kaszmirek/Inzynierka/thesis/my_thesis/sources/09_dodatek_datasheety.tex

\chapter{Schematy i noty katalogowe}
\markboth{Schematy i noty katalogowe}{Schematy i noty katalogowe}

\begin{figure}
    \centering
    
\end{figure}

\begin{figure}
    
\end{figure}

\begin{figure}
    
\end{figure}

\begin{figure}
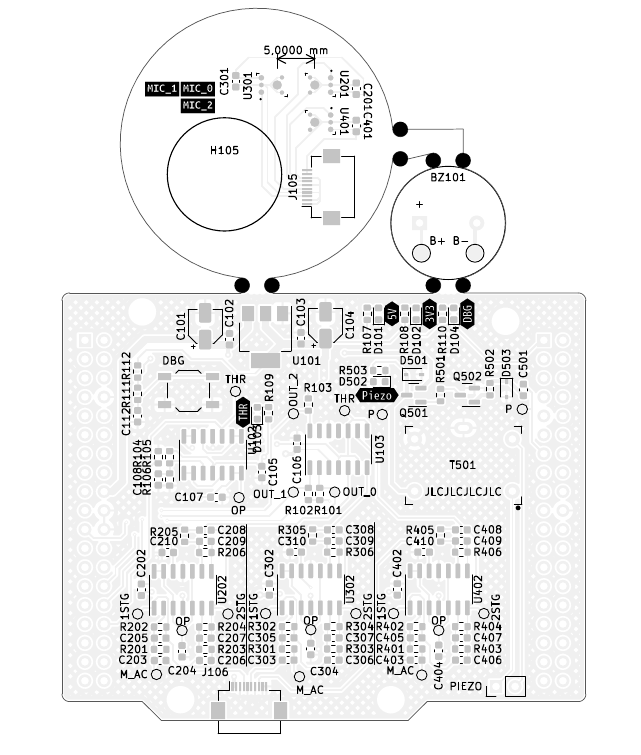
[picture p11: thesis/my_thesis/figures/chapter_09/board_render.png]
    
\end{figure}
