kaszmirek/Inzynierka/thesis/praca_dyplomowa_wzor/sources/07_dodatek_bakiem_malowane.tex

\chapter{Bąkiem malowane}
\markboth{Bąkiem malowane}{Bąkiem malowane}

Ponieważ niektóre otrzymywane ślady ruchu bąków bywały niezwykle artystyczne i wprawiały nas w zdumienie zdecydowaliśmy się pokazać co ciekawsze ku uciesze czytelnika. Zestaw śladów, który najbardziej przypadł nam do gustu przedstawiono na rysunku \ref{fig:top_life} \cite{Joniak}.
\begin{figure}[tp]
  \centering
  
  \caption{Atom}
\end{figure}
%
\begin{figure}[tp]
  \centering
  
  \caption{Słonecznik}
\end{figure}
%
\begin{figure}[tp]
  \centering
  
  \caption{Kwiat}
\end{figure}
%
\begin{figure}[tp]
  \centering
  
  \caption{Gwiazda}
\end{figure}
%
\begin{figure}[tp]
  \centering
  
  \caption{Paszcza}
\end{figure}
%
\begin{figure}[tp]
  \centering
  \subfloat{}
  \subfloat{}\\
  \subfloat{}
  \subfloat{}\\
  \subfloat{}
  \subfloat{}
  \caption{Życie bąka}
  \label{fig:top_life}
\end{figure}

{\red
  Czasami pojawia się potrzeba umieszczenia w~pracy dodatków. Wówczas
  wystarczy poprzedzić je poleceniem \texttt{\textbackslash appendix}
  i~voilà, mamy co potrzebowaliśmy. Tu można umieszczać rzeczy
  poboczne, kod programu, dowód jakiegoś twierdzenia, w~większej
  liczbie symulacje, wyniki, czy też może jakąś galerię \smiley}
