kaszmirek/Inzynierka/thesis/praca_dyplomowa_wzor/main.tex

%\documentclass[printmode,oneside,pl]{mgr}  % do publikacji elektronicznej
\documentclass[printmode,pl]{mgr}  % do wydruku dwustronnego
%\documentclass[printmode,pl,draft]{mgr}  % do wydruku dwustronnego w~wersji roboczej
%\documentclass[printmode,en]{mgr}  % do wydruku dwustronnego ze stroną tytułową w~wersji angielskiej

%----------------------| Wybór strony kodowej |------------------------

\usepackage[utf8]{inputenc}

%-------------------------| Wybór kroju pisma |------------------------

%% Najpierw (chyba) należy wybrać czcionkę tekstu, potem matematyki
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
%\usepackage{fancyhdr}
%\usepackage{fancyvrb}
%\usepackage{lipsum}  
%\usepackage{listings}  %% alternatywa do używanego tutaj pakietu minted 

%-----------------------| End of pakietologia |----------------------

%---------------------------| Tytularia |---------------------------

% Zmień dane stosownie do tytułu i autora pracy tutaj
% ALE TEŻ I W POLECENIU \pdftitle NIECO PONIŻEJ! (Hyper data general configuration)
\author{Roberto Orozco\\{\color{red}Robert Muszyński\\\footnotesize (kompilacja \today)}}
\title{Bąk jaki jest każdy widzi. Studium zachowań\\{\em\color{red} Przykład
    i~wytyczne formatowania\\ pracy dyplomowej}}
\engtitle{Top is a top. Case study}
\supervisor{Dr inż. Robert Muszyński,\\ Katedra Cybernetyki i~Robotyki}
\field{Automatyka i~Robotyka (AIR)}
\specialisation{Robotyka (ARR)}
\date{2022}

%-------------------------| Hyper data general configuration |------------------------

\hypersetup{unicode,
                          % DANE DOKUMENTACJI
   pdfauthor={Roberto Orozco, Robert Muszyński},
   pdftitle={Bąk jaki jest każdy widzi. Studium zachowań - Przykład
    i~wytyczne formatowania pracy dyplomowej},
   pdfsubject={Praca dyplomowa inżynierska - przykład i~wytyczne},
   pdfkeywords={bąk, Lagrange top, Euler top, praca dyplomowa, formatowanie, wytyczne},
                          % USTAWIENIA DOKUMENTU
   pdfpagemode=UseOutlines,   % otwiera dokument w trybie jednej strony
   pdfpagelayout=SinglePage,  %
   pdfstartview={Fit},        %
   pdfstartpage=1,            % na podanej stronie
   bookmarksopen=true,        % rozwinięcie zakładek
   bookmarksopenlevel=1,      % do jakiego poziomu
   colorlinks=true,       % kolorowanie odnośników zamiast ramki wokół nich
   breaklinks,            %
   citecolor=cyan,        % kolor odnośników do bibliografii, domyślnie zielony
   filecolor=red,         % kolor odnośników do lokalnych plików, domyśnie magenta
   linkcolor=blue,        % kolor odnośników wewnętrznych, domyślnie czerwony
   menucolor=green,       % kolor pozycji menu Acrobata, domyślnie czerwony
   urlcolor=blue          % kolor odnośników do adresów internetowych, domyślnie cyan
}

%-------------------------| Geometria strony |-----------------------------

\geometry{
    top = 25mm,
    headheight = 15mm,
    headsep = 3mm,
    textheight = 24cm,
    textwidth = 16cm,
    marginparwidth = 25mm
}

%---------------------| Często używane polecenia |-------------------

\newcommand{\red}{\color{red}}
\def\BibTeX{{\rm B\kern-.05em{\sc i\kern-.025em b}\kern-.08em
    T\kern-.1667em\lower.7ex\hbox{E}\kern-.125emX}}

\newtheorem{uwaga}{Uwaga}
\newtheorem{twr}{Twierdzenie}
%------------------------------------| END |-------------------------------------

%----------------------------| Definicje symboli matematycznych |-------------------------

\newcommand{\angmom}{\boldsymbol{m}}
\newcommand{\bdvelo}{\boldsymbol{\omega}_B}
\newcommand{\grav}{\boldsymbol{g}}
\newcommand{\lagran}{L(\boldsymbol{q},\boldsymbol{\dot{q}})}
\newcommand{\COMvec}{\boldsymbol{r}_B}
\newcommand{\ee}{\boldsymbol{e}}
\newcommand{\FF}{\boldsymbol{F}}
\newcommand{\xx}{\boldsymbol{x}}
\newcommand{\qq}{\boldsymbol{q}}
\newcommand{\RR}{\boldsymbol{R}}
\newcommand{\TT}{\boldsymbol{T}}
\newcommand{\pp}{\boldsymbol{p}}
\newcommand{\iner}{\boldsymbol{I}_B}
\newcommand{\vv}{\boldsymbol{v}}
\newcommand{\bbs}{\boldsymbol}
\DeclareMathOperator{\const}{const}
\DeclareMathOperator*{\rank}{rank}  %star changes sub- and superscripts placement
%------------------------------------| END |-------------------------------------

%--------------------------| Ścieżki do rysunków |-------------------------------

\graphicspath{{./figures/chapter_01/}{./figures/chapter_02/}{./figures/chapter_03/}{./figures/chapter_04/}}

%--------| kontrola dołączanych plików - wygodne przy pracy nad tekstem |--------

%\includeonly{sources/Od_Autora,sources/02_czym_jest_bak}

%-------------------------| The document starts here |-------------------------------
\begin{document}

\pdfbookmark{Strona tytułowa}{tytul}
\maketitle
%% informacja o sposobie udostępniania tego dokumentu
\input{sources/copyleft.tex}

%% dedykacja
%%\dedication{6cm}{To jest przykładowa treść opcjonalnej dedykacji,
%%  należy ją zmienić lub usunąć w całości polecenie
%%  \texttt{\textbackslash dedication}}

\cleardoublepage
\pdfbookmark{\contentsname}{Contents}
\tableofcontents            %spis treści
\markboth{\contentsname}{\contentsname}
\input{sources/notka}       %notka o systemie składu i czcionkach
%\input{sources/font-note}   %przykładowa wersja angielska notki - używa pakietu biblatex

%---------------------------| Część właściwa dokumentu |---------------------------

\include{sources/Od_Autora}
\include{sources/00_Wstep}
\include{sources/01_wprowadzenie_matematyczne}
\include{sources/02_czym_jest_bak}
\include{sources/05_zakonczenie}

\cleardoublepage
\phantomsection
\addcontentsline{toc}{chapter}{\bibname}
\bibliographystyle{alphapl}
\bibliography{sources/bibliografia}
\markboth{\bibname}{\bibname}   % to niestety nie działa by usunąć MakeUppercase z~nagłówków w~literaturze

%%spis tabel
%\cleardoublepage
%\phantomsection
%\listoftables
%\addcontentsline{toc}{chapter}{\listtablename}
%\markboth{\listtablename}{\listtablename}

%%spis rysunków
\cleardoublepage
\phantomsection
\addcontentsline{toc}{chapter}{\listfigurename}
\listoffigures
\markboth{\listfigurename}{\listfigurename}

\appendix
\include{sources/07_dodatek_bakiem_malowane}

%% lista rzeczy do zrobienia
\listoftodos

\end{document}
