kaszmirek/Inzynierka/thesis/praca_dyplomowa_wzor/svg-inkscape/e1_plot_1_svg-tex.pdf

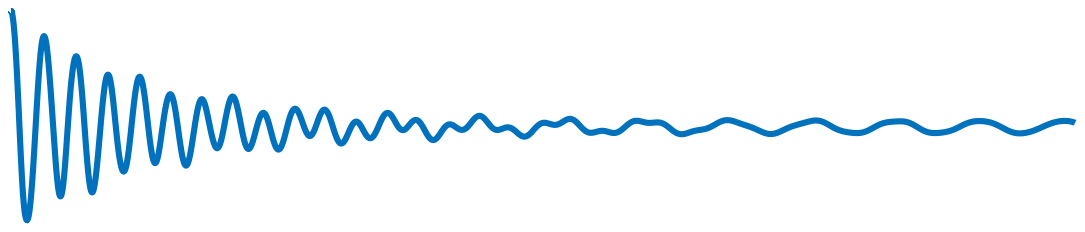
[picture p29: page 3]
