kaszmirek/Inzynierka/thesis/praca_dyplomowa_wzor/figures/chapter_02/dynamic-lin.pdf

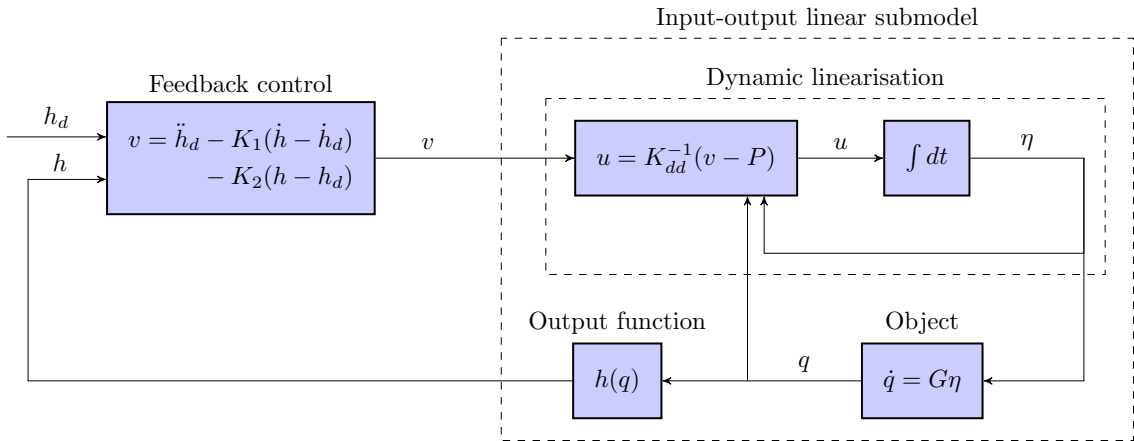
[picture p30: figure]
Feedback control; Object; Output function; Input-output linear submodel; Dynamic linearisation
