kaszmirek/Inzynierka/thesis/praca_dyplomowa_wzor/figures/chapter_02/dynamic-lin_ink.pdf

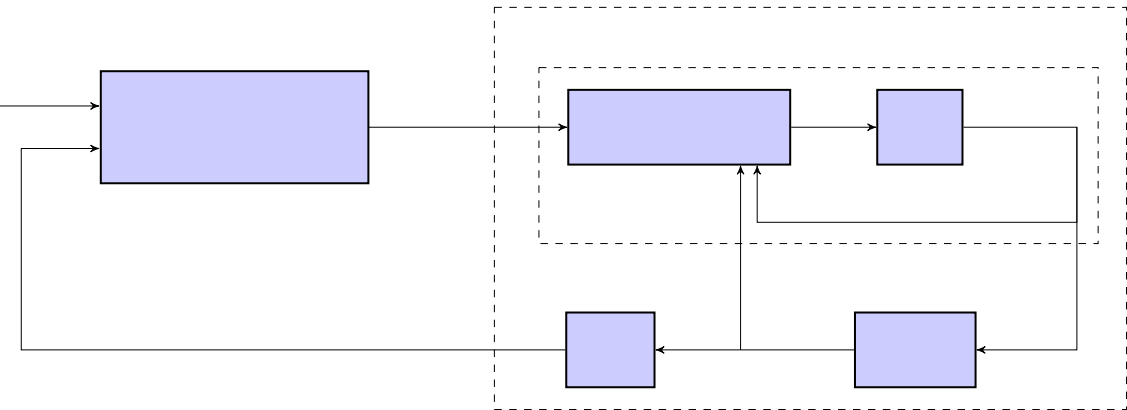
[picture p31: figure]
