kaszmirek/Inzynierka/thesis/praca_dyplomowa_wzor/figures/chapter_02/legendre_fv_interp.pdf

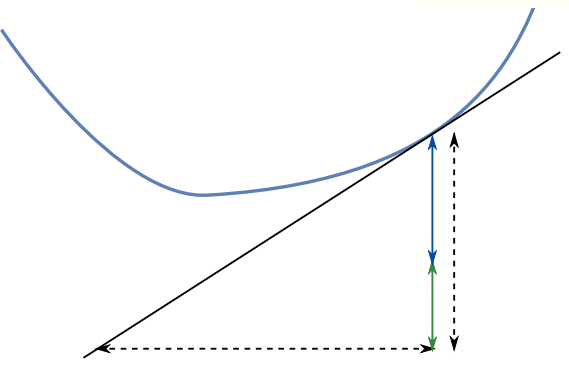
[picture p32: figure]
