kaszmirek/Inzynierka/thesis/praca_dyplomowa_wzor/figures/chapter_02/przemieszczenie.pdf

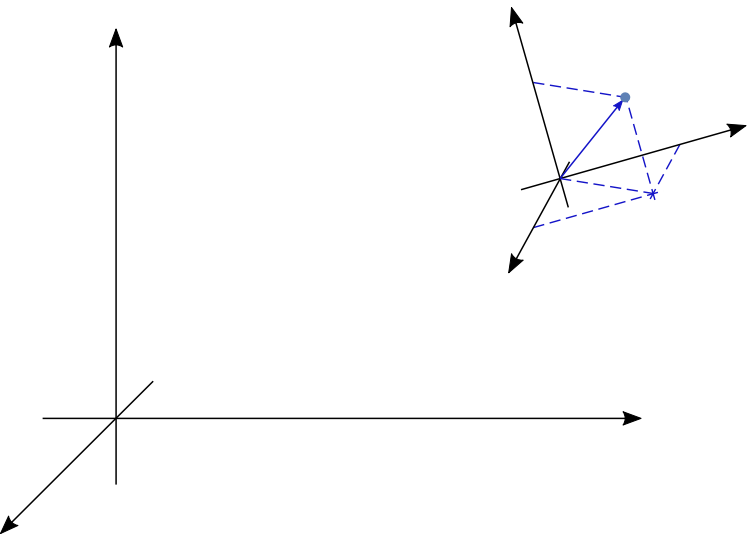
[picture p33: figure]

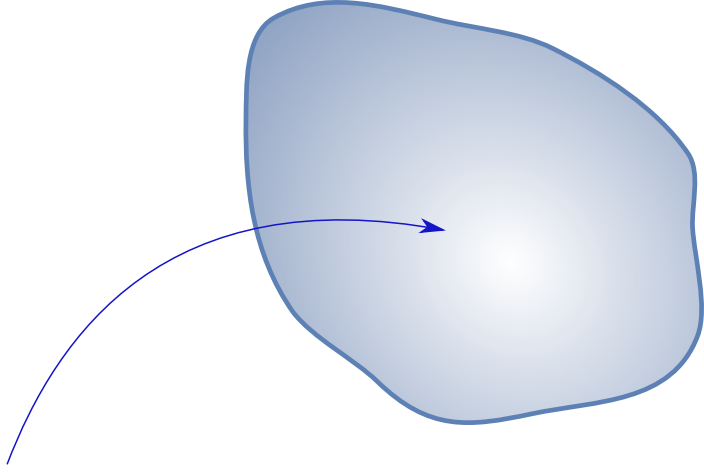
[picture p34: figure]
