kaszmirek/Inzynierka/thesis/praca_dyplomowa_wzor/figures/chapter_03/bak_eulera.pdf

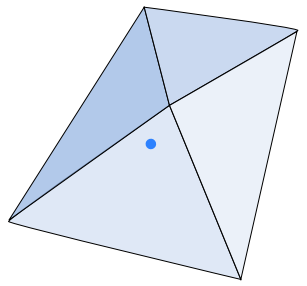
[picture p35: figure]
