kaszmirek/Inzynierka/thesis/praca_dyplomowa_wzor/figures/chapter_03/bak_lagrangea1.pdf

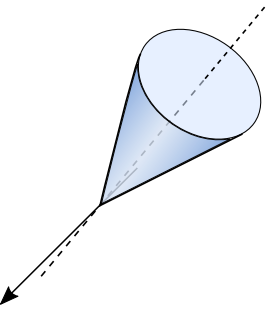
[picture p36: figure]
