kaszmirek/Inzynierka/thesis/praca_dyplomowa_wzor/figures/chapter_03/bak_ogolnie.pdf

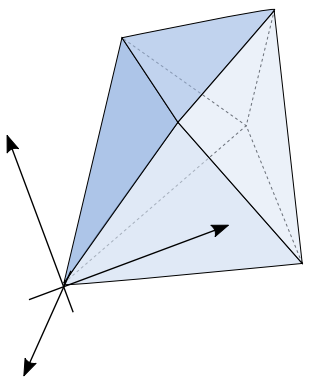
[picture p37: figure]
