kaszmirek/Inzynierka/thesis/praca_dyplomowa_wzor/figures/chapter_04/elipsoida1a.pdf

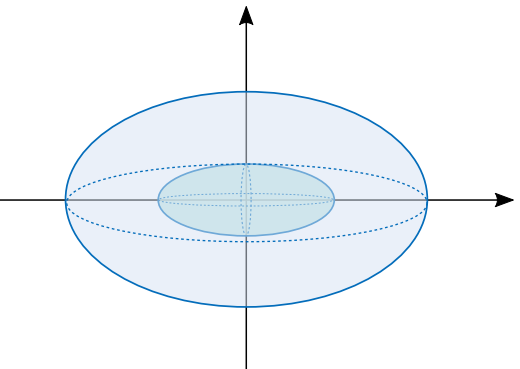
[picture p38: figure]
