kaszmirek/Inzynierka/thesis/praca_dyplomowa_wzor/figures/chapter_04/elipsoida1b.pdf

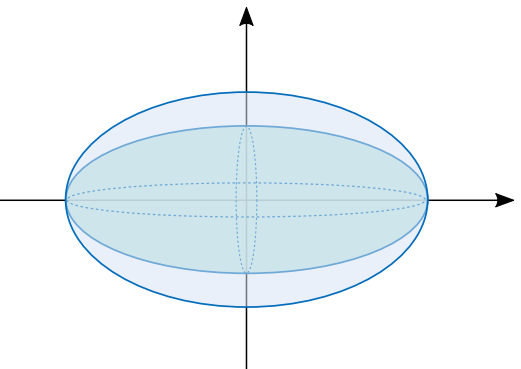
[picture p39: figure]
