kaszmirek/Inzynierka/thesis/praca_dyplomowa_wzor/figures/chapter_04/elipsoida1c.pdf

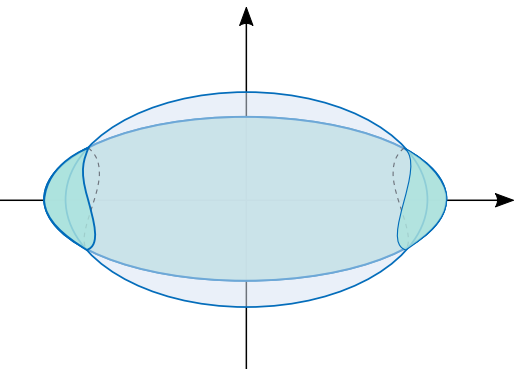
[picture p40: figure]
