kaszmirek/Inzynierka/thesis/praca_dyplomowa_wzor/figures/chapter_04/elipsoida1d.pdf

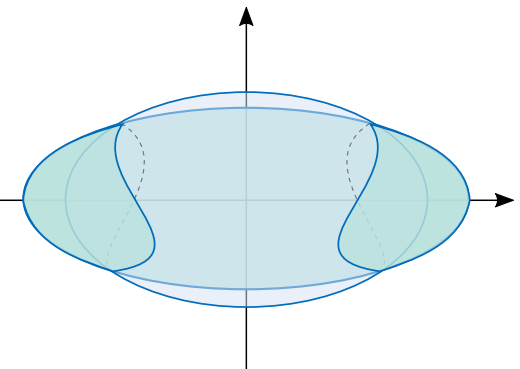
[picture p41: figure]
