kaszmirek/Inzynierka/thesis/praca_dyplomowa_wzor/figures/chapter_04/elipsoida1e.pdf

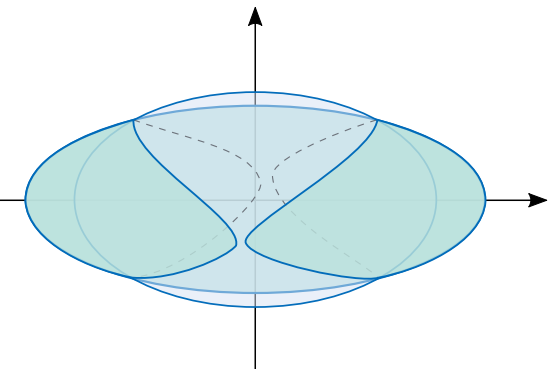
[picture p42: figure]
