kaszmirek/Inzynierka/thesis/praca_dyplomowa_wzor/figures/chapter_04/elipsoida_obrotowa.pdf

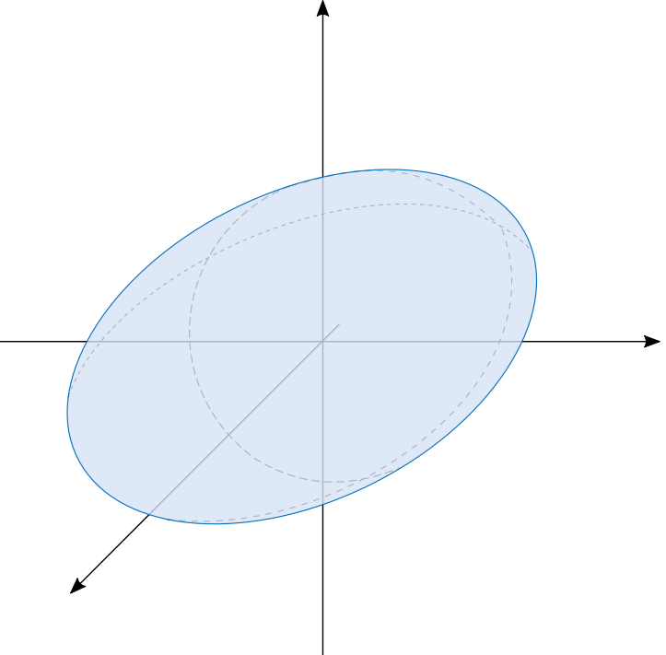
[picture p47: figure]
