kaszmirek/Inzynierka/thesis/praca_dyplomowa_wzor/figures/chapter_04/euler_sym_portret.pdf

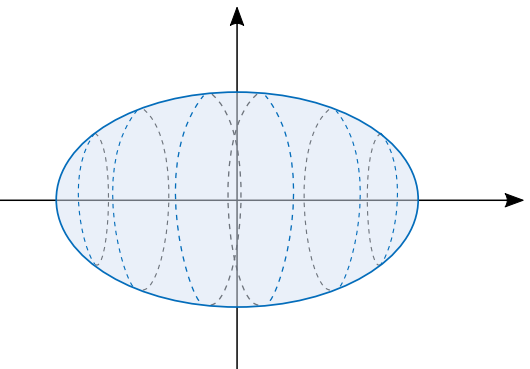
[picture p48: figure]
