kaszmirek/Inzynierka/thesis/praca_dyplomowa_wzor/figures/chapter_04/herpolhodia.pdf

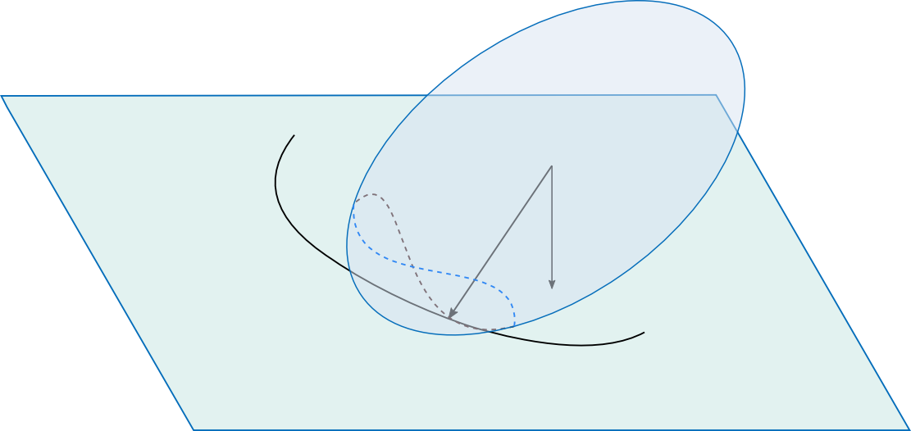
[picture p49: figure]
