kaszmirek/Inzynierka/thesis/praca_dyplomowa_wzor/figures/chapter_04/lu_mniejsze.pdf

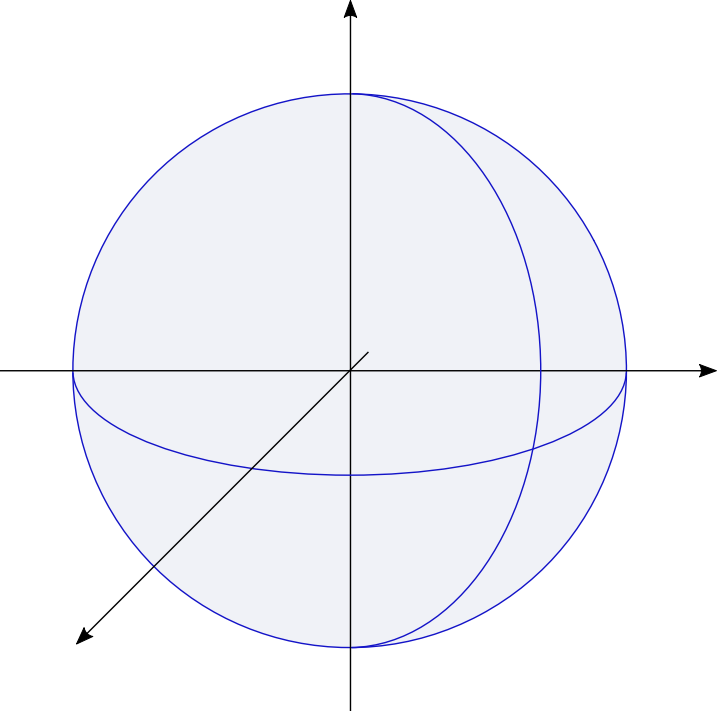
[picture p50: figure]

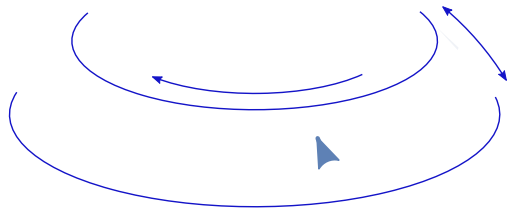
[picture p51: figure]

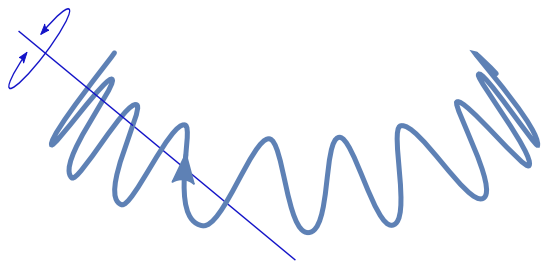
[picture p52: figure]
