kaszmirek/Inzynierka/thesis/praca_dyplomowa_wzor/figures/chapter_04/lu_w_punkt.pdf

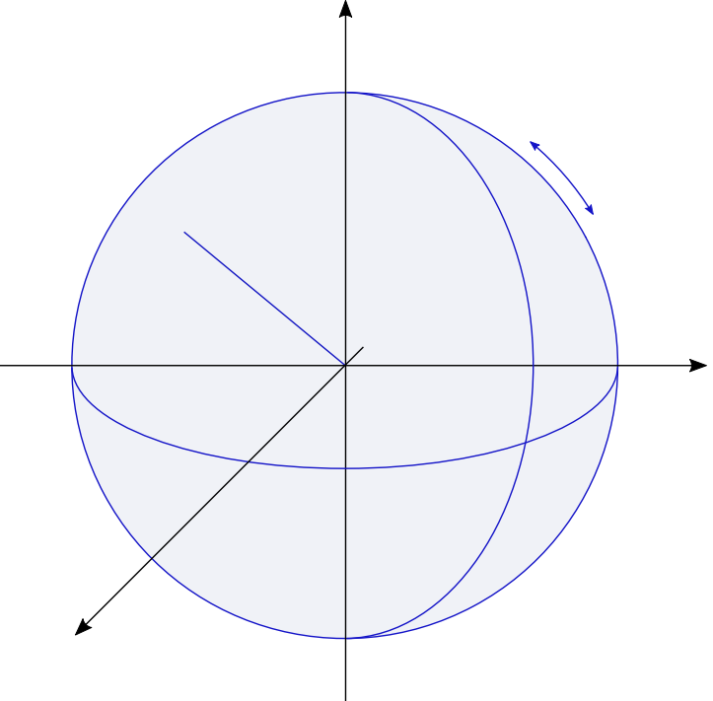
[picture p53: figure]

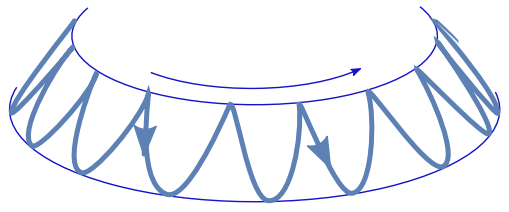
[picture p54: figure]
