kaszmirek/Inzynierka/thesis/praca_dyplomowa_wzor/figures/chapter_04/lu_zmienne.pdf

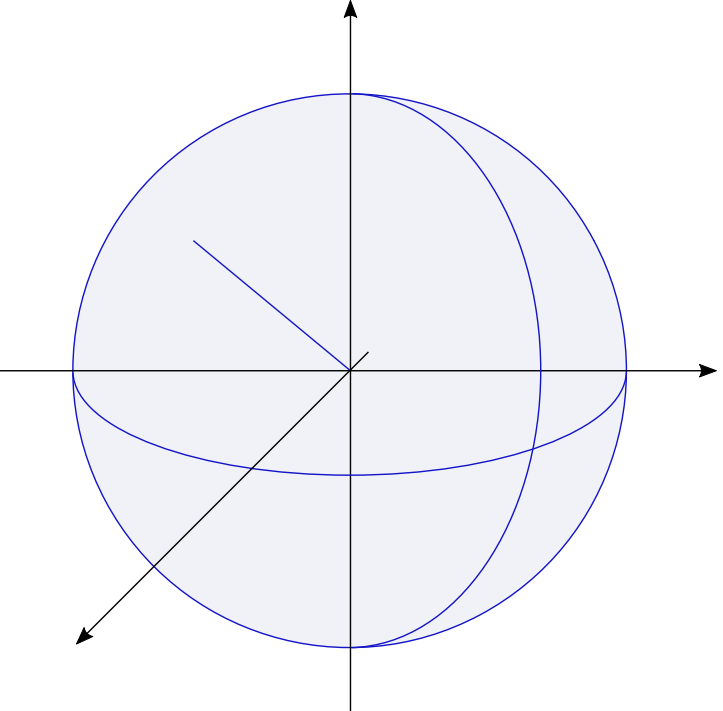
[picture p55: figure]

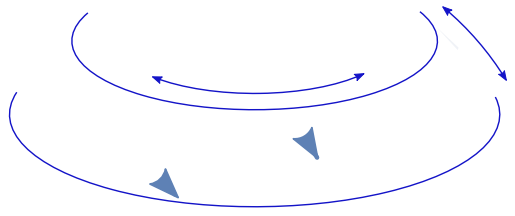
[picture p56: figure]

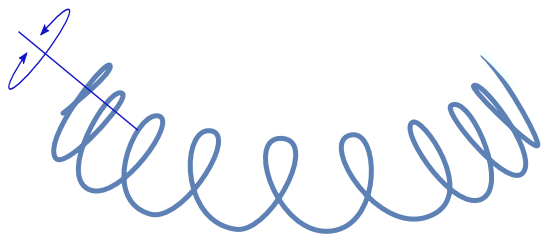
[picture p57: figure]
