kaszmirek/Inzynierka/thesis/praca_dyplomowa_wzor/figures/chapter_04/portret_fazowy.pdf

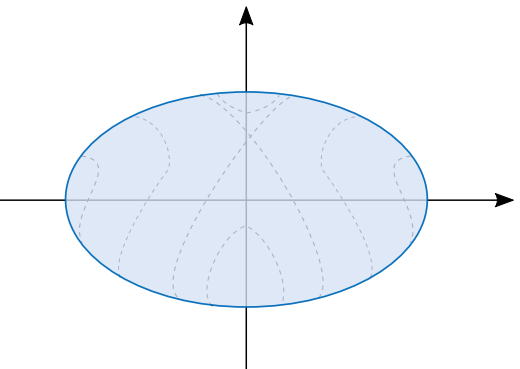
[picture p58: figure]

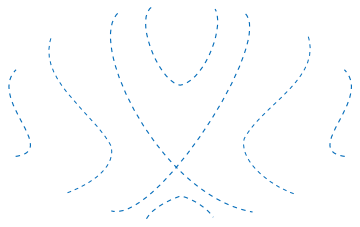
[picture p59: figure]
