kaszmirek/Inzynierka/thesis/praca_dyplomowa_wzor/figures/chapter_05/euler_niesym_elips.pdf

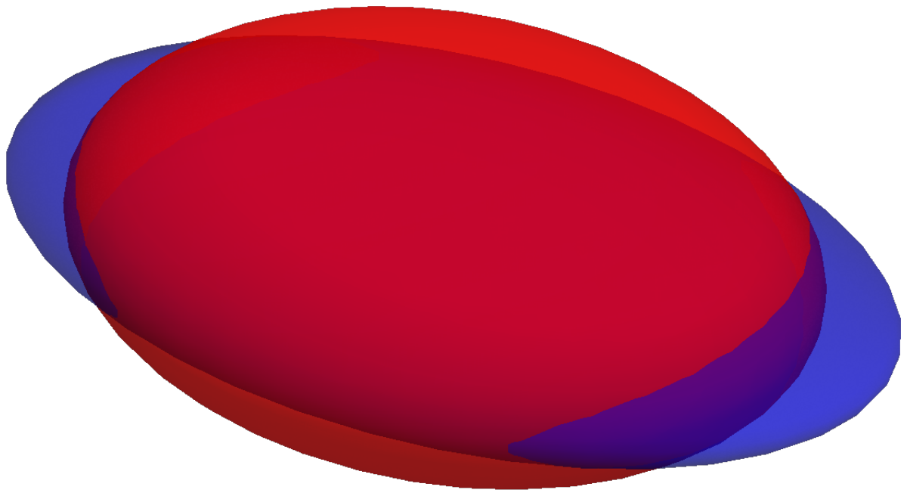
[picture p60: page 1]
