kaszmirek/Inzynierka/thesis/praca_dyplomowa_wzor/figures/chapter_05/euler_niesym_pol.pdf

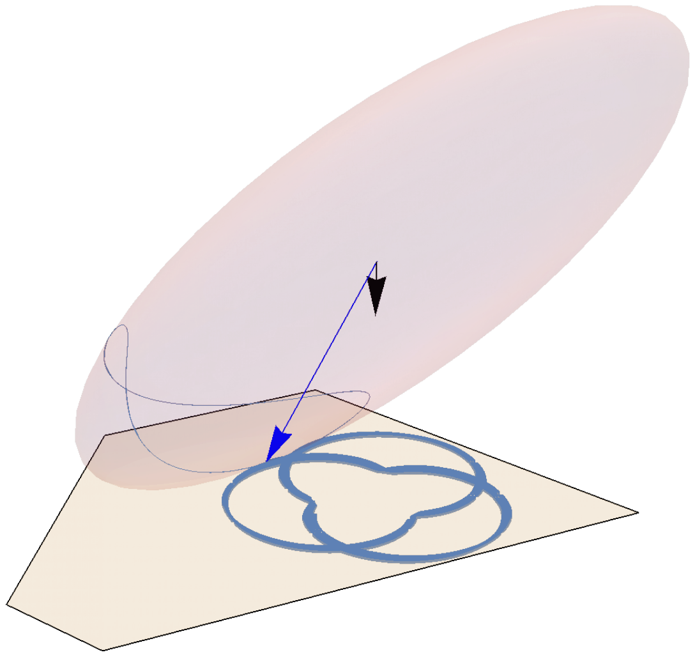
[picture p61: page 1]
