kaszmirek/Inzynierka/thesis/praca_dyplomowa_wzor/figures/chapter_05/euler_sym_elips.pdf

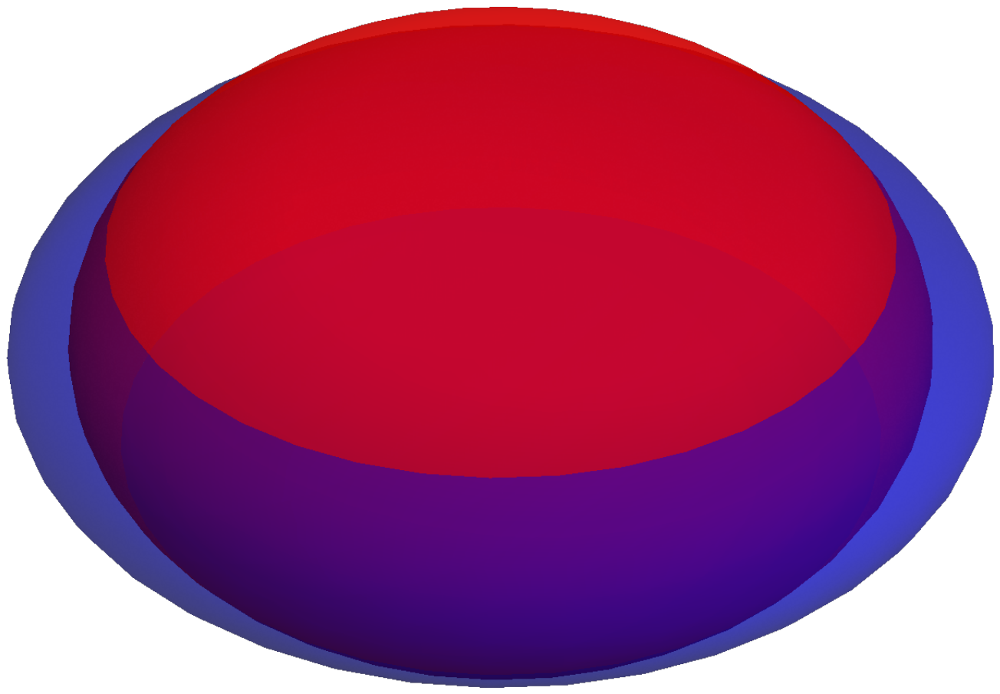
[picture p62: page 1]
