kaszmirek/Inzynierka/thesis/praca_dyplomowa_wzor/figures/chapter_05/euler_sym_pol.pdf

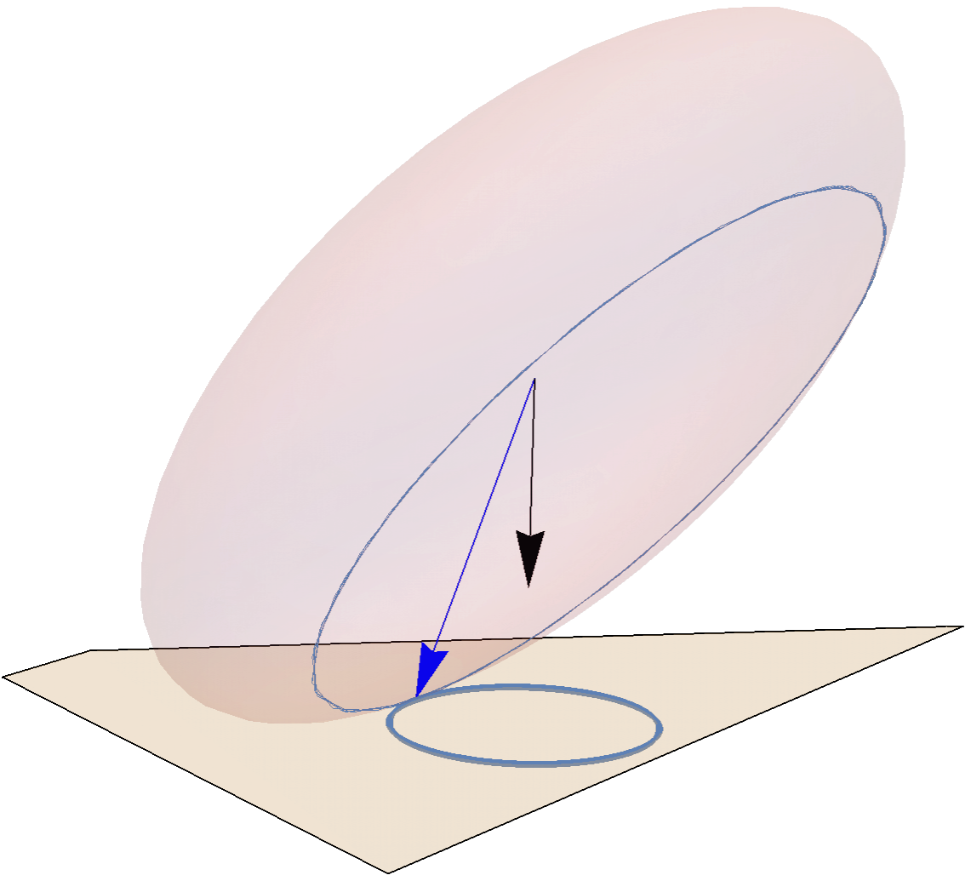
[picture p63: page 1]
