kaszmirek/Inzynierka/thesis/praca_dyplomowa_wzor/figures/chapter_05/sim1_traj.pdf

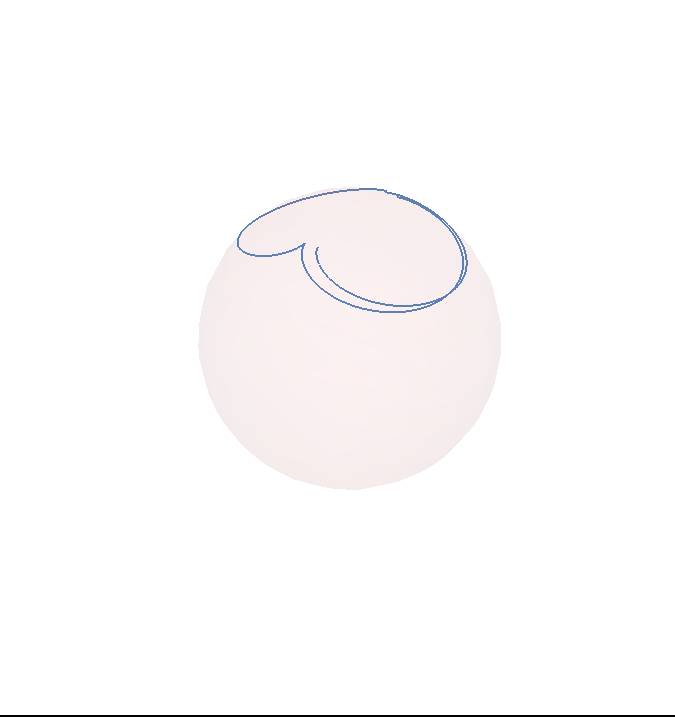
[picture p64: page 1]
