kaszmirek/Inzynierka/thesis/praca_dyplomowa_wzor/figures/chapter_05/sim2_traj.pdf

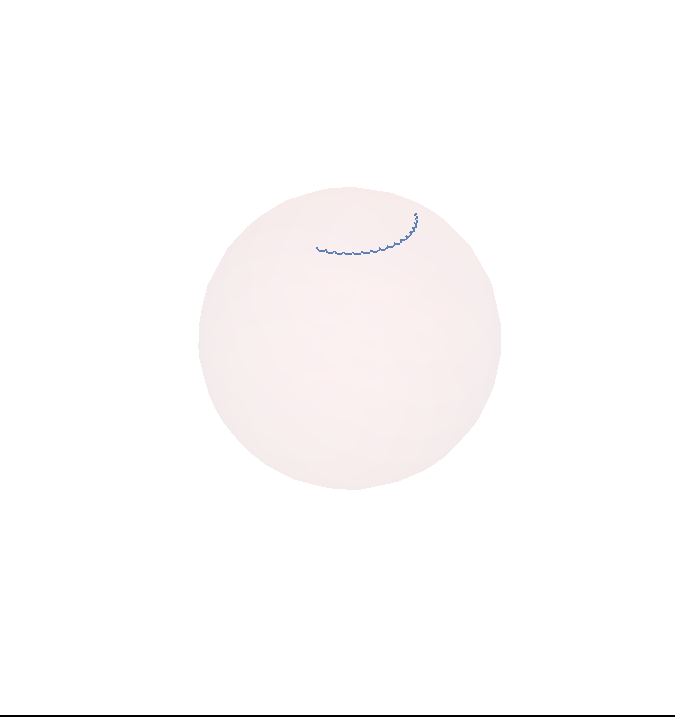
[picture p65: page 1]
