kaszmirek/Inzynierka/thesis/praca_dyplomowa_wzor/figures/chapter_05/sim3_a.pdf

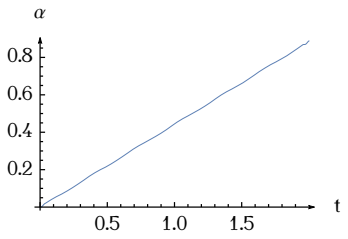
[picture p66: figure]
