kaszmirek/Inzynierka/thesis/praca_dyplomowa_wzor/figures/chapter_05/sim3_traj.pdf

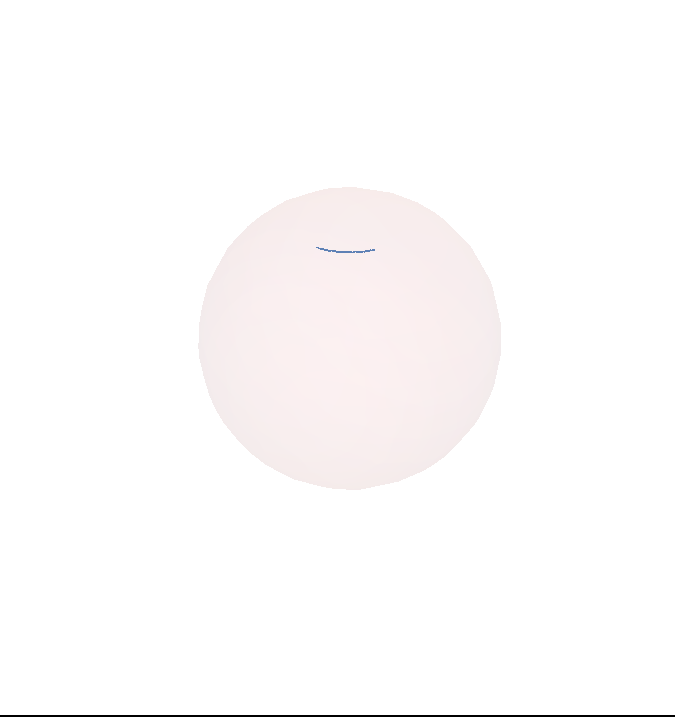
[picture p67: page 1]
