kaszmirek/Inzynierka/thesis/praca_dyplomowa_wzor/figures/chapter_05/ul1_fu.pdf

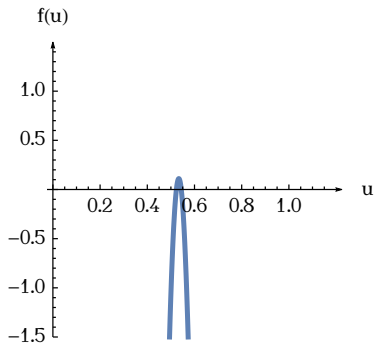
[picture p68: figure]
