kaszmirek/Inzynierka/thesis/praca_dyplomowa_wzor/figures/chapter_05/ul1_trace.pdf

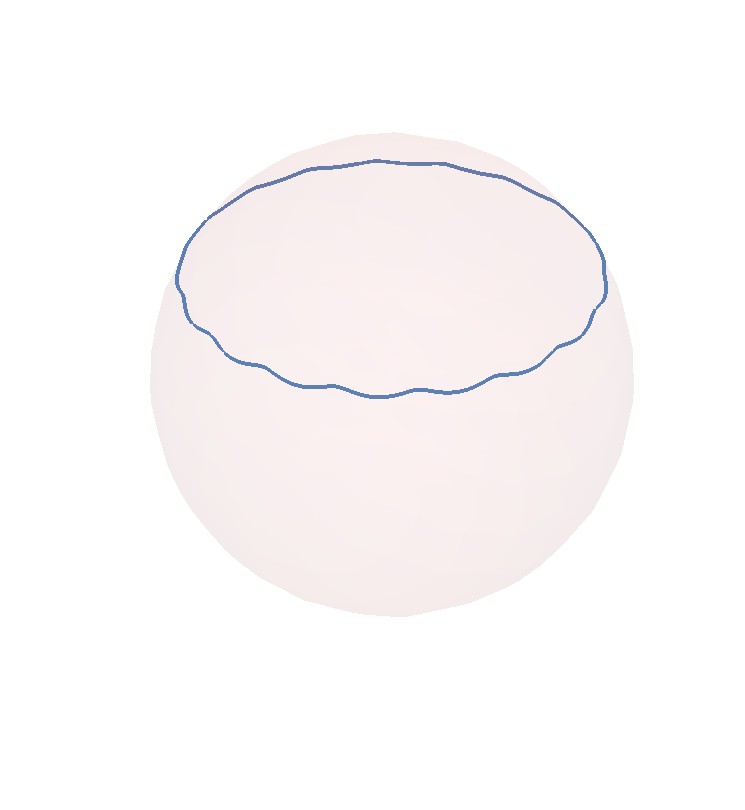
[picture p69: page 1]
