kaszmirek/Inzynierka/thesis/praca_dyplomowa_wzor/figures/chapter_05/ul2_fu.pdf

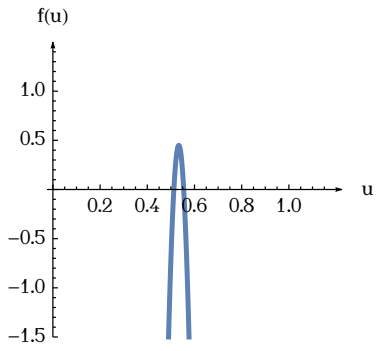
[picture p70: figure]
