kaszmirek/Inzynierka/thesis/praca_dyplomowa_wzor/figures/chapter_05/ul2_trace.pdf

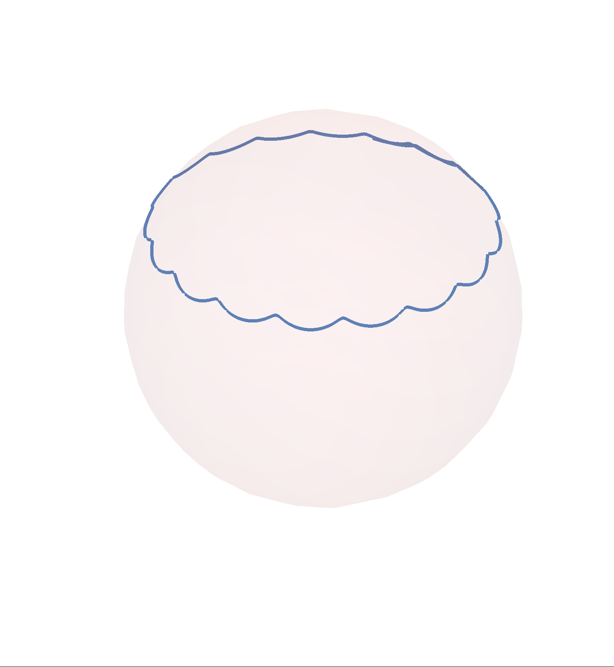
[picture p71: page 1]
