kaszmirek/Inzynierka/thesis/praca_dyplomowa_wzor/figures/chapter_05/ul3_fu.pdf

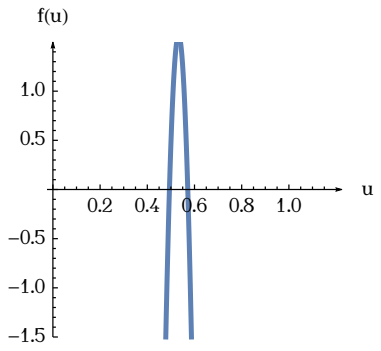
[picture p72: figure]
