kaszmirek/Inzynierka/thesis/praca_dyplomowa_wzor/figures/chapter_05/ul3_trace.pdf

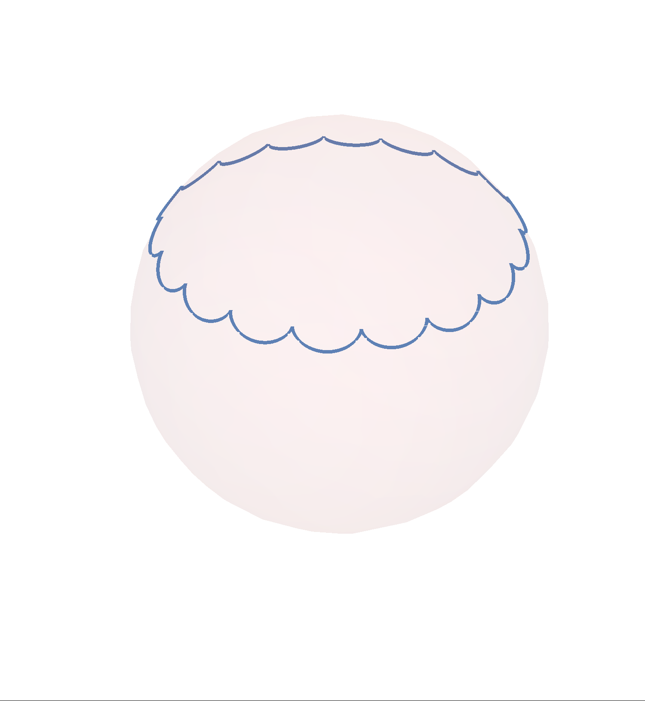
[picture p73: page 1]
