kaszmirek/Inzynierka/thesis/praca_dyplomowa_wzor/figures/chapter_05/ul4_fu.pdf

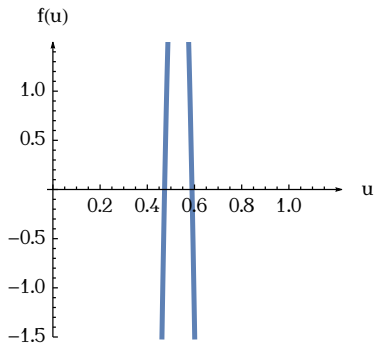
[picture p74: figure]
