kaszmirek/Inzynierka/thesis/praca_dyplomowa_wzor/figures/chapter_05/ul4_trace.pdf

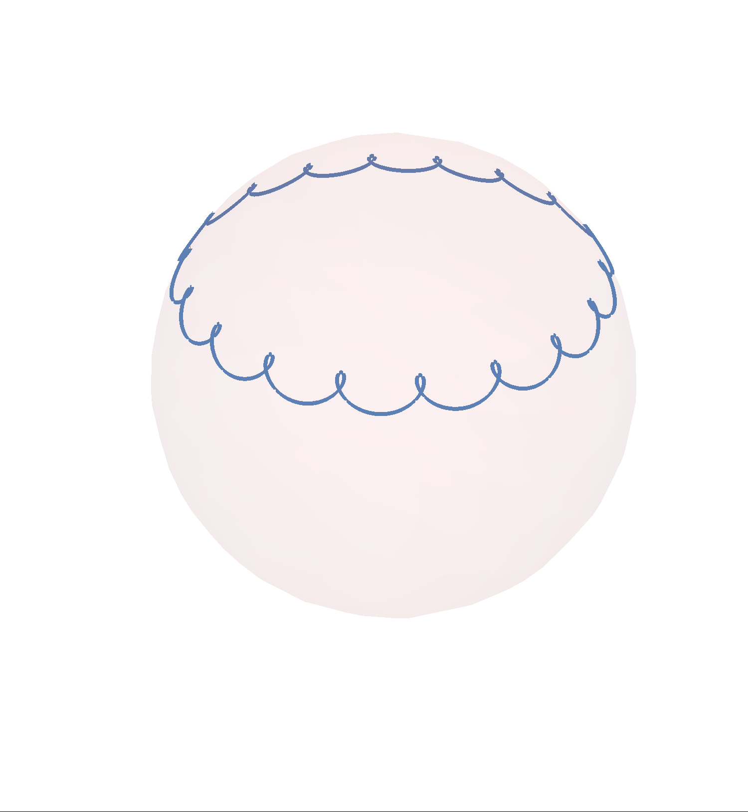
[picture p75: page 1]
