kaszmirek/Inzynierka/thesis/praca_dyplomowa_wzor/figures/chapter_05/ul5_trace.pdf

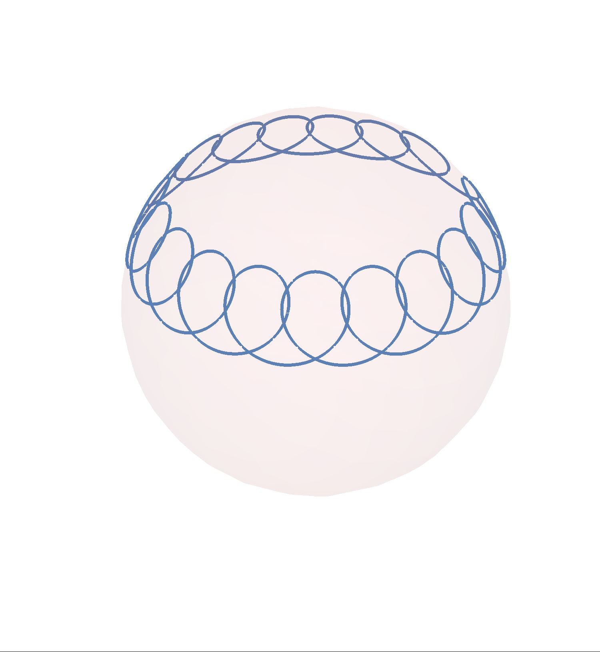
[picture p76: page 1]
