kaszmirek/Inzynierka/thesis/praca_dyplomowa_wzor/figures/chapter_06/mal2.pdf

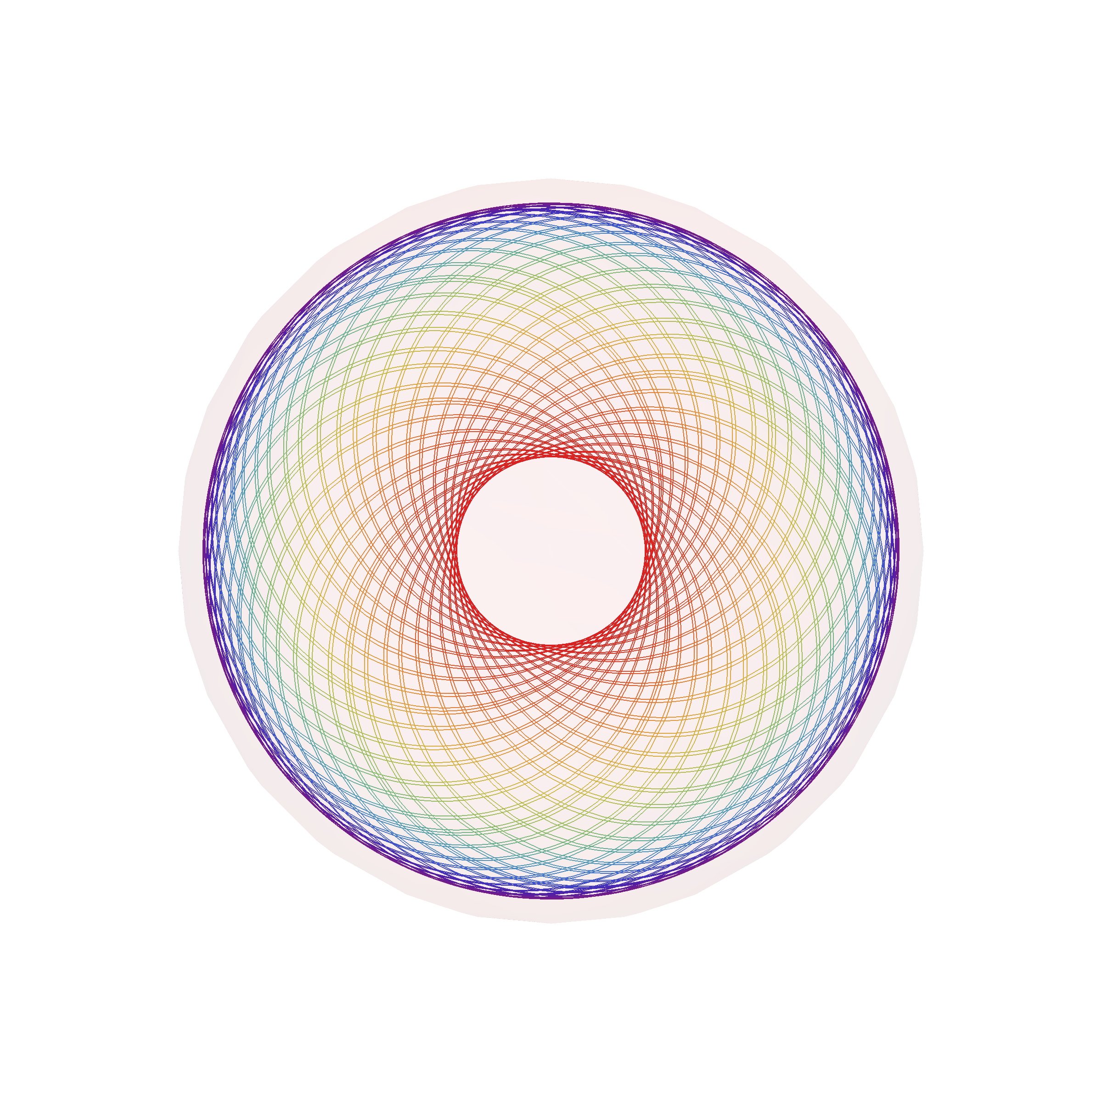
[picture p77: page 1]
