kaszmirek/Inzynierka/thesis/praca_dyplomowa_wzor/figures/chapter_06/mal3.pdf

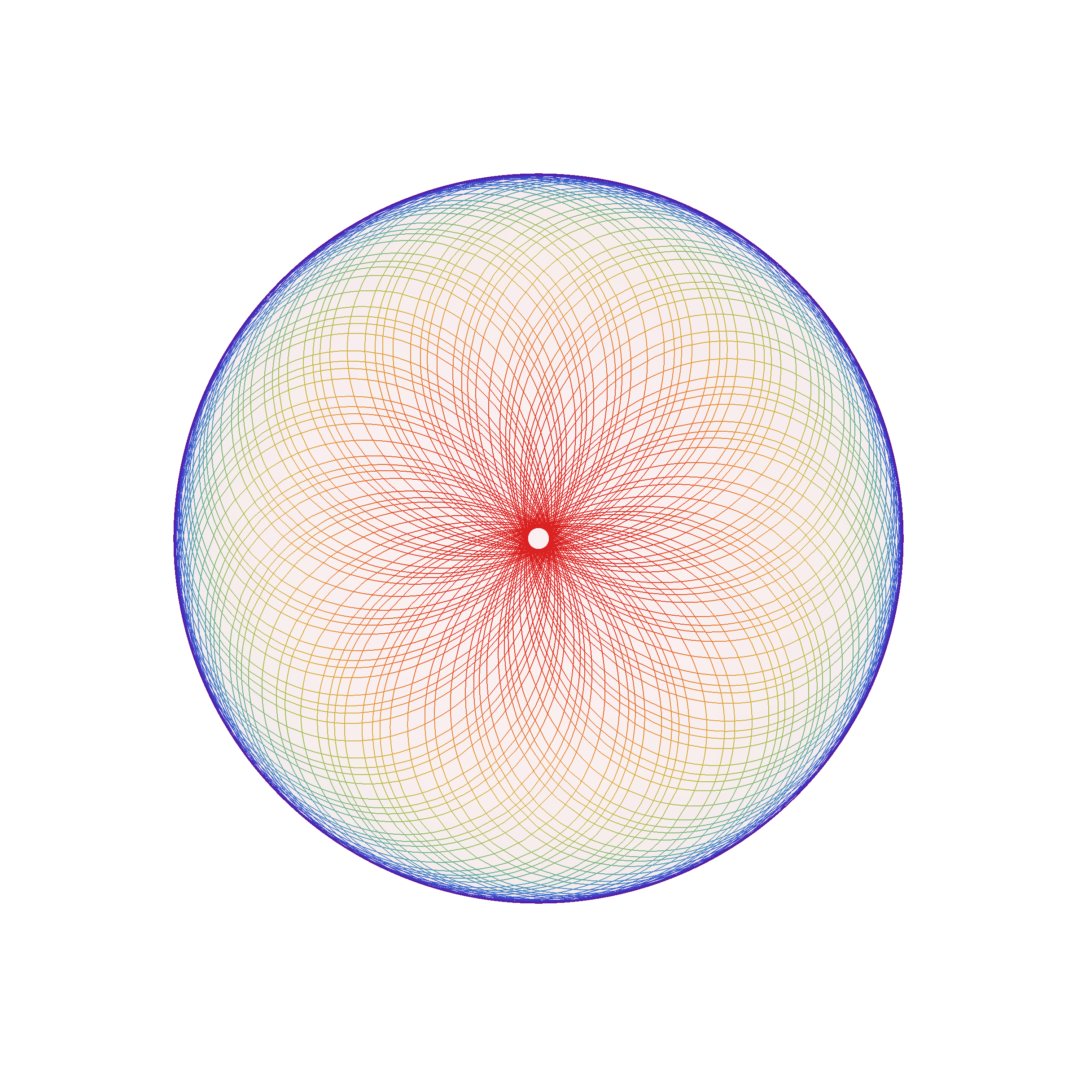
[picture p78: page 1]
