kaszmirek/Inzynierka/thesis/praca_dyplomowa_wzor/figures/chapter_06/mal4.pdf

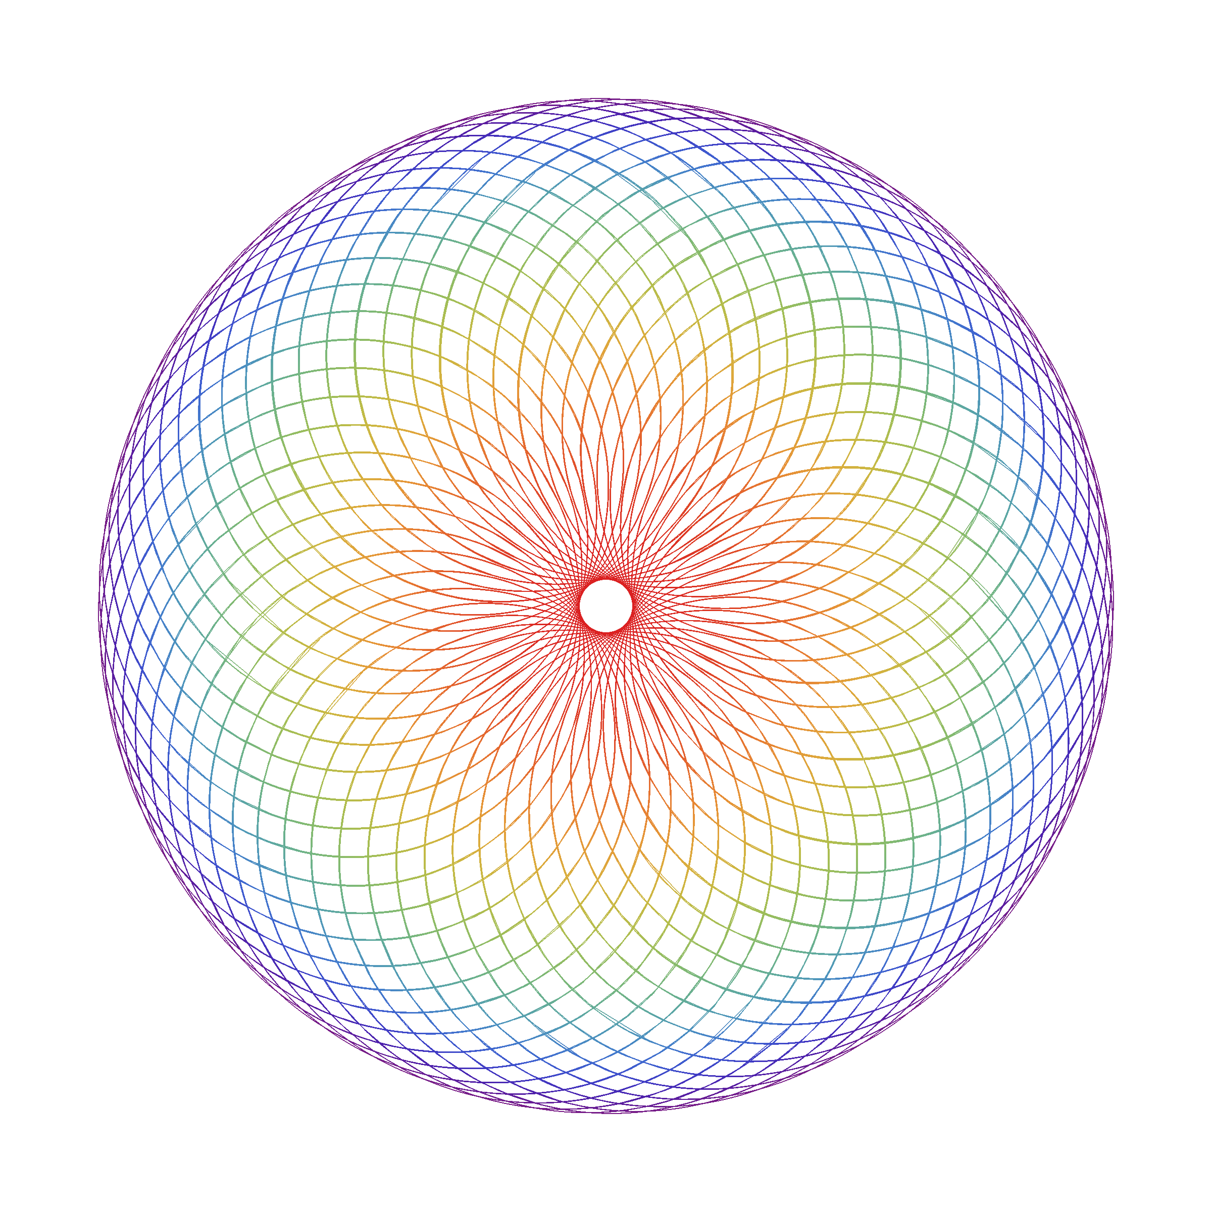
[picture p79: page 1]
