kaszmirek/Inzynierka/thesis/praca_dyplomowa_wzor/figures/chapter_06/mal5.pdf

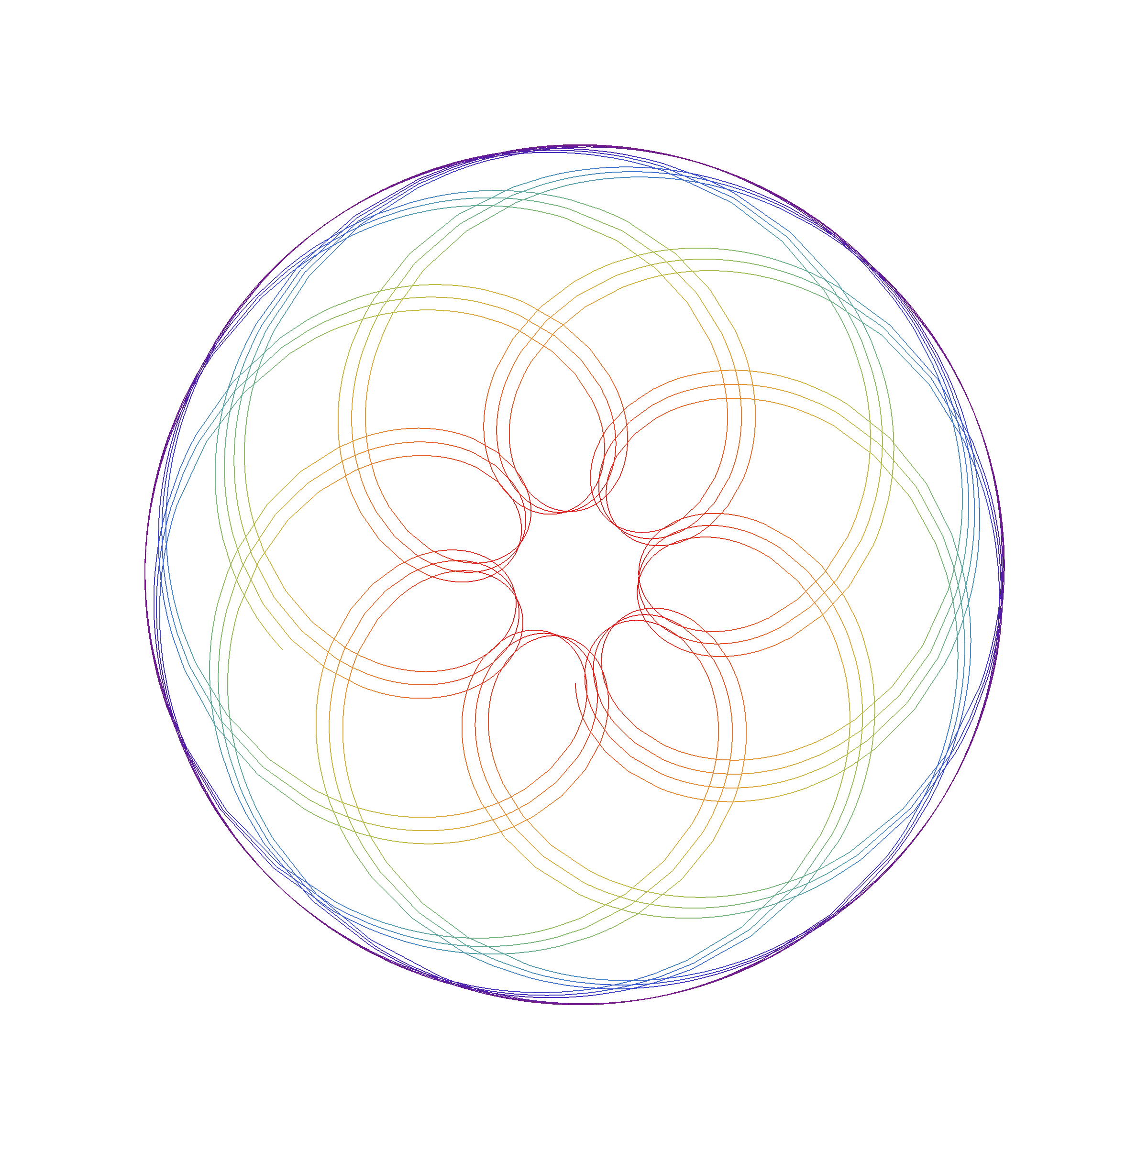
[picture p80: page 1]
