kaszmirek/Inzynierka/thesis/praca_dyplomowa_wzor/figures/chapter_06/mal6.pdf

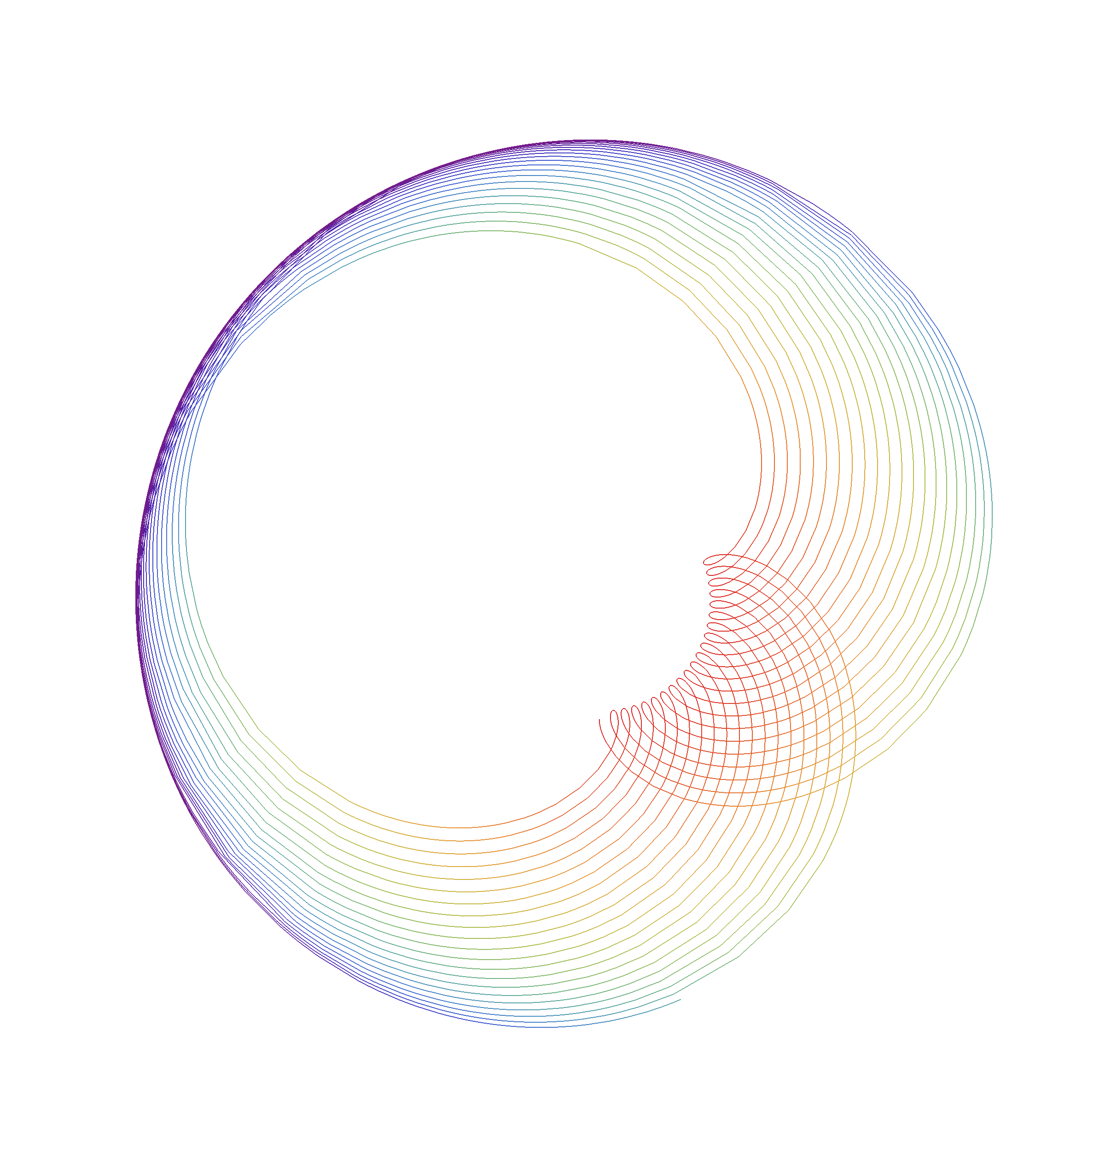
[picture p81: page 1]
