kaszmirek/Inzynierka/thesis/praca_dyplomowa_wzor/figures/chapter_06/mal7a.pdf

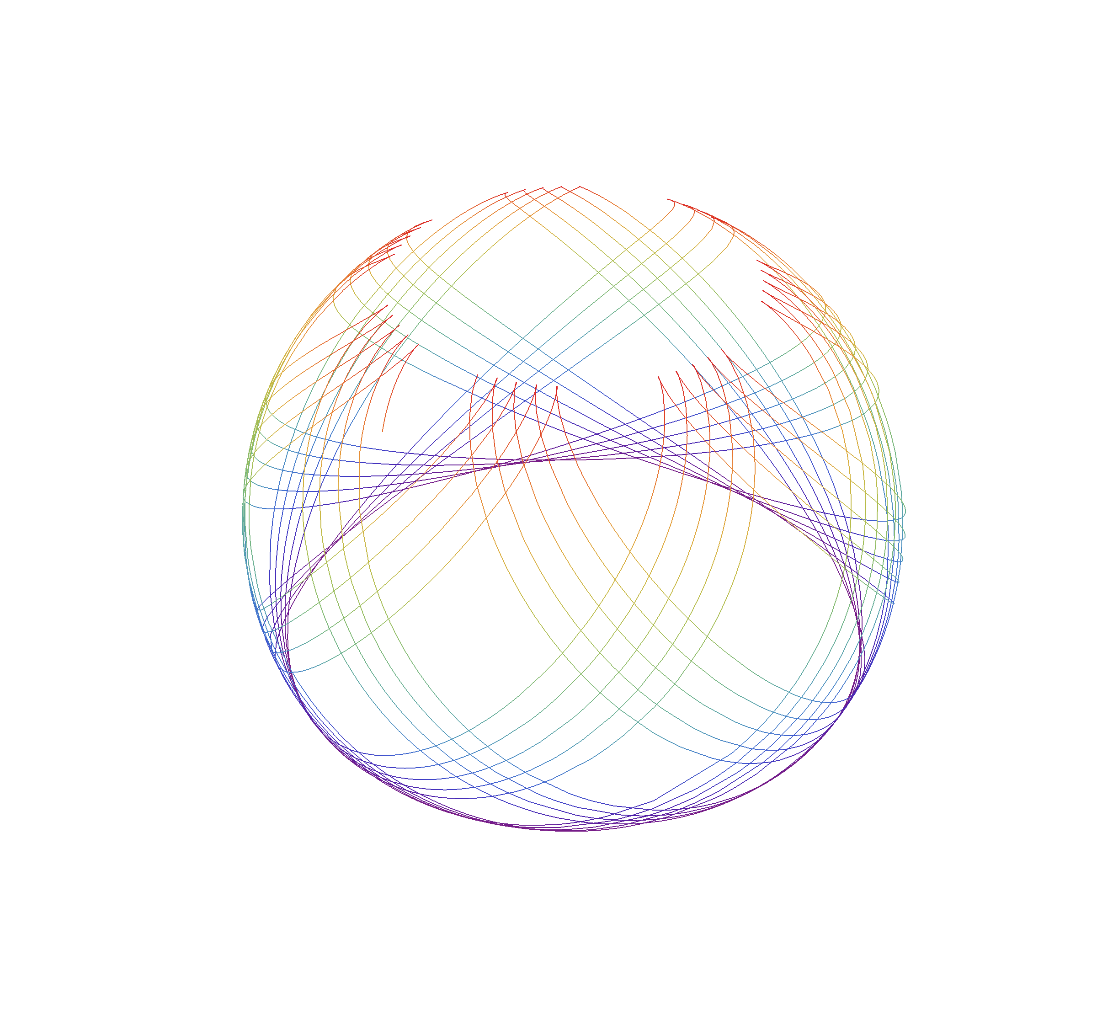
[picture p82: page 1]
