kaszmirek/Inzynierka/thesis/praca_dyplomowa_wzor/figures/chapter_06/mal7b.pdf

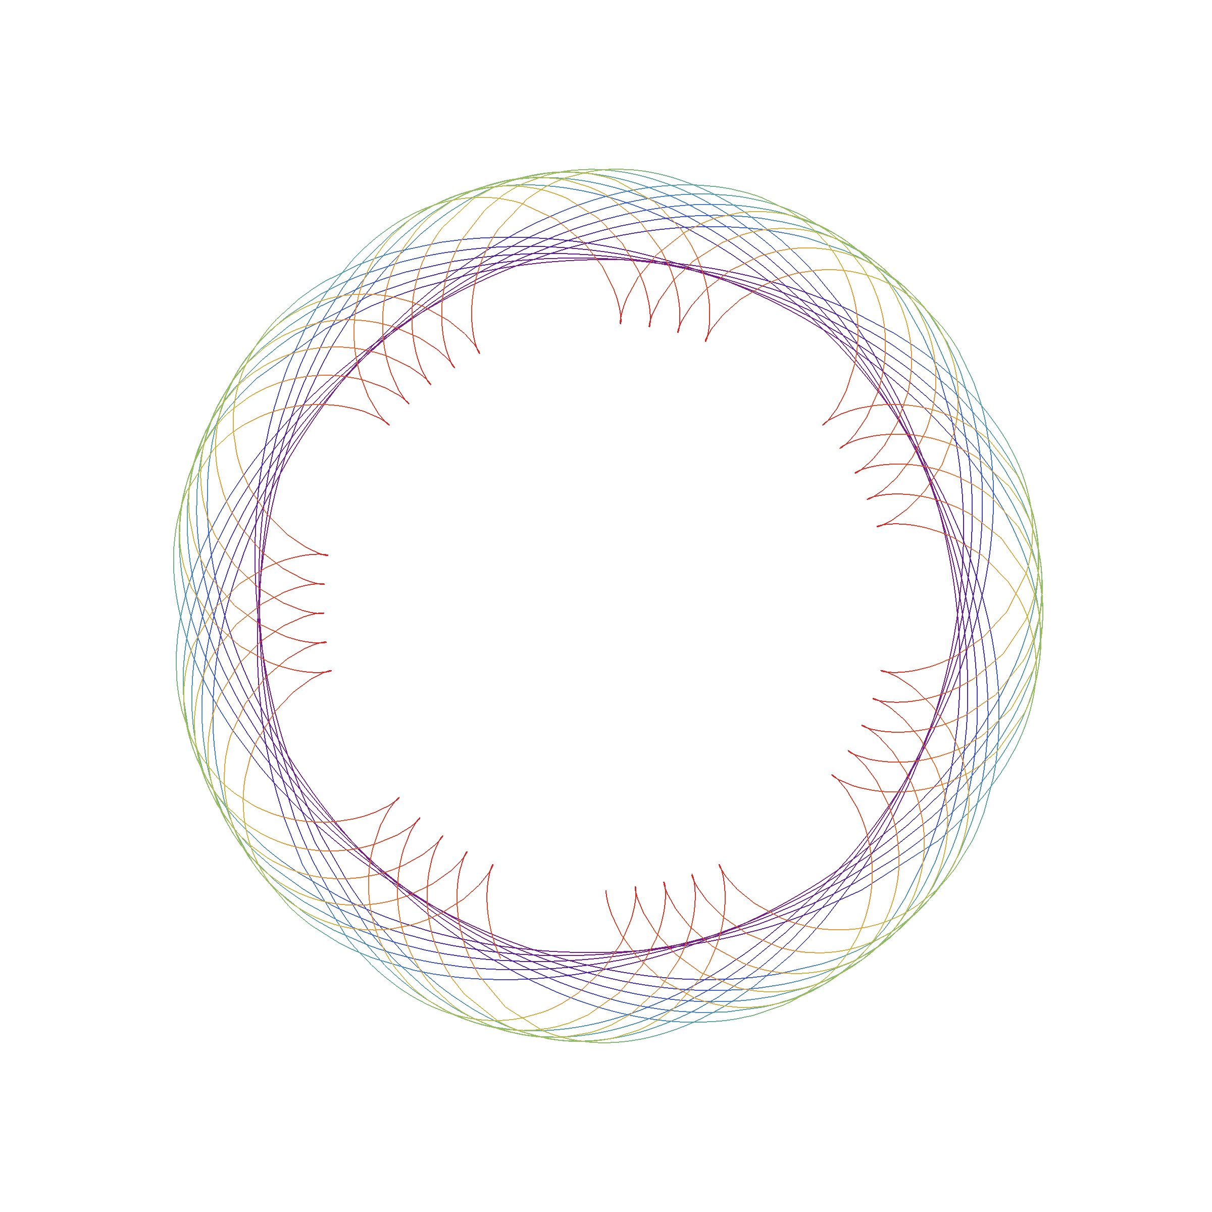
[picture p83: page 1]
