kaszmirek/Inzynierka/thesis/praca_dyplomowa_wzor/figures/chapter_06/mal8.pdf

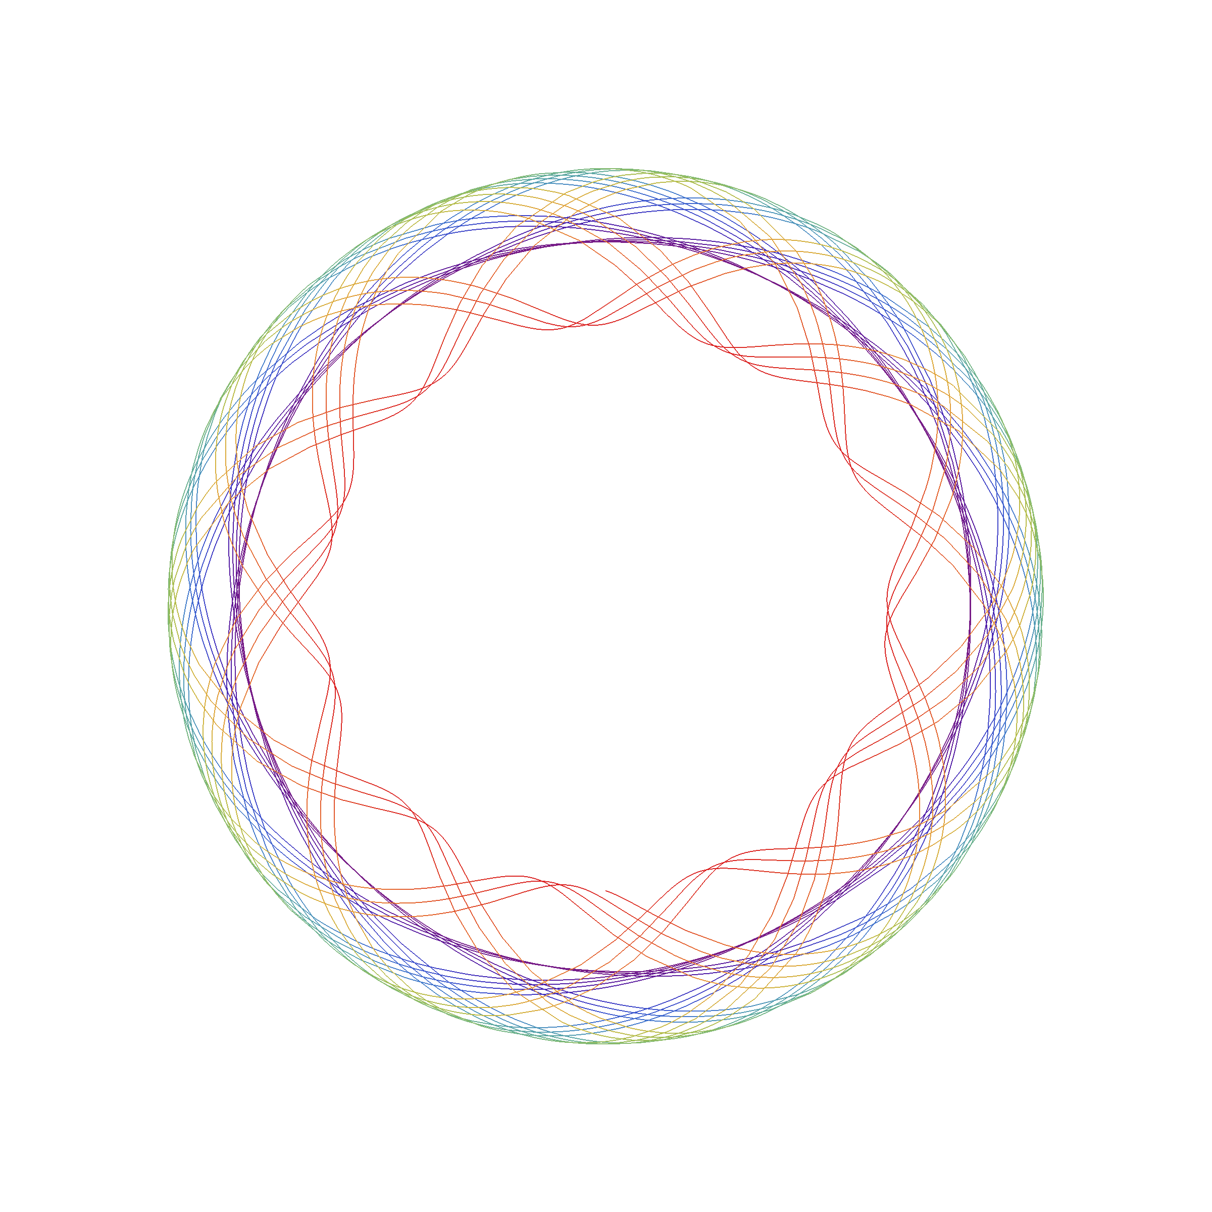
[picture p84: page 1]
