kaszmirek/Inzynierka/thesis/praca_dyplomowa_wzor/figures/chapter_06/malowane_-1.pdf

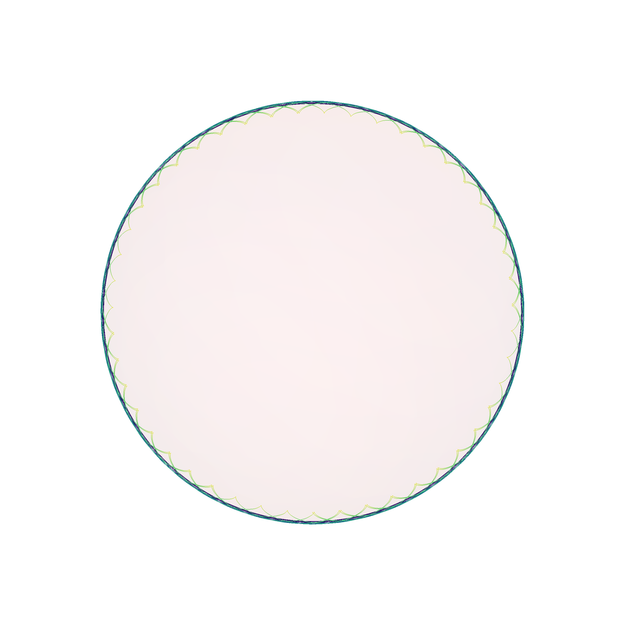
[picture p85: page 1]
