kaszmirek/Inzynierka/thesis/praca_dyplomowa_wzor/figures/chapter_06/malowane_0.pdf

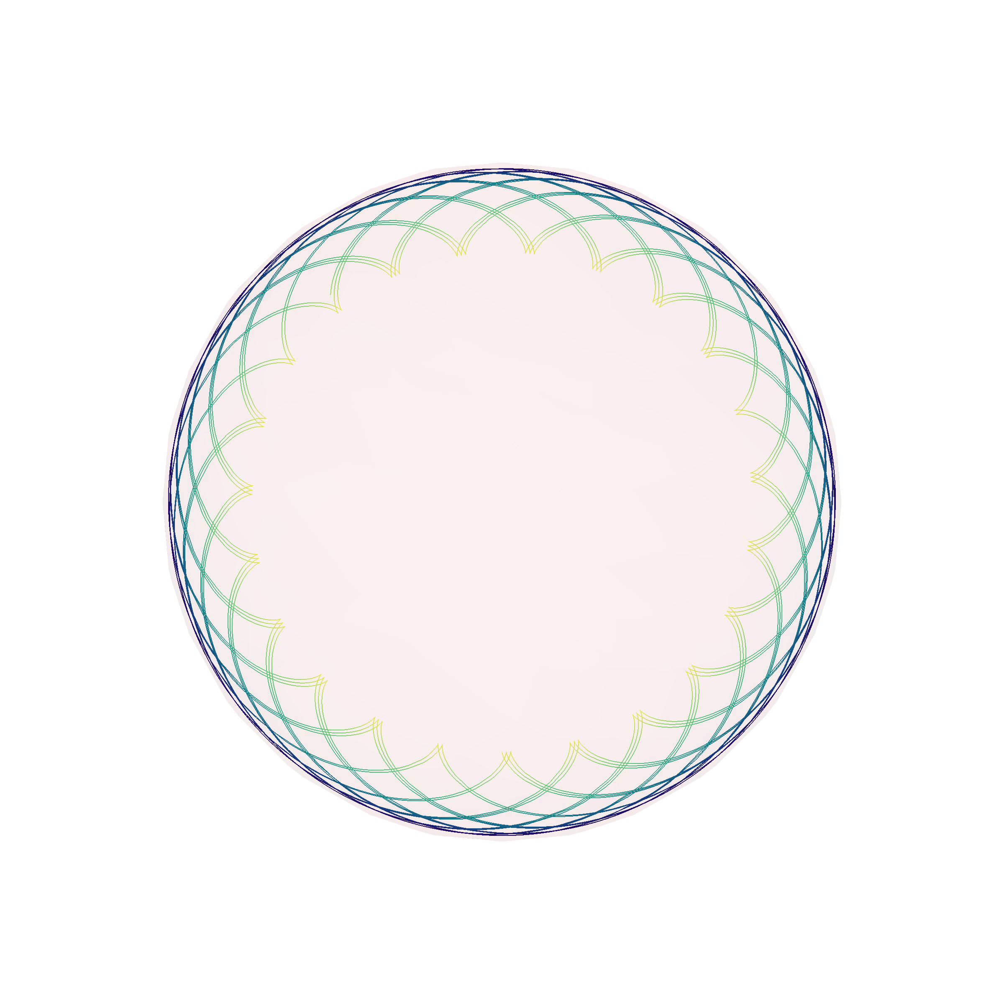
[picture p86: page 1]
