kaszmirek/Inzynierka/docs/schemat_toru_sygnalowego.jpg

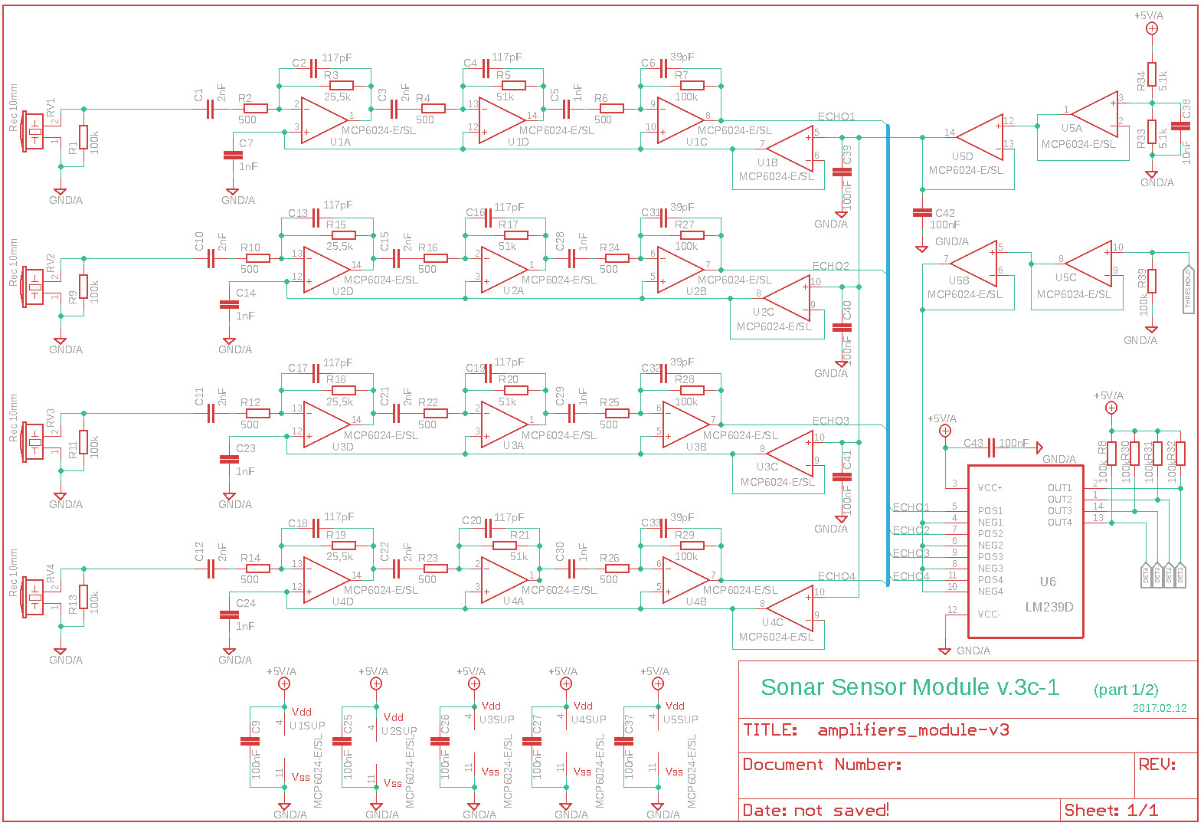
docs/schemat_toru_sygnalowego.jpg
