kaszmirek/Inzynierka/presentation/figure/balbina.jpg

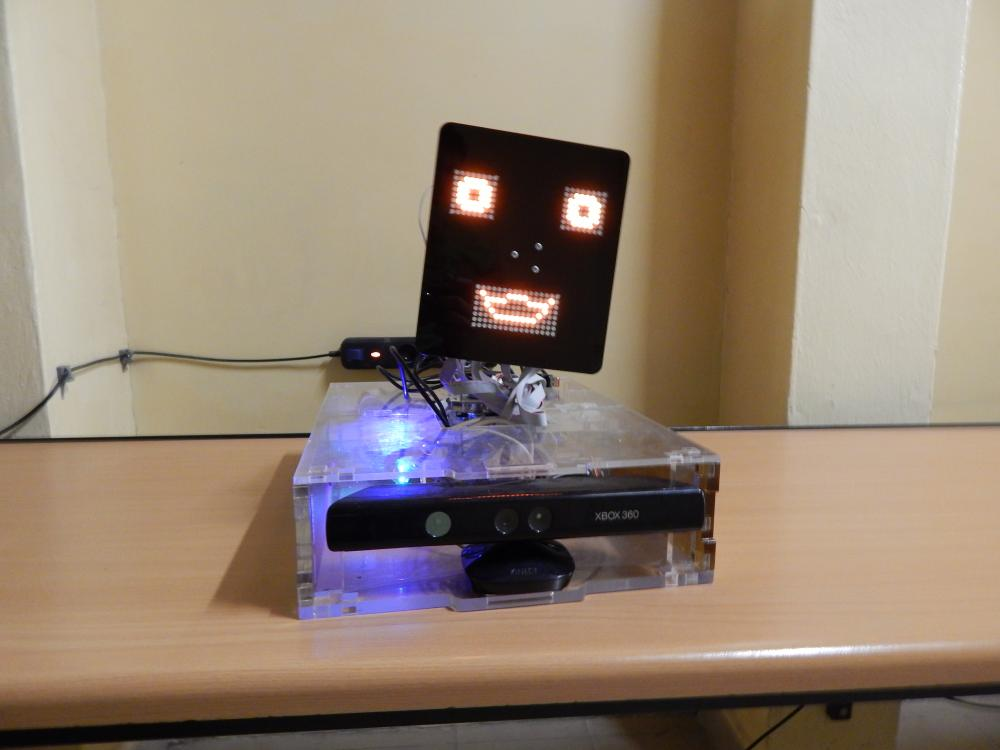
presentation/figure/balbina.jpg
