kaszmirek/Inzynierka/presentation/figure/dso_01_25_07_00_00.bmp

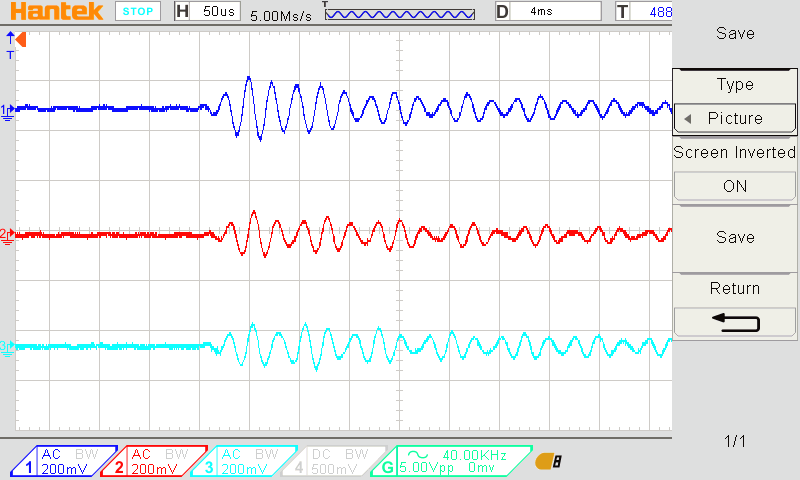
presentation/figure/dso_01_25_07_00_00.bmp
