kaszmirek/Inzynierka/thesis/my_thesis/drawio/microphonearray.png

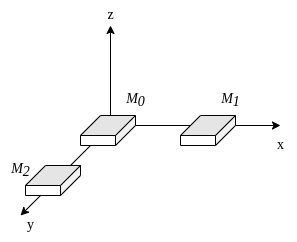
thesis/my_thesis/drawio/microphonearray.png
