kaszmirek/Inzynierka/thesis/my_thesis/figures/chapter_03/rozmieszczenie_mic.drawio.png

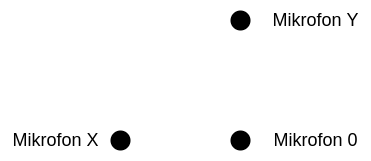
thesis/my_thesis/figures/chapter_03/rozmieszczenie_mic.drawio.png
