kaszmirek/Inzynierka/thesis/my_thesis/figures/chapter_05/comp.png

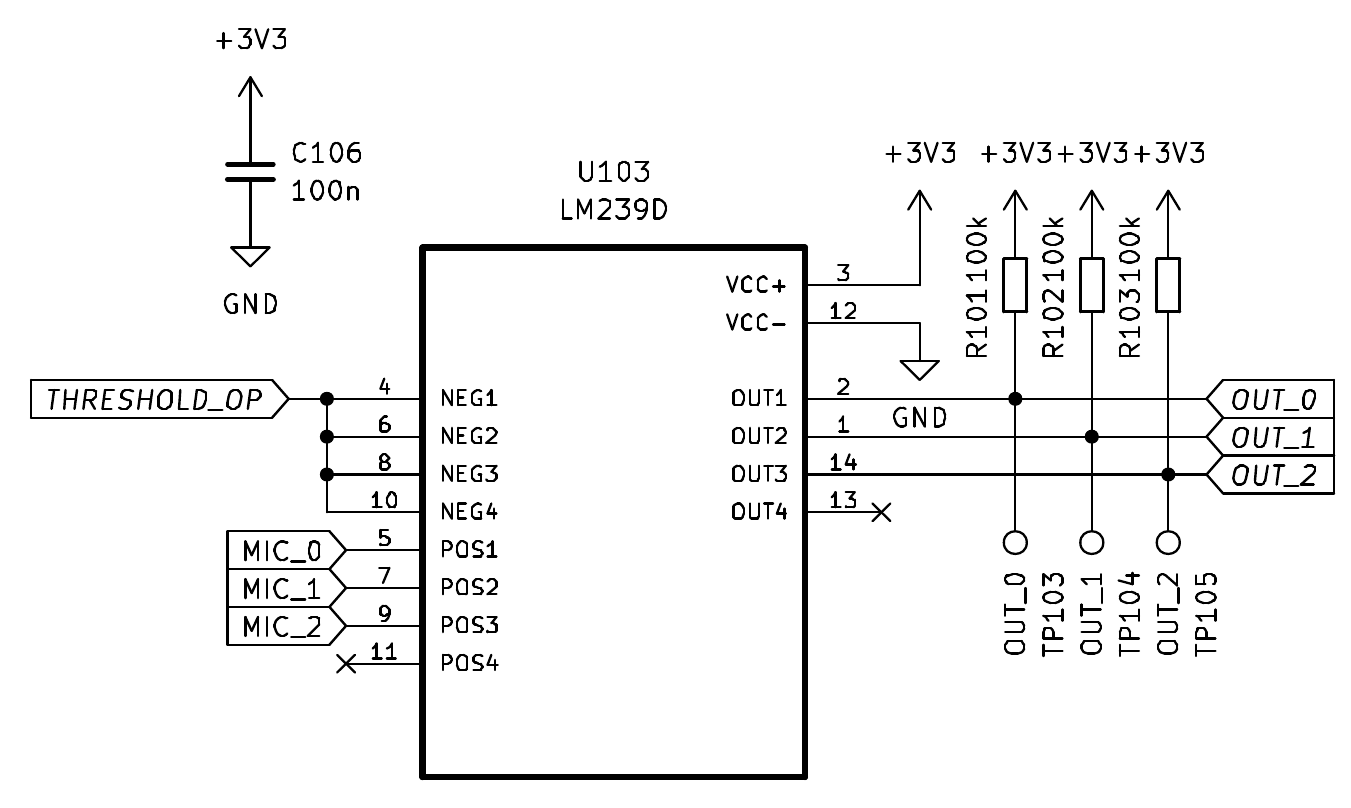
thesis/my_thesis/figures/chapter_05/comp.png
