kaszmirek/Inzynierka/thesis/my_thesis/figures/chapter_05/shield.png

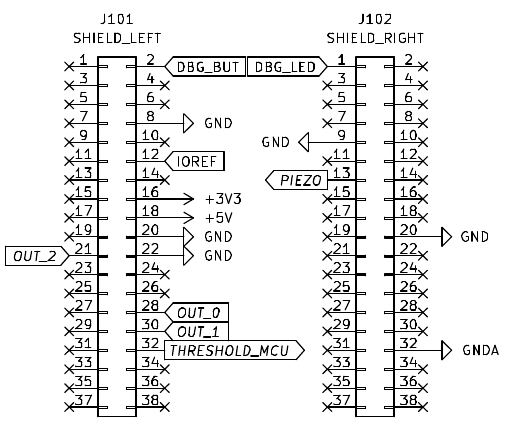
thesis/my_thesis/figures/chapter_05/shield.png
