kaszmirek/Inzynierka/thesis/my_thesis/figures/chapter_06/20221201_171840.jpg

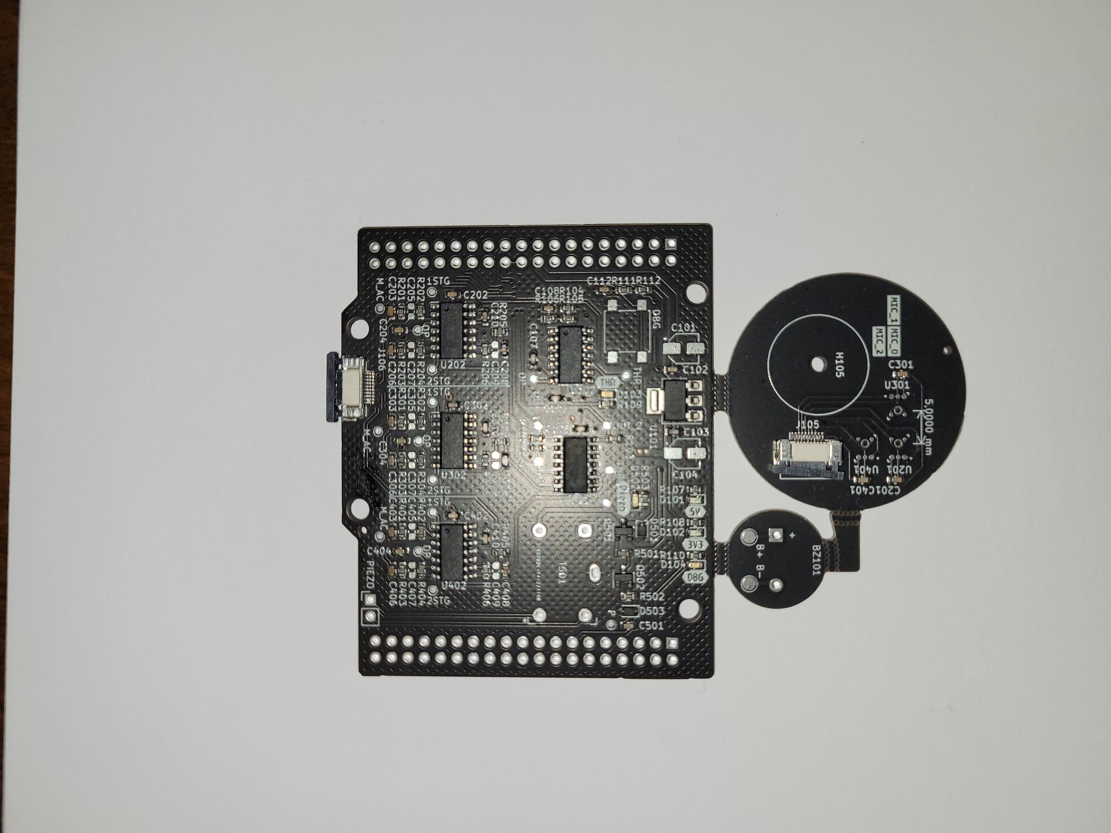
thesis/my_thesis/figures/chapter_06/20221201_171840.jpg
