kaszmirek/Inzynierka/thesis/my_thesis/figures/chapter_06/nadajnik-odbiornik.jpg

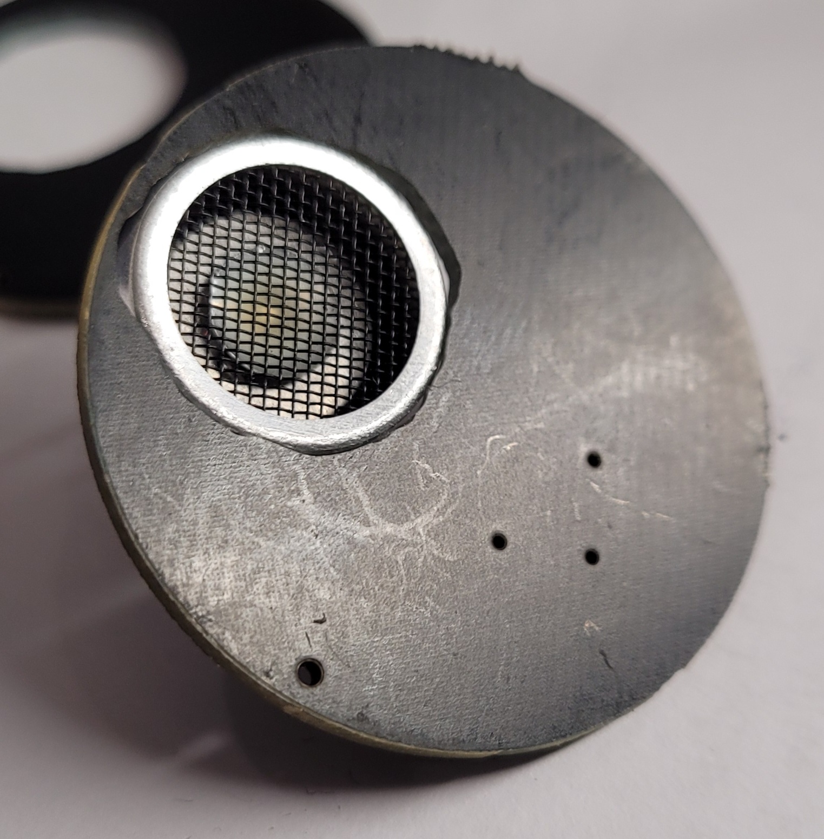
thesis/my_thesis/figures/chapter_06/nadajnik-odbiornik.jpg
