kaszmirek/Inzynierka/thesis/my_thesis/figures/chapter_07/20221214_121931.jpg

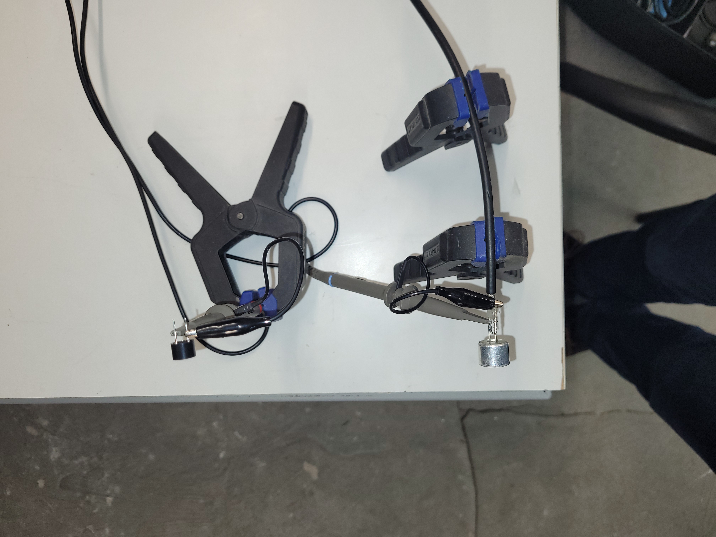
thesis/my_thesis/figures/chapter_07/20221214_121931.jpg
