kaszmirek/Inzynierka/thesis/my_thesis/figures/chapter_07/20221214_121935.jpg

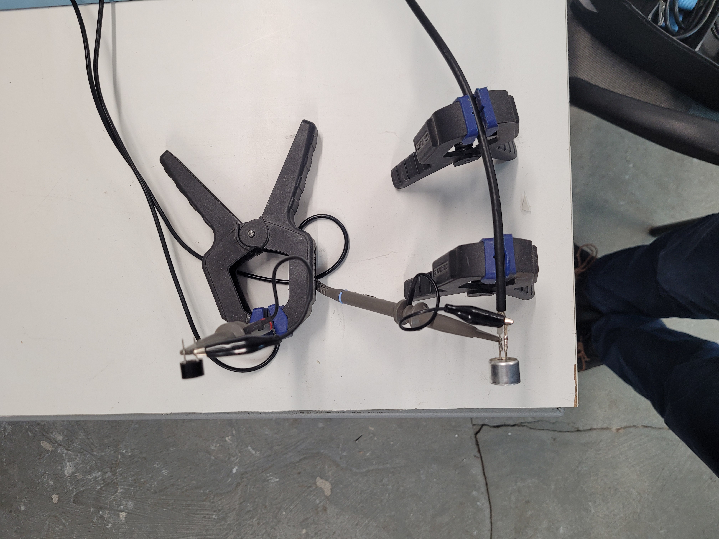
thesis/my_thesis/figures/chapter_07/20221214_121935.jpg
