kaszmirek/Inzynierka/thesis/my_thesis/figures/chapter_07/20221214_122021.jpg

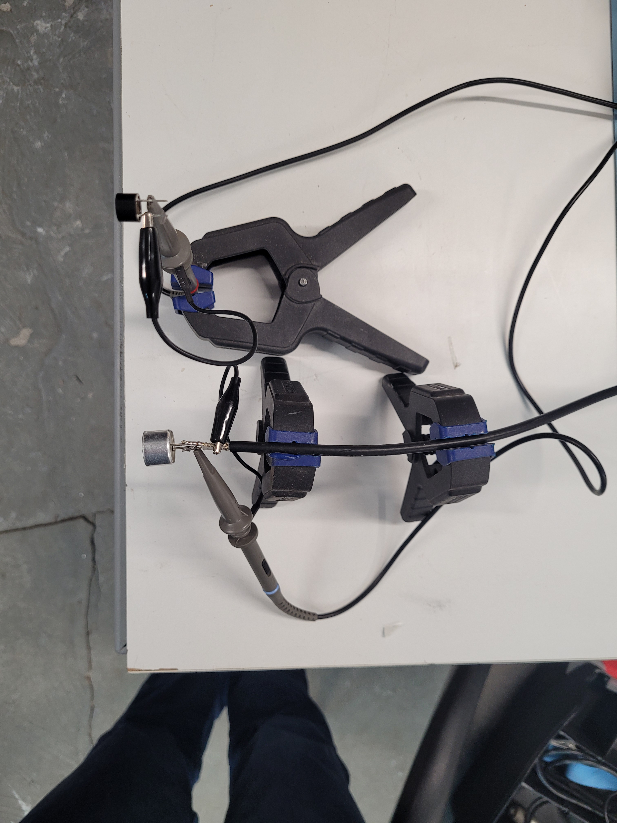
thesis/my_thesis/figures/chapter_07/20221214_122021.jpg
