kaszmirek/Inzynierka/thesis/my_thesis/figures/chapter_07/20221214_215440.jpg

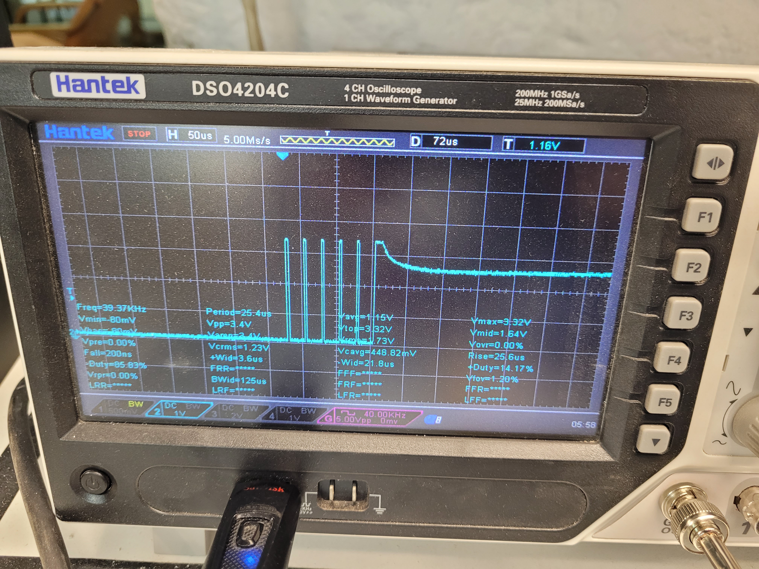
thesis/my_thesis/figures/chapter_07/20221214_215440.jpg
