kaszmirek/Inzynierka/thesis/my_thesis/figures/chapter_07/20221219_163441.jpg

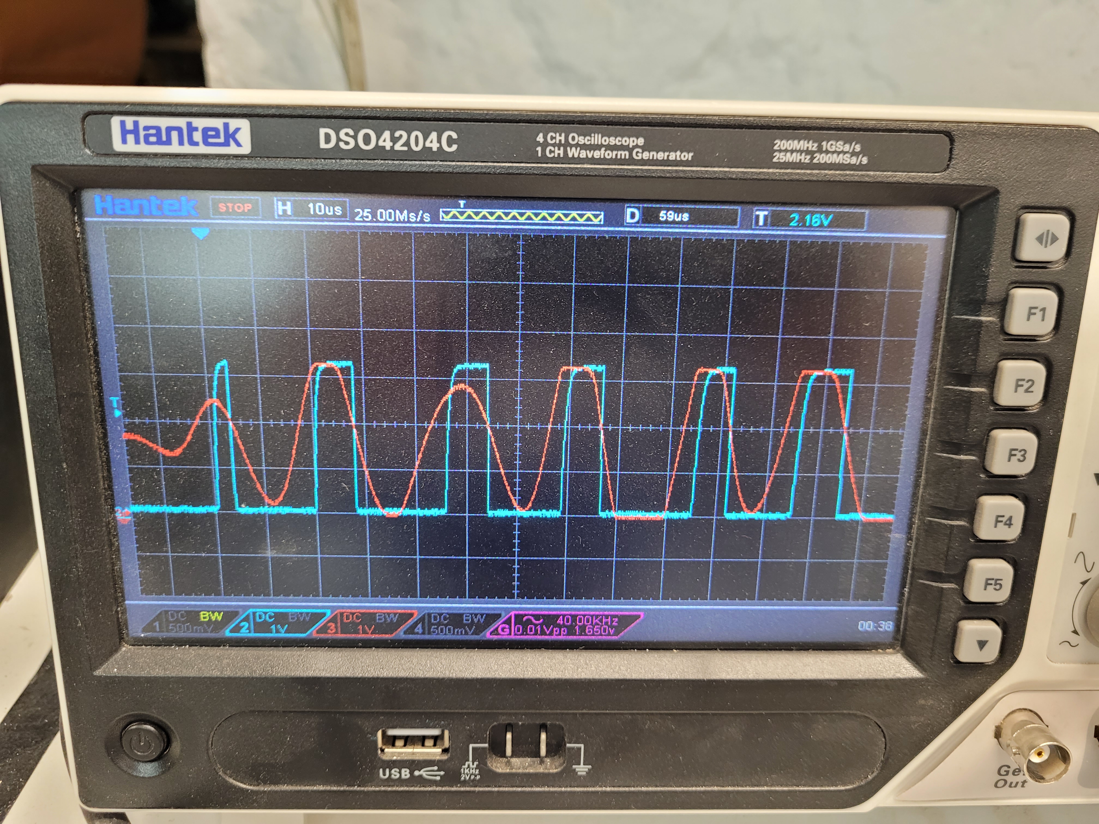
thesis/my_thesis/figures/chapter_07/20221219_163441.jpg
