kaszmirek/Inzynierka/thesis/my_thesis/figures/chapter_07/20221219_163955.jpg

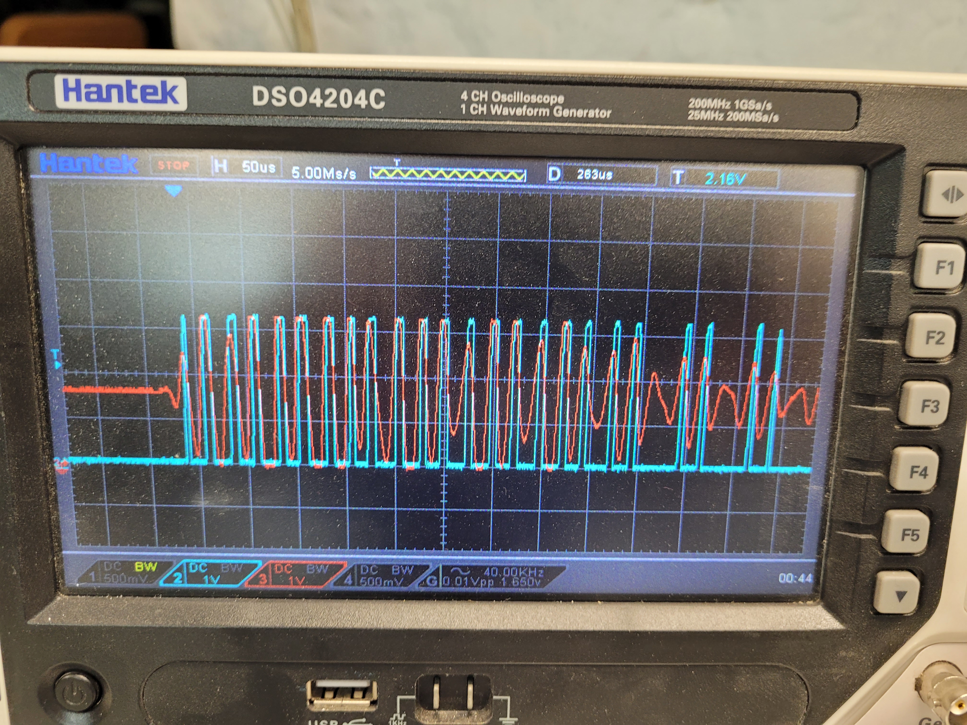
thesis/my_thesis/figures/chapter_07/20221219_163955.jpg
