kaszmirek/Inzynierka/thesis/my_thesis/figures/chapter_08/dso_12_22_01_01_07.jpg

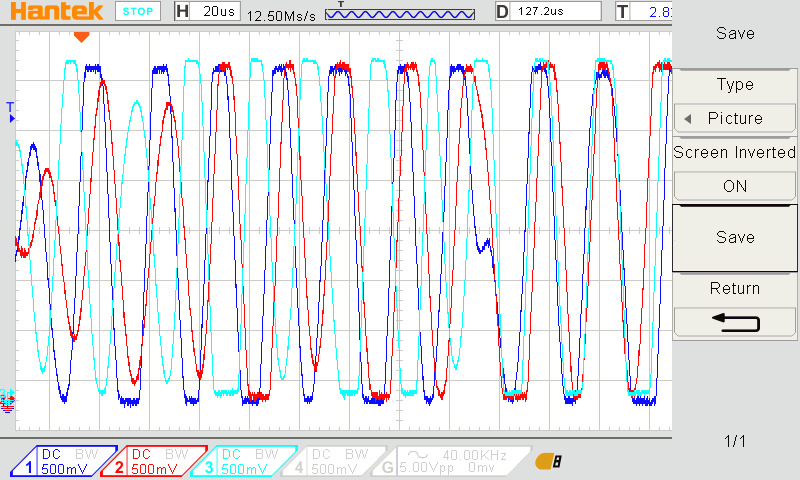
thesis/my_thesis/figures/chapter_08/dso_12_22_01_01_07.jpg
