kaszmirek/Inzynierka/thesis/my_thesis/figures/chapter_08/filter.bmp

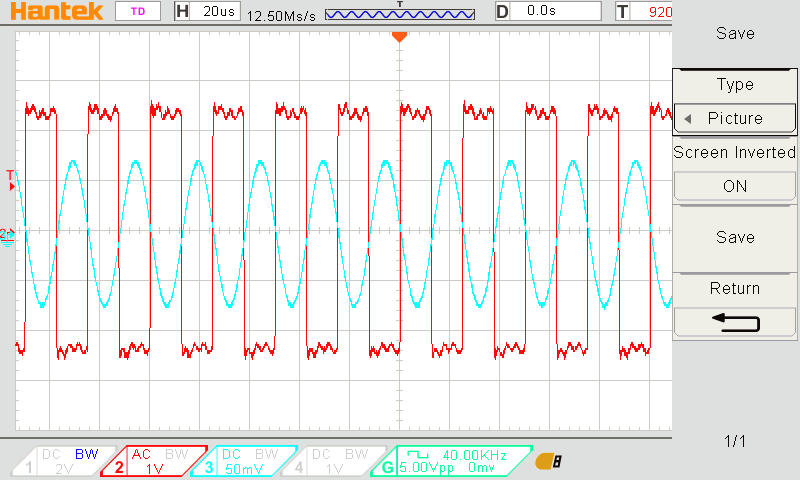
thesis/my_thesis/figures/chapter_08/filter.bmp
