kaszmirek/Inzynierka/thesis/my_thesis/figures/chapter_08/microphone.bmp

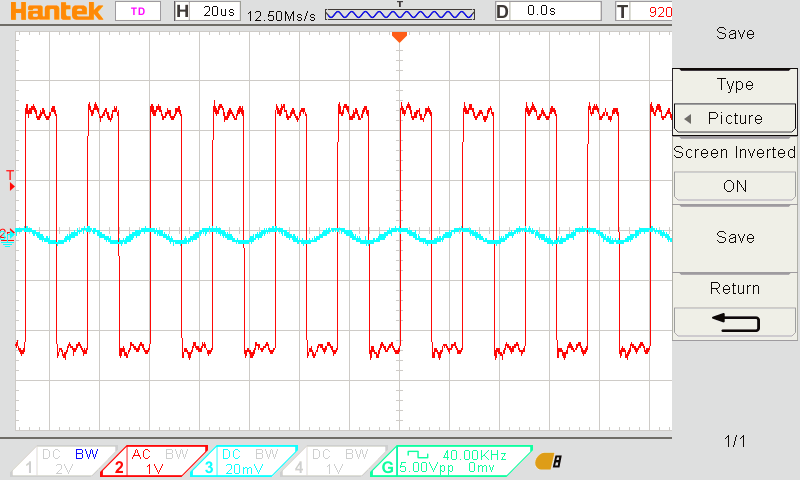
thesis/my_thesis/figures/chapter_08/microphone.bmp
