kaszmirek/Inzynierka/thesis/my_thesis/figures/chapter_08/nopiezo.bmp

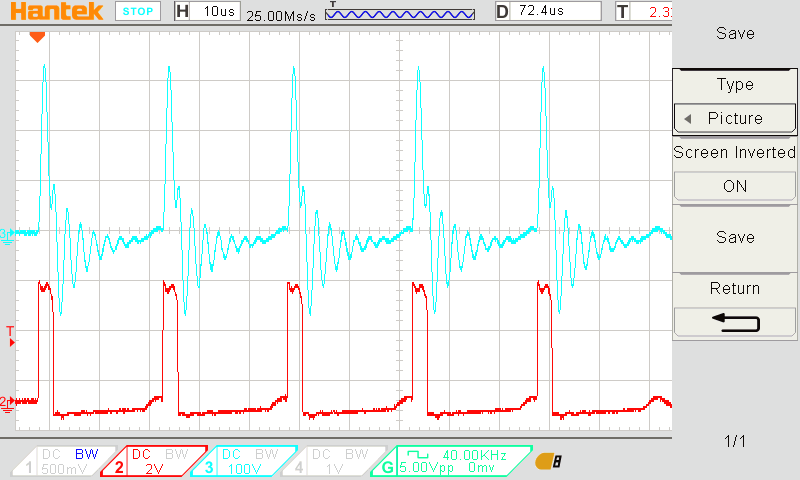
thesis/my_thesis/figures/chapter_08/nopiezo.bmp
