kaszmirek/Inzynierka/thesis/my_thesis/figures/chapter_08/nopiezo.jpg

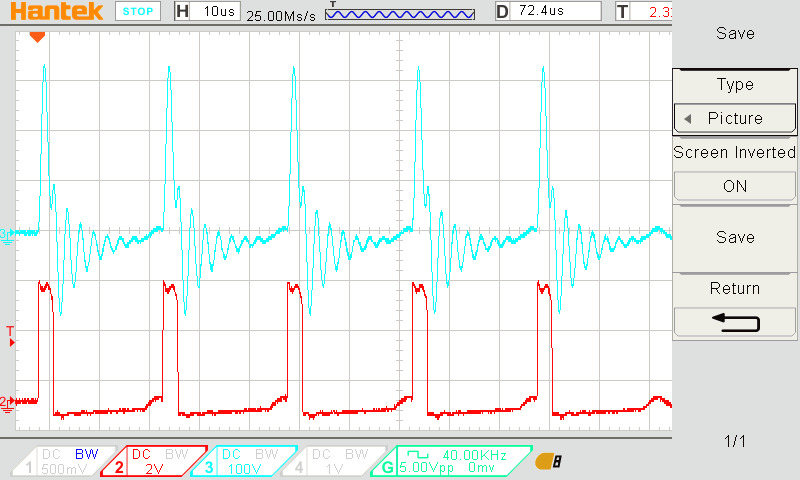
thesis/my_thesis/figures/chapter_08/nopiezo.jpg
