kaszmirek/Inzynierka/thesis/my_thesis/figures/chapter_08/piezooscylo.bmp

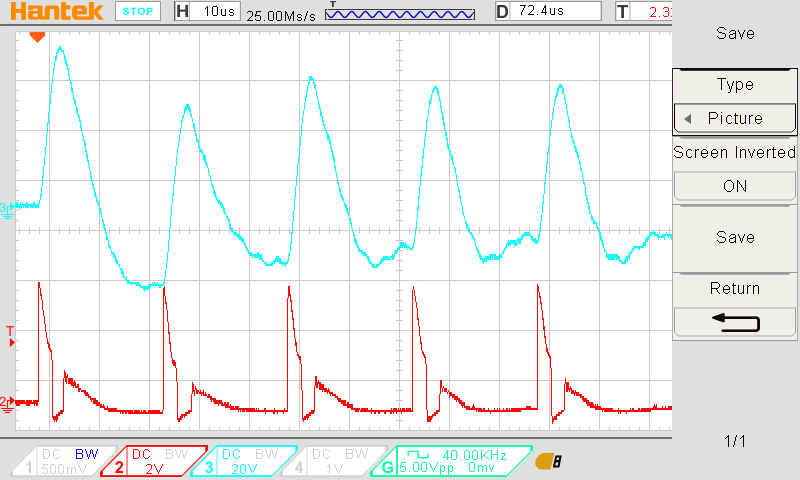
thesis/my_thesis/figures/chapter_08/piezooscylo.bmp
