kaszmirek/Inzynierka/thesis/praca_dyplomowa_wzor/figures/chapter_03/bak_lag_model.jpg

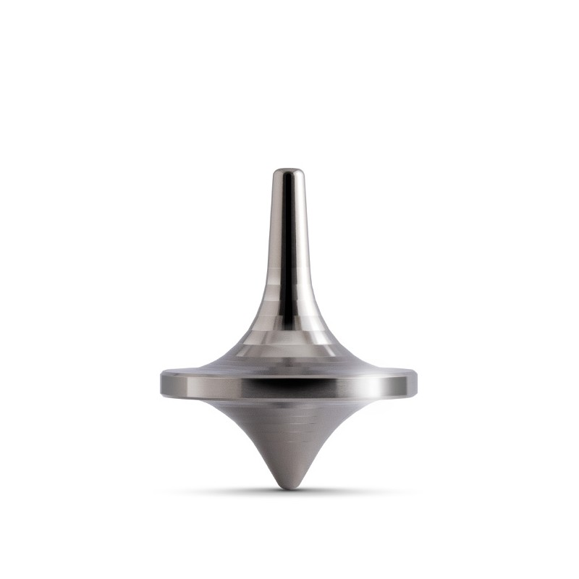
thesis/praca_dyplomowa_wzor/figures/chapter_03/bak_lag_model.jpg
