kaszmirek/Inzynierka/pcb/inzynierka/Board2Pdf/inzynierka-Assembly.pdf

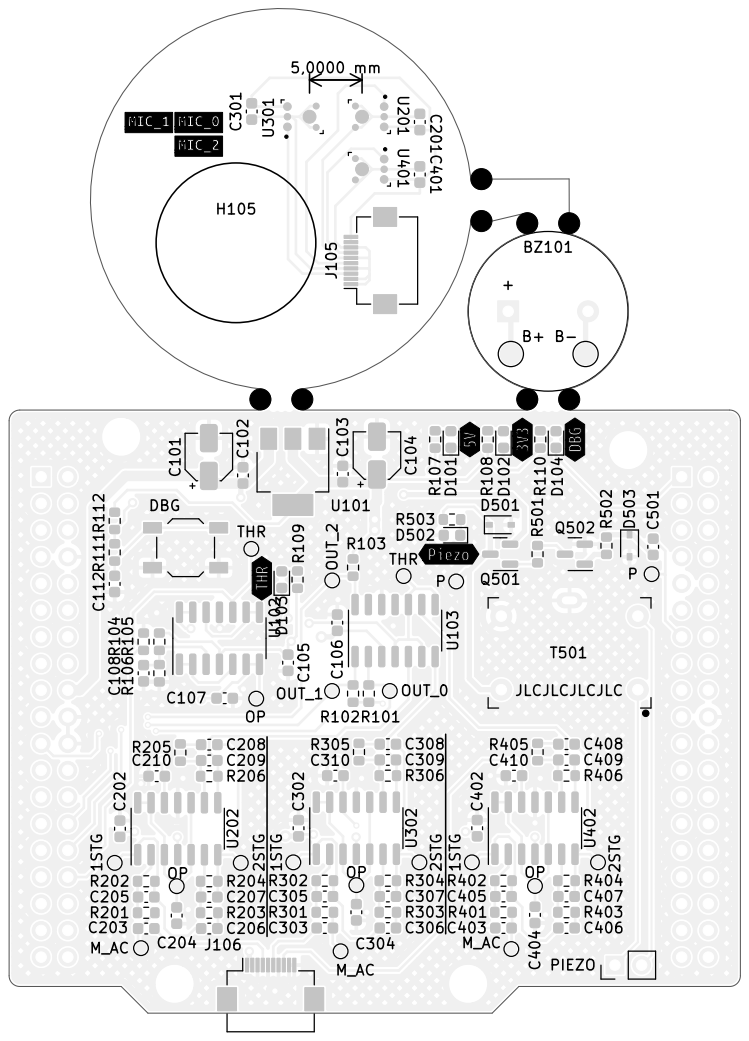
[picture p121: page 1]

1 | 2 | 3 | 4 | 5 | 6

A

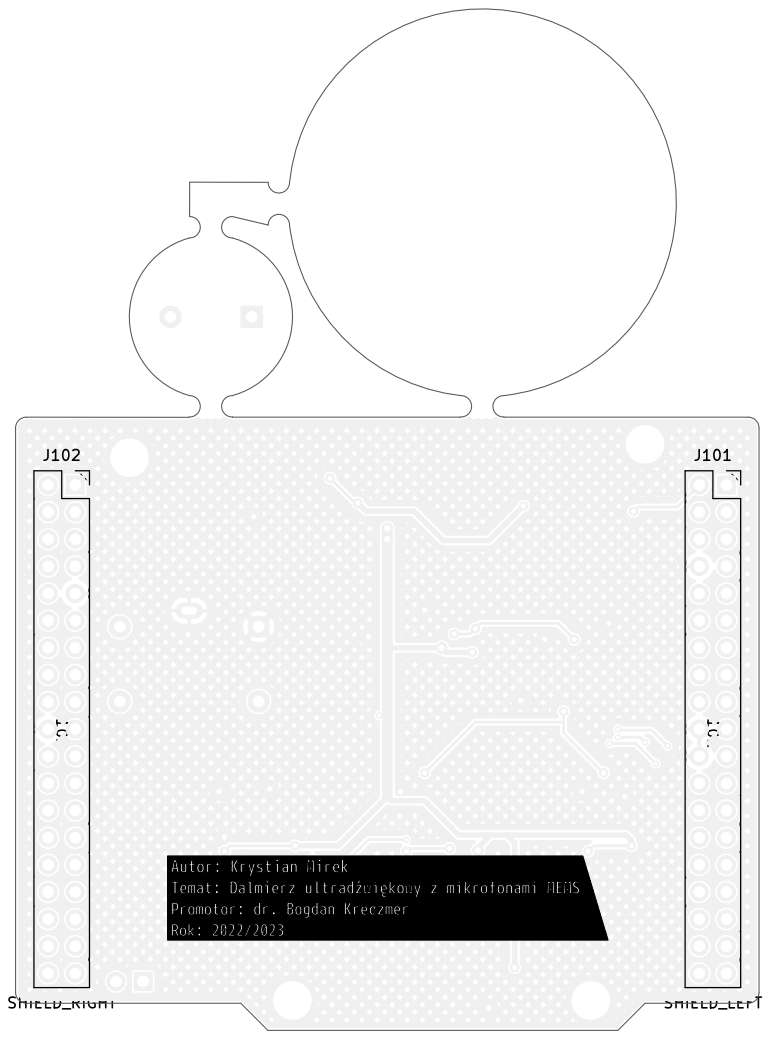
[picture p122: page 2]
D Date: KiCad E.D.A. kicad (6.0.9) Size: A4; Rev:; SHIELD_RIGHT J102; SHIELD_LEFT J101

File: inzynierka.kicad_pcb Sheet: BlackAndWhiteBottom
Id: 1/1 Title:
