kaszmirek/Inzynierka/thesis/my_thesis/figures/chapter_09/schemat_plytki.pdf

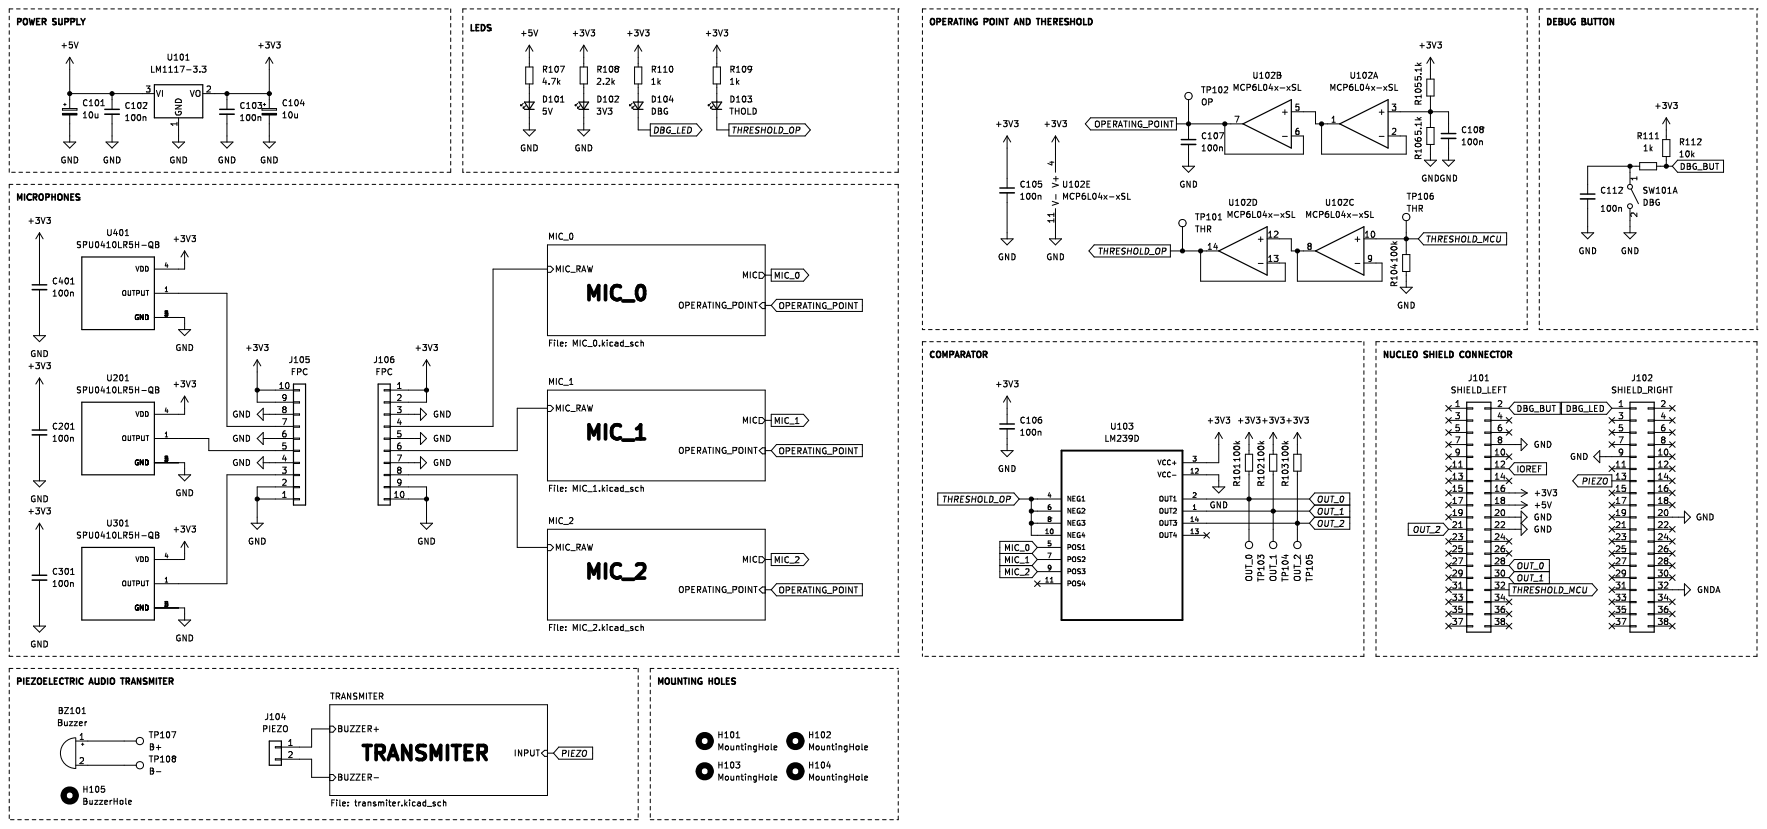
[picture p123: page 1]

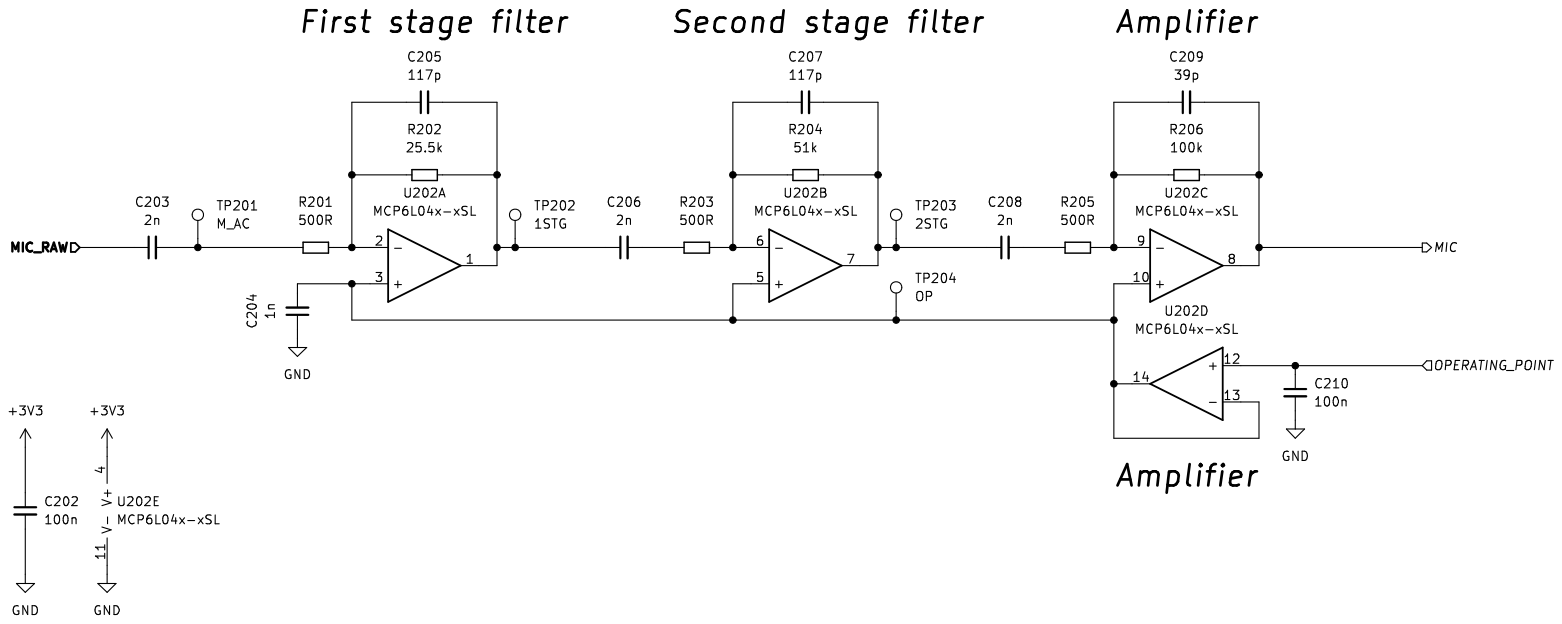
[picture p124: page 2]

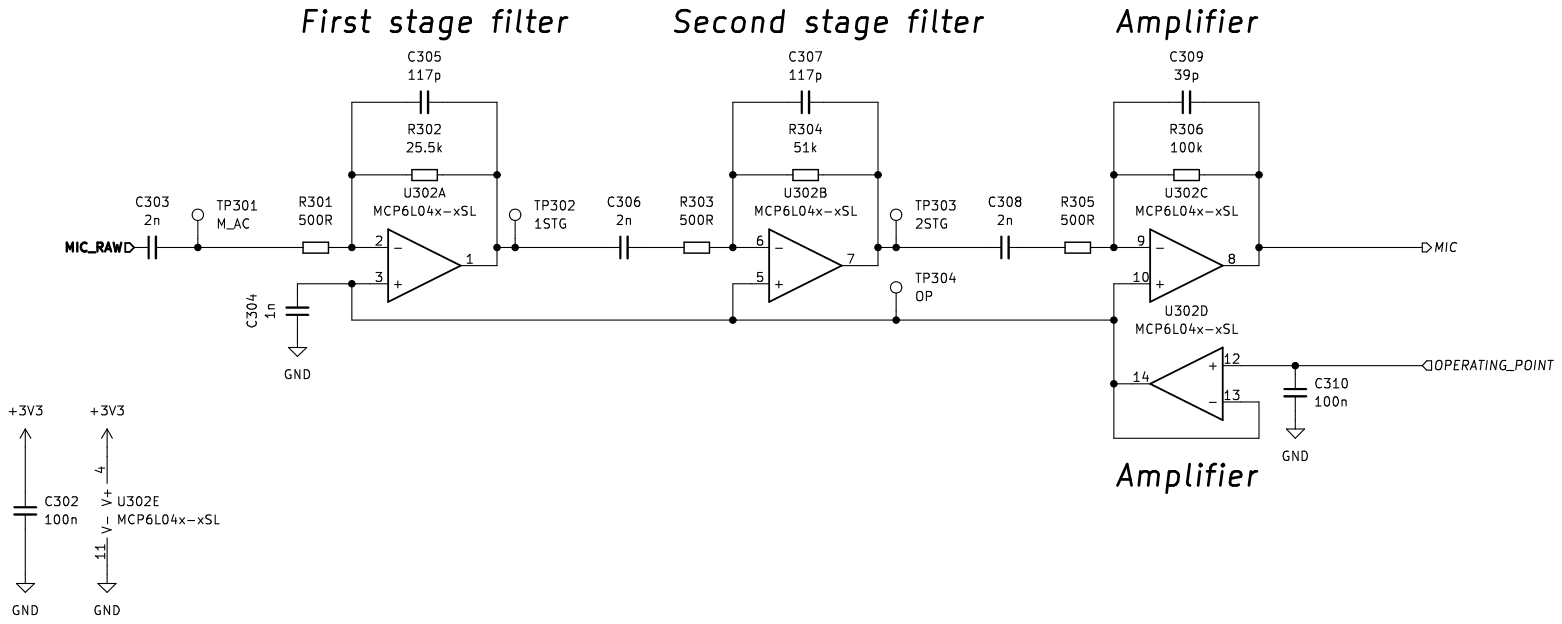
[picture p125: page 3]

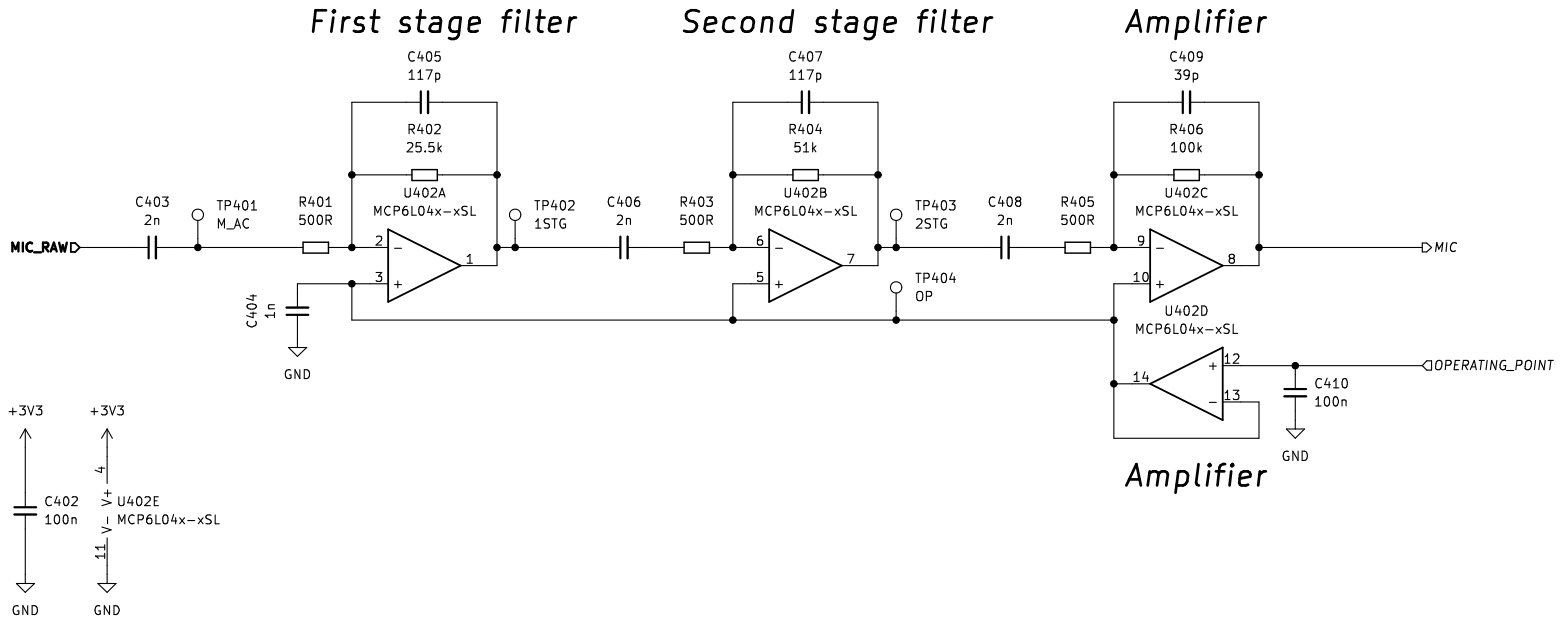
[picture p126: page 4]

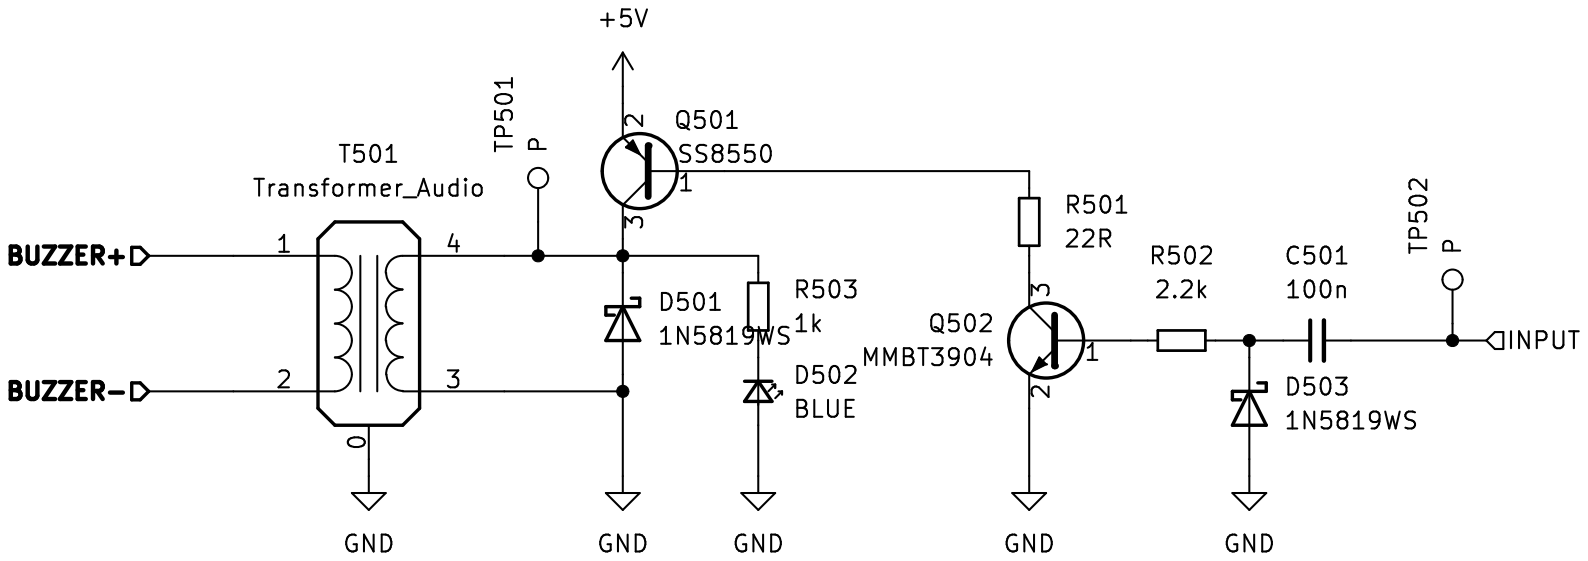
[picture p127: page 5]
