kaszmirek/Inzynierka/thesis/praca_dyplomowa_wzor/figures/chapter_03/kowal.pdf

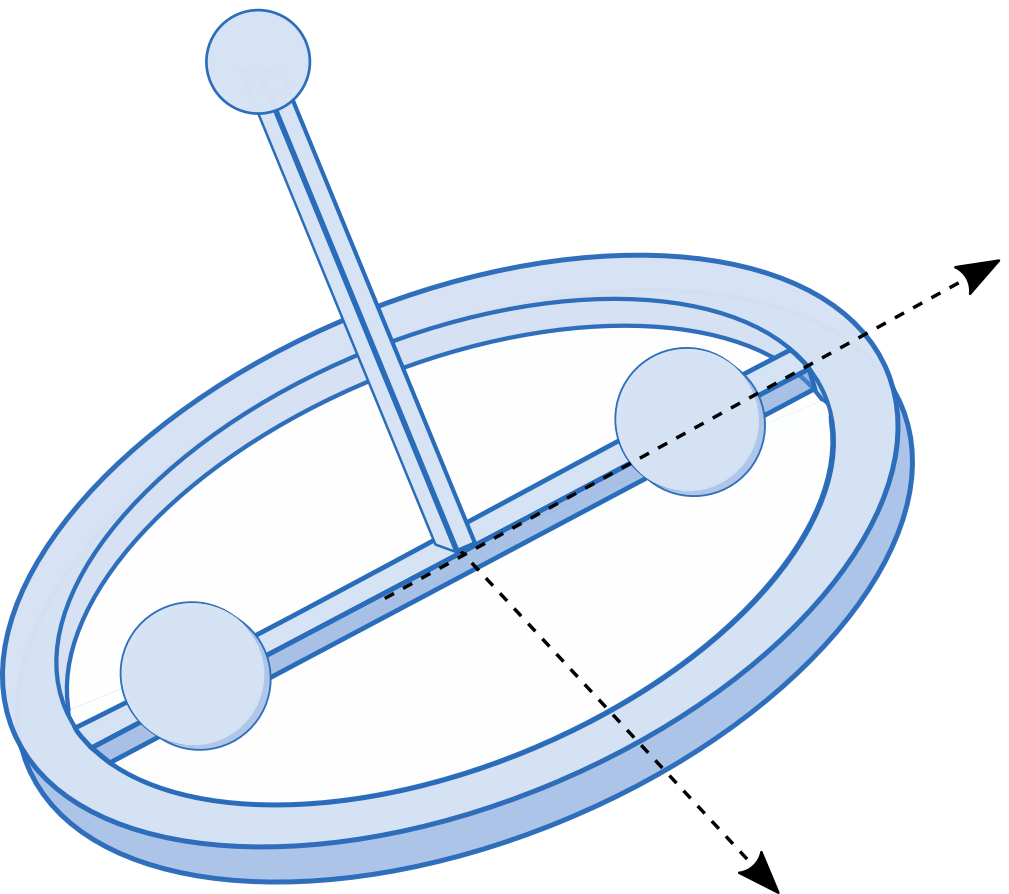
[picture p128: page 1]
