kaszmirek/Inzynierka/thesis/praca_dyplomowa_wzor/figures/chapter_05/interfejs2.pdf

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

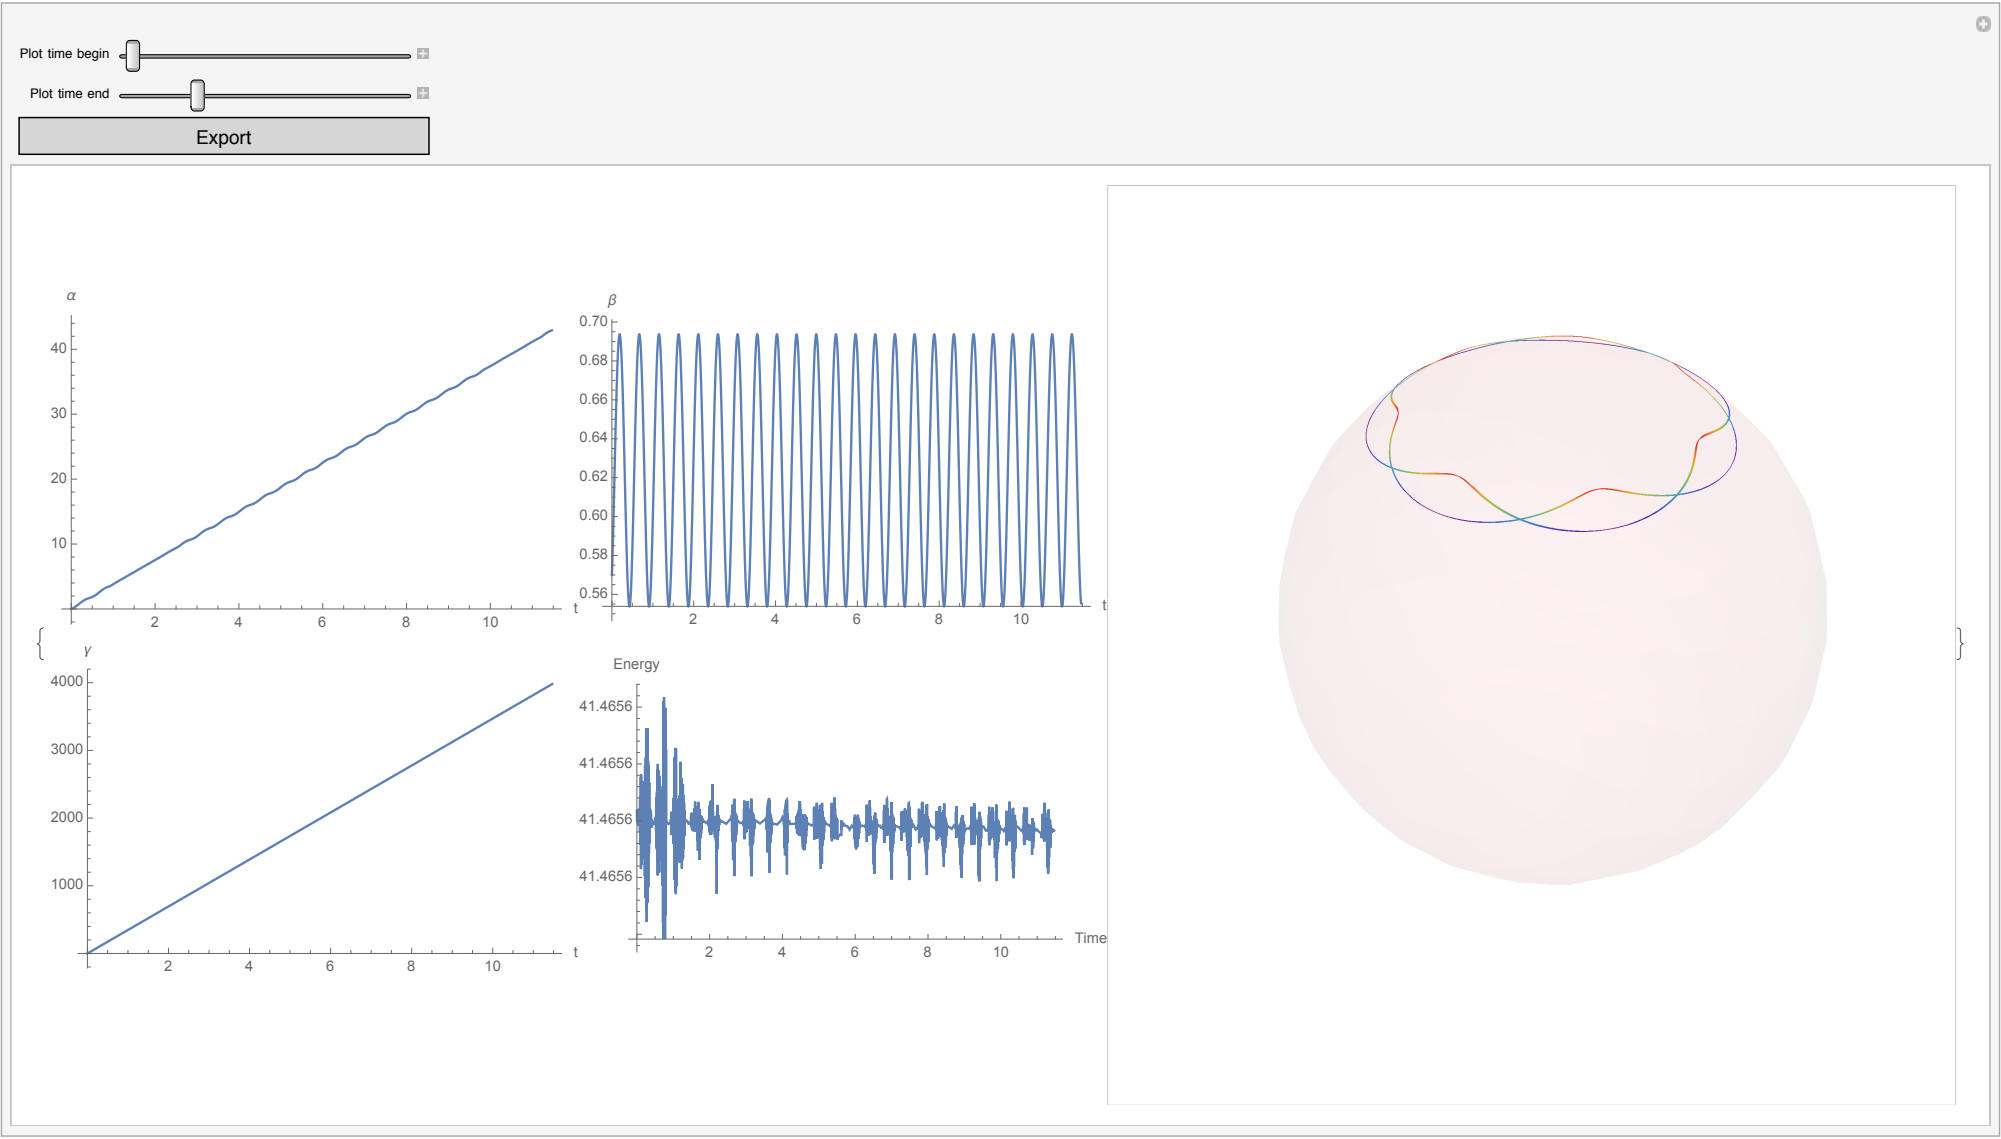
[picture p129: page 1]
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
