kaszmirek/Inzynierka/thesis/praca_dyplomowa_wzor/figures/chapter_05/sim1_a.pdf

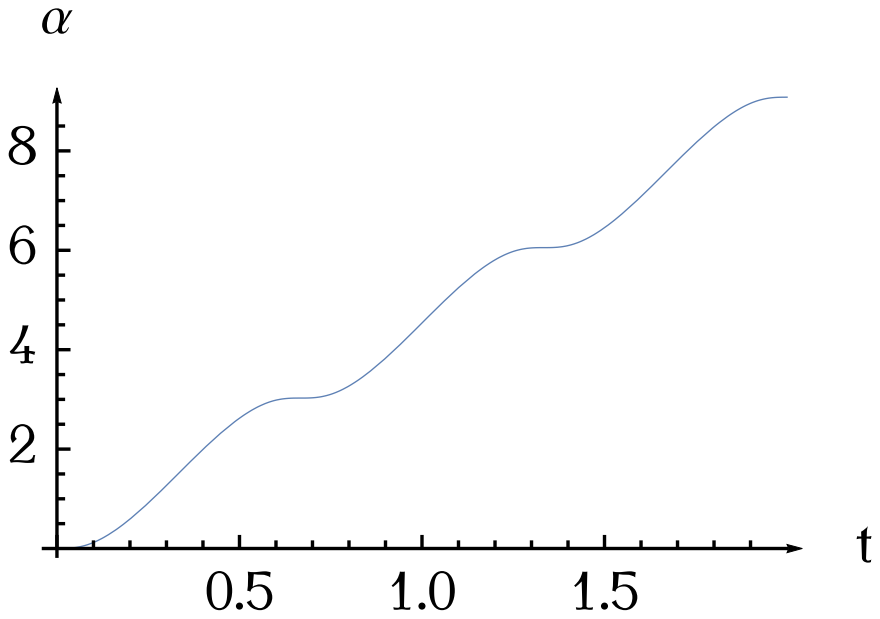
[picture p132: page 1]
