kaszmirek/Inzynierka/thesis/praca_dyplomowa_wzor/figures/chapter_05/sim1_b.pdf

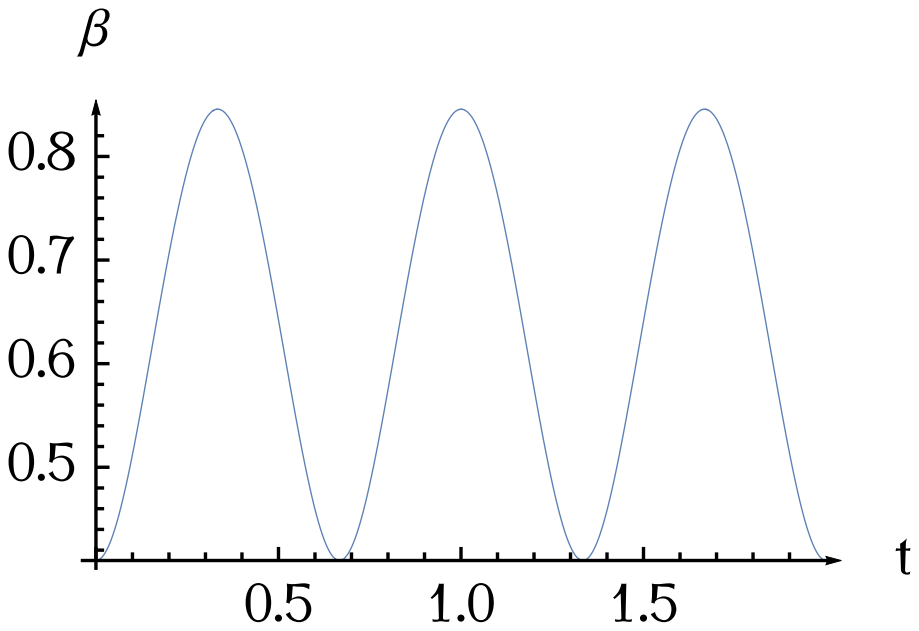
[picture p133: page 1]
