kaszmirek/Inzynierka/thesis/praca_dyplomowa_wzor/figures/chapter_05/sim2_a.pdf

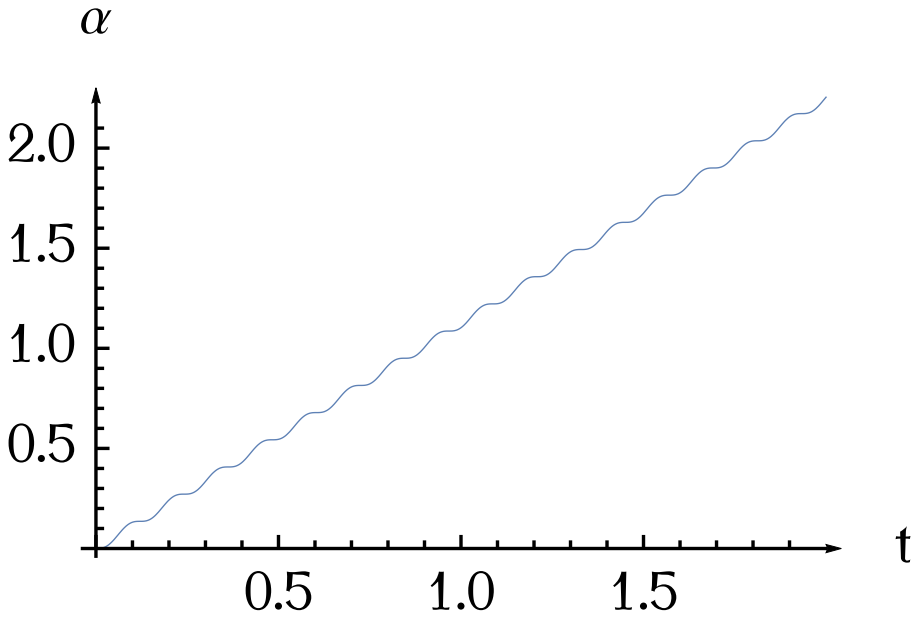
[picture p134: page 1]
