kaszmirek/Inzynierka/thesis/praca_dyplomowa_wzor/figures/chapter_05/sim2_b.pdf

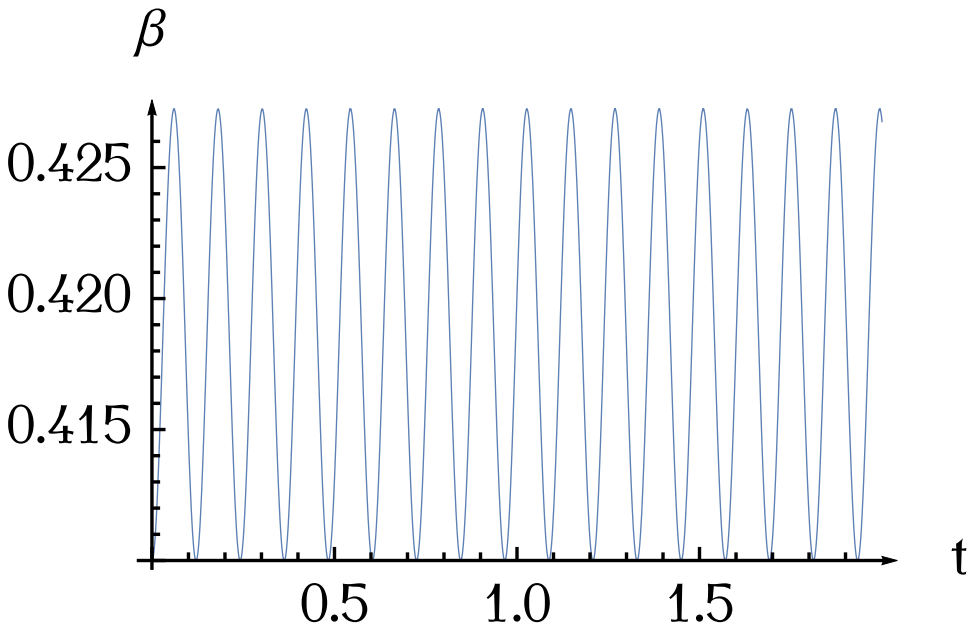
[picture p135: page 1]
