kaszmirek/Inzynierka/thesis/praca_dyplomowa_wzor/figures/chapter_05/sim3_b.pdf

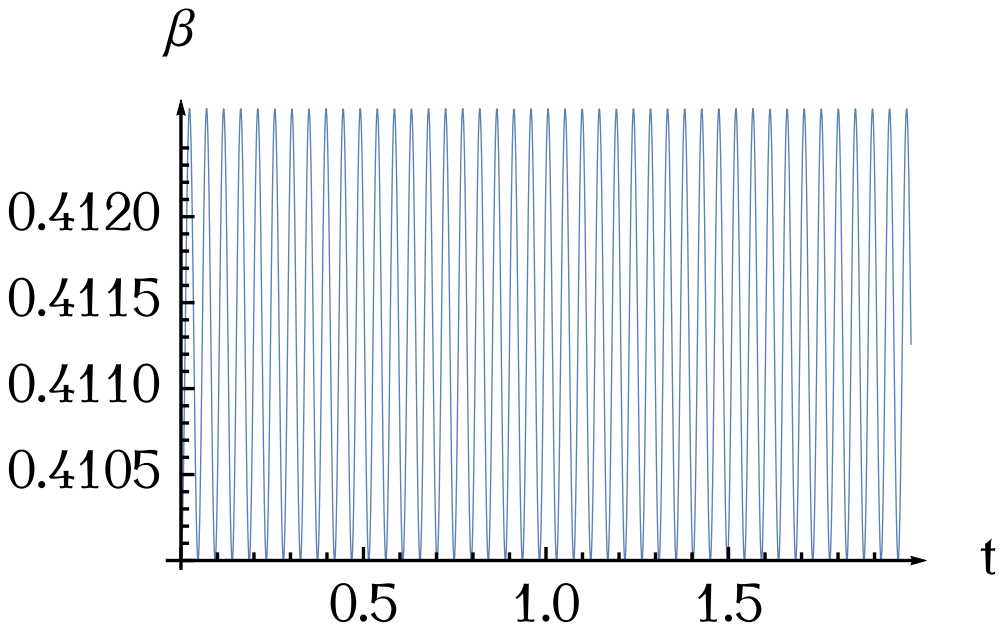
[picture p136: page 1]
