kaszmirek/Inzynierka/pcb/inzynierka/inzynierka.kicad_pcb

## KiCad design pcb/inzynierka/inzynierka.kicad_pcb (2022-11-07)

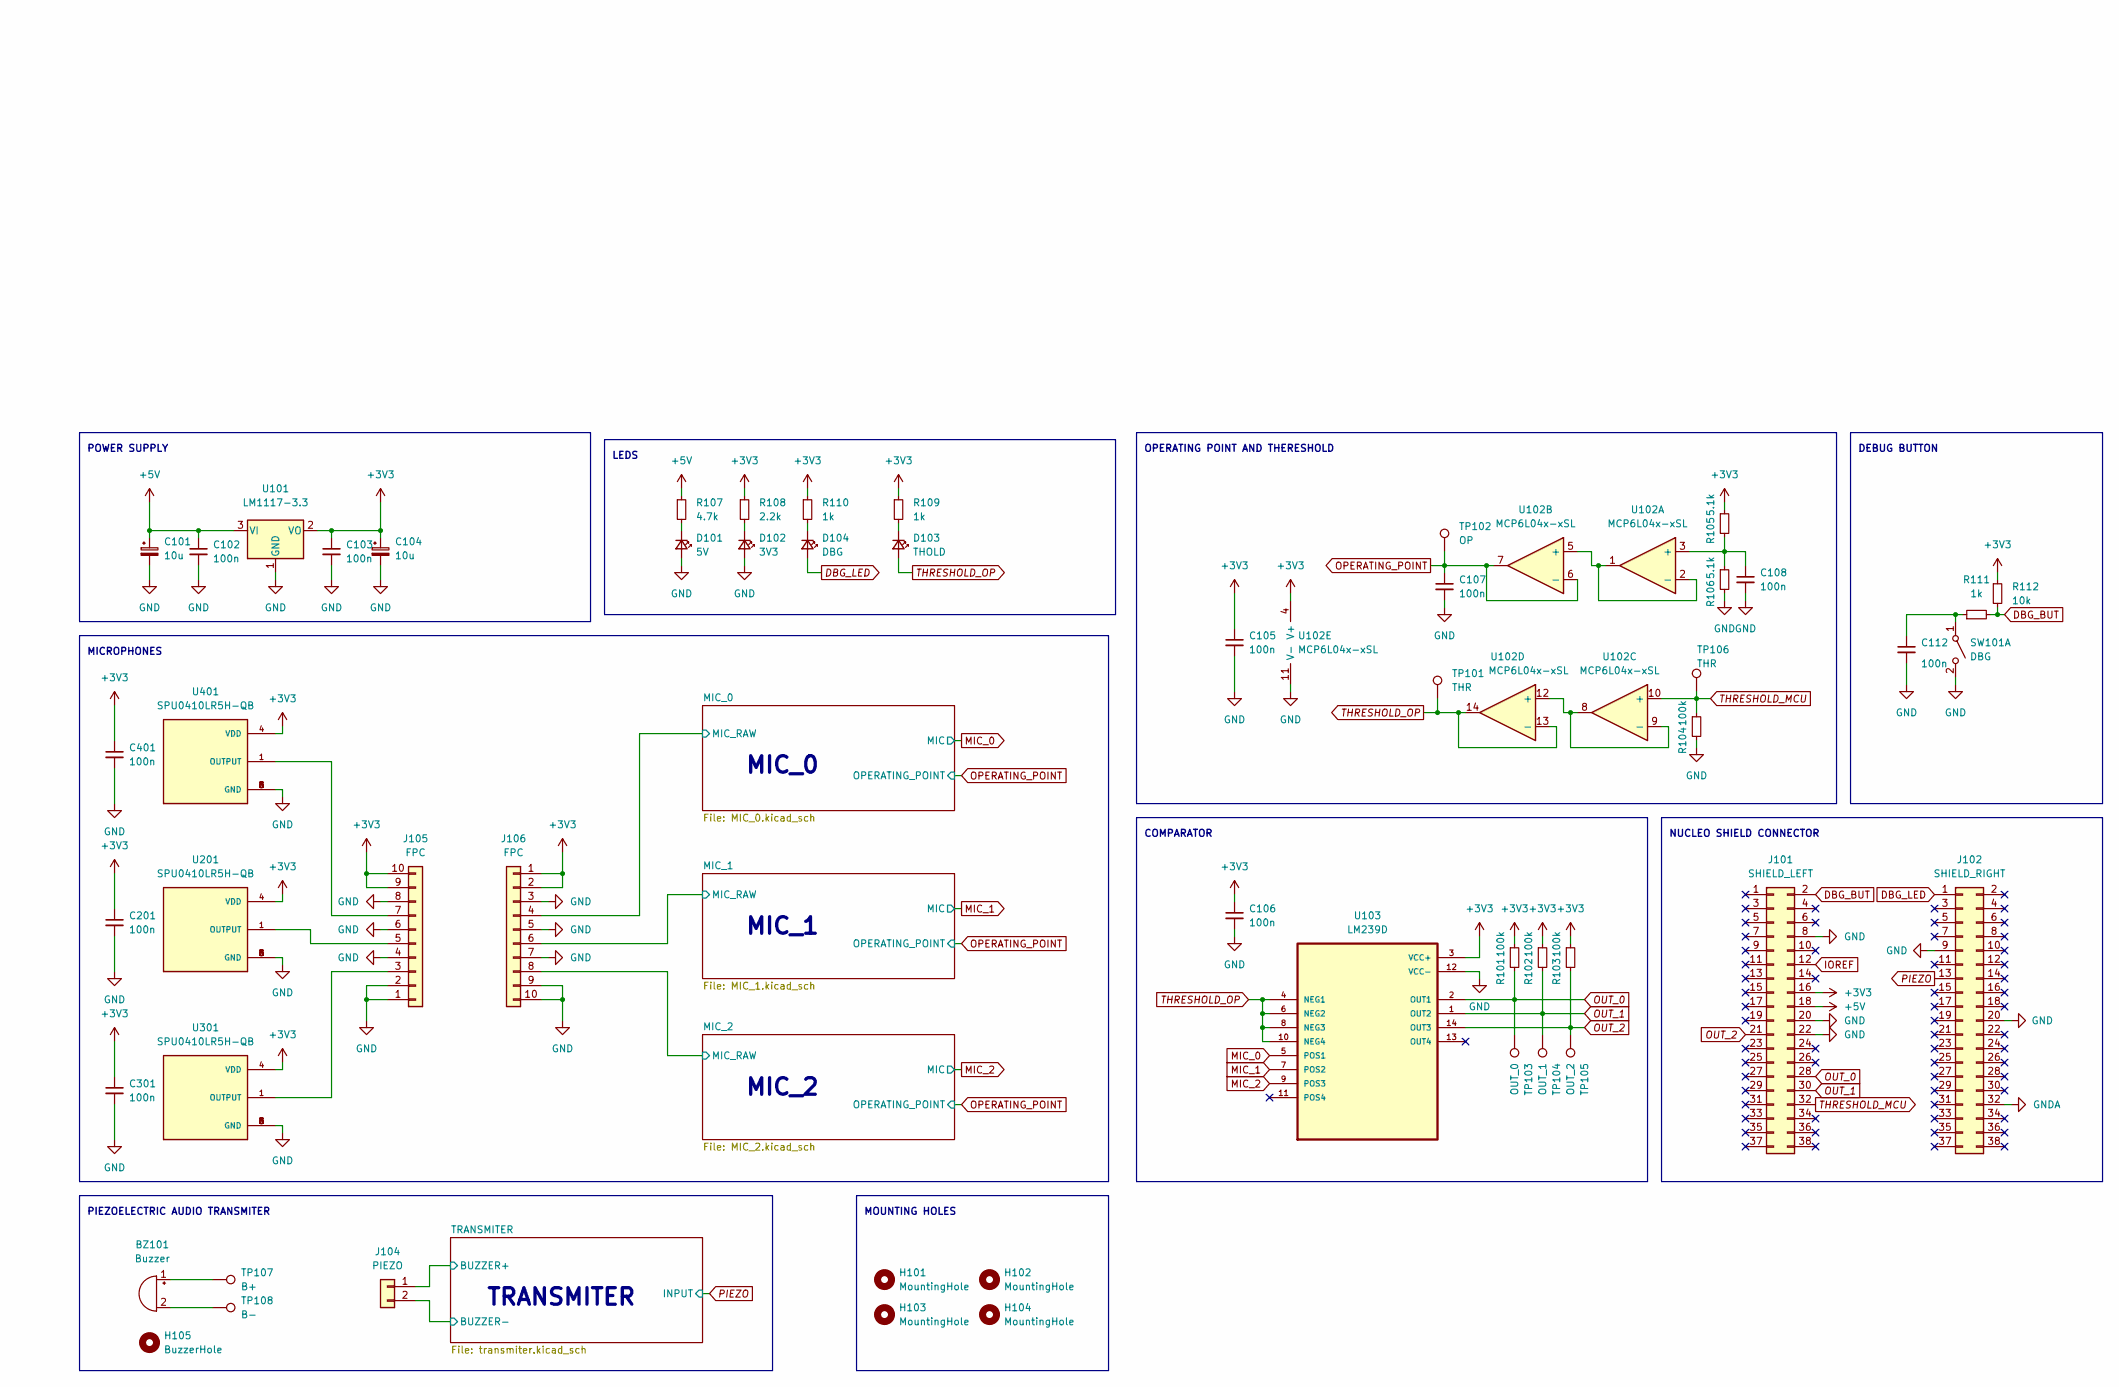
[picture p137: schematic inzynierka.kicad_sch, UltraSoundSensor, part in row 2, column 1]

Parts:
BZ101: Buzzer; Buzzer_15x7.5RM7.6
C101, C104: 10u; CP_Elec_4x3
C102, C103, C105, C106, C107, C108, C112, C201, C301, C401: 100n; C_0603_1608Metric
D101: 5V; LED_0603_1608Metric
D102: 3V3; LED_0603_1608Metric
D103: THOLD; LED_0603_1608Metric
D104: DBG; LED_0603_1608Metric
H101, H102, H103, H104: MountingHole; MountingHole_3.2mm_M3
H105: BuzzerHole; MountingHole_2.2mm_M2
J101: SHIELD_LEFT; PinSocket_2x19_P2.54mm_Vertical
J102: SHIELD_RIGHT; PinSocket_2x19_P2.54mm_Vertical
J104: PIEZO; PinHeader_1x02_P2.54mm_Vertical
J105, J106: FPC; Hirose_FH12-10S-0.5SH_1x10-1MP_P0.50mm_Horizontal
R101, R102, R103, R104: 100k; R_0603_1608Metric
R105, R106: 5.1k; R_0603_1608Metric
R107: 4.7k; R_0603_1608Metric
R108: 2.2k; R_0603_1608Metric
R109, R110, R111: 1k; R_0603_1608Metric
R112: 10k; R_0603_1608Metric
SW101: DBG; SW_SPST_TL3342
TP101, TP106: THR; TestPoint_Pad_D1.0mm
TP102: OP; TestPoint_Pad_D1.0mm
TP103: OUT_0; TestPoint_Pad_D1.0mm
TP104: OUT_1; TestPoint_Pad_D1.0mm
TP105: OUT_2; TestPoint_Pad_D1.0mm
TP107: B+; TestPoint_Pad_D2.0mm
TP108: B-; TestPoint_Pad_D2.0mm
U101: LM1117-3.3; SOT-223-3_TabPin2
U102: MCP6L04x-xSL; SOIC-14_3.9x8.7mm_P1.27mm
U103: LM239D; SOIC-14_3.9x8.7mm_P1.27mm
U201, U301, U401: SPU0410LR5H-QB; PARTREV H

Connections:
+3V3: C103.1, C104.1, C105.1, C106.1, C201.1, C301.1, C401.1, J101.16, J105.9, J105.10, J106.1, J106.2, R101.1, R102.1, R103.1, R105.1, R108.1, R109.1, R110.1, R112.1, U101.2 (VO), U102.4 (V+), U103.3 (VCC+), U201.4 (VDD), U301.4 (VDD), U401.4 (VDD); also elsewhere on the board
+5V: C101.1, C102.1, J101.18, R107.1, U101.3 (VI); also elsewhere on the board
/MIC_0/MIC_RAW: J106.4; also elsewhere on the board
/MIC_1/MIC_RAW: J106.6; also elsewhere on the board
/MIC_2/MIC_RAW: J106.8; also elsewhere on the board
/TRANSMITER/BUZZER+: J104.1; also elsewhere on the board
/TRANSMITER/BUZZER-: J104.2; also elsewhere on the board
DBG_BUT: J101.2, R111.2, R112.2
DBG_LED: D104.2 (A), J102.1
GND: C101.2, C102.2, C103.2, C104.2, C105.2, C106.2, C107.2, C108.2, C112.2, C201.2, C301.2, C401.2, D101.2 (A), D102.2 (A), J101.8, J101.20, J101.22, J102.9, J102.20, J105.1, J105.2, J105.4, J105.6, J105.8, J106.3, J106.5, J106.7, J106.9, J106.10, R104.2, R106.2, SW101.2 (B), U101.1 (GND), U102.11 (V-), U103.12 (VCC-), U201.2 (GND), U201.3 (GND), U201.5 (GND), U201.6 (GND), U301.2 (GND), U301.3 (GND), U301.5 (GND), U301.6 (GND), U401.2 (GND), U401.3 (GND), U401.5 (GND), U401.6 (GND); also elsewhere on the board
GNDA: J102.32
IOREF: J101.12
MIC_0: U103.5 (POS1); also elsewhere on the board
MIC_1: U103.7 (POS2); also elsewhere on the board
MIC_2: U103.9 (POS3); also elsewhere on the board
unnamed: BZ101.1 (-), TP107.1
unnamed: BZ101.2 (+), TP108.1
unnamed: C108.1, R105.2, R106.1, U102.3 (+)
unnamed: C112.1, R111.1, SW101.1 (A)
unnamed: D101.1 (K), R107.2
unnamed: D102.1 (K), R108.2
unnamed: D103.1 (K), R109.2
unnamed: D104.1 (K), R110.2
unnamed: J105.3, U301.1 (OUTPUT)
unnamed: J105.5, U201.1 (OUTPUT)
unnamed: J105.7, U401.1 (OUTPUT)
unnamed: U102.1, U102.2 (-), U102.5 (+)
unnamed: U102.8, U102.9 (-), U102.12 (+)
OPERATING_POINT: C107.1, TP102.1, U102.6 (-), U102.7; also elsewhere on the board
OUT_0: J101.28, R101.2, TP103.1, U103.2 (OUT1)
OUT_1: J101.30, R102.2, TP104.1, U103.1 (OUT2)
OUT_2: J101.21, R103.2, TP105.1, U103.14 (OUT3)
PIEZO: J102.13; also elsewhere on the board
THRESHOLD_MCU: J101.32, R104.1, TP106.1, U102.10 (+)
THRESHOLD_OP: D103.2 (A), TP101.1, U102.13 (-), U102.14, U103.4 (NEG1), U103.6 (NEG2), U103.8 (NEG3), U103.10 (NEG4)

Notes on the sheet:
NUCLEO SHIELD CONNECTOR
MICROPHONES
COMPARATOR
PIEZOELECTRIC AUDIO TRANSMITER
OPERATING POINT AND THERESHOLD
POWER SUPPLY
DEBUG BUTTON
TRANSMITER
MIC_1
MIC_0
LEDS
MOUNTING HOLES
MIC_2

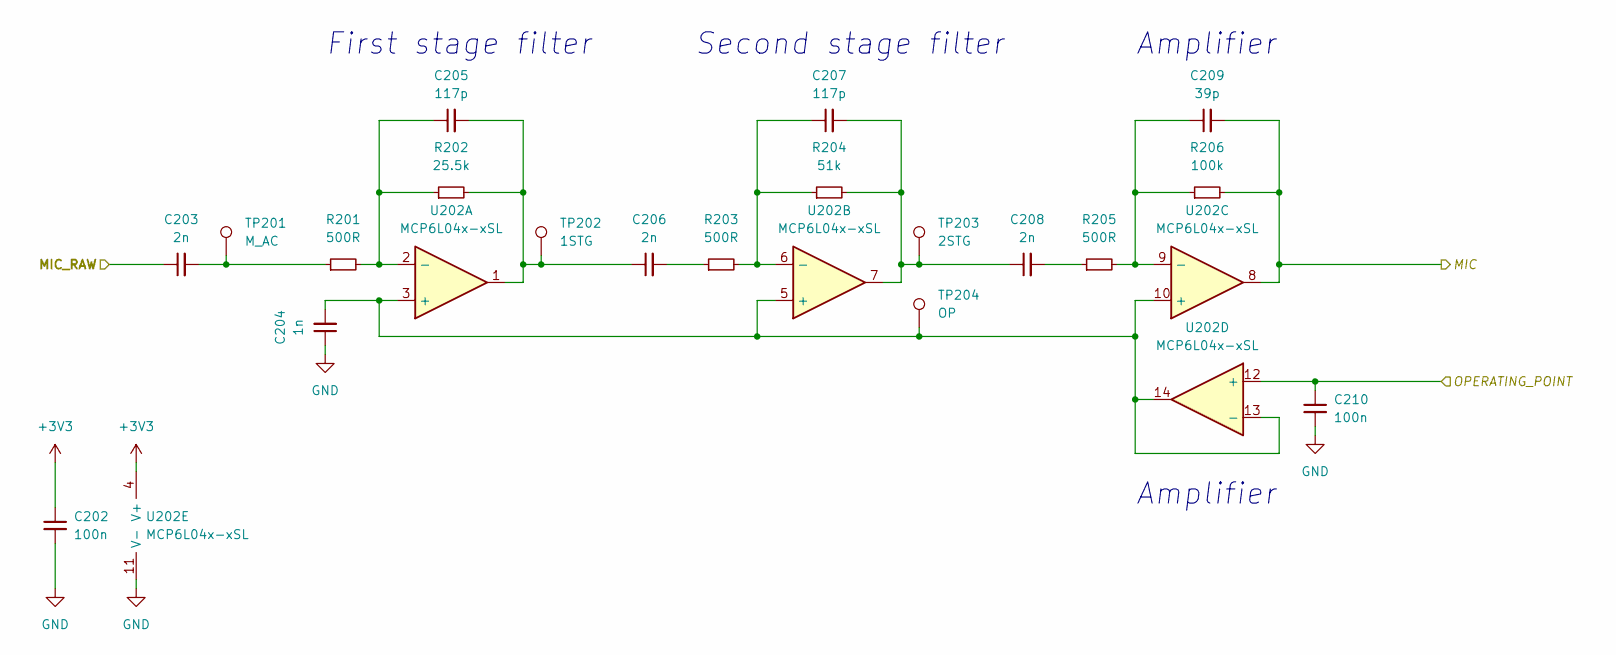
[picture p138: schematic MIC_0.kicad_sch, UltraSoundSensor]

Parts:
C202, C210: 100n; C_0603_1608Metric
C203, C206, C208: 2n; C_0603_1608Metric
C204: 1n; C_0603_1608Metric
C205, C207: 117p; C_0603_1608Metric
C209: 39p; C_0603_1608Metric
R201, R203, R205: 500R; R_0603_1608Metric
R202: 25.5k; R_0603_1608Metric
R204: 51k; R_0603_1608Metric
R206: 100k; R_0603_1608Metric
TP201: M_AC; TestPoint_Pad_D1.0mm
TP202: 1STG; TestPoint_Pad_D1.0mm
TP203: 2STG; TestPoint_Pad_D1.0mm
TP204: OP; TestPoint_Pad_D1.0mm
U202: MCP6L04x-xSL; SOIC-14_3.9x8.7mm_P1.27mm

Connections:
+3V3: C202.1, U202.4 (V+); also elsewhere on the board
/MIC_0/MIC_RAW: C203.1; also elsewhere on the board
GND: C202.2, C204.1, C210.2, U202.11 (V-); also elsewhere on the board
MIC_0: C209.2, R206.2, U202.8; also elsewhere on the board
unnamed: C203.2, R201.1, TP201.1
unnamed: C204.2, TP204.1, U202.3 (+), U202.5 (+), U202.10 (+), U202.13 (-), U202.14
unnamed: C205.1, R201.2, R202.1, U202.2 (-)
unnamed: C205.2, C206.1, R202.2, TP202.1, U202.1
unnamed: C206.2, R203.1
unnamed: C207.1, R203.2, R204.1, U202.6 (-)
unnamed: C207.2, C208.1, R204.2, TP203.1, U202.7
unnamed: C208.2, R205.1
unnamed: C209.1, R205.2, R206.1, U202.9 (-)
OPERATING_POINT: C210.1, U202.12 (+); also elsewhere on the board

Notes on the sheet:
Amplifier
First stage filter
Second stage filter

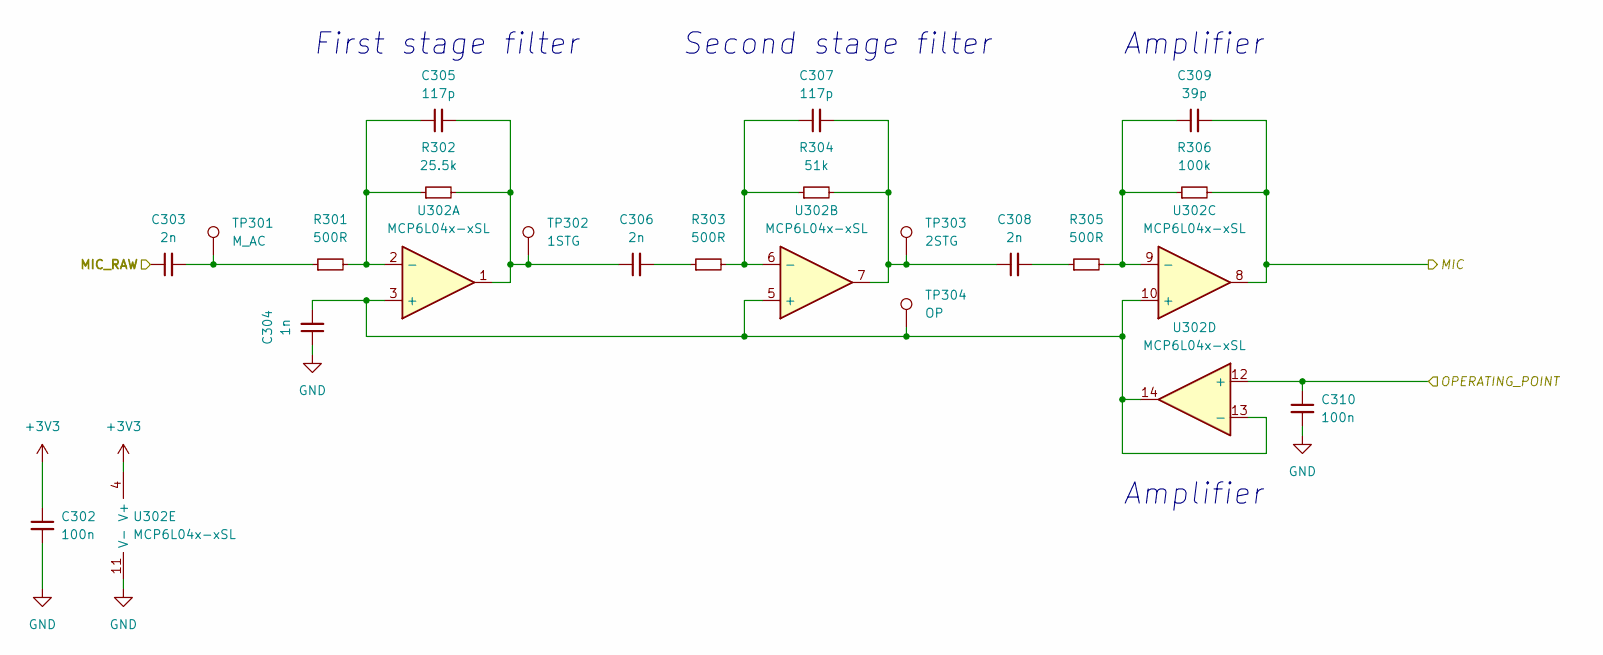
[picture p139: schematic MIC_1.kicad_sch, UltraSoundSensor]

Parts:
C302, C310: 100n; C_0603_1608Metric
C303, C306, C308: 2n; C_0603_1608Metric
C304: 1n; C_0603_1608Metric
C305, C307: 117p; C_0603_1608Metric
C309: 39p; C_0603_1608Metric
R301, R303, R305: 500R; R_0603_1608Metric
R302: 25.5k; R_0603_1608Metric
R304: 51k; R_0603_1608Metric
R306: 100k; R_0603_1608Metric
TP301: M_AC; TestPoint_Pad_D1.0mm
TP302: 1STG; TestPoint_Pad_D1.0mm
TP303: 2STG; TestPoint_Pad_D1.0mm
TP304: OP; TestPoint_Pad_D1.0mm
U302: MCP6L04x-xSL; SOIC-14_3.9x8.7mm_P1.27mm

Connections:
+3V3: C302.1, U302.4 (V+); also elsewhere on the board
/MIC_1/MIC_RAW: C303.1; also elsewhere on the board
GND: C302.2, C304.1, C310.2, U302.11 (V-); also elsewhere on the board
MIC_1: C309.2, R306.2, U302.8; also elsewhere on the board
unnamed: C303.2, R301.1, TP301.1
unnamed: C304.2, TP304.1, U302.3 (+), U302.5 (+), U302.10 (+), U302.13 (-), U302.14
unnamed: C305.1, R301.2, R302.1, U302.2 (-)
unnamed: C305.2, C306.1, R302.2, TP302.1, U302.1
unnamed: C306.2, R303.1
unnamed: C307.1, R303.2, R304.1, U302.6 (-)
unnamed: C307.2, C308.1, R304.2, TP303.1, U302.7
unnamed: C308.2, R305.1
unnamed: C309.1, R305.2, R306.1, U302.9 (-)
OPERATING_POINT: C310.1, U302.12 (+); also elsewhere on the board

Notes on the sheet:
Amplifier
First stage filter
Second stage filter

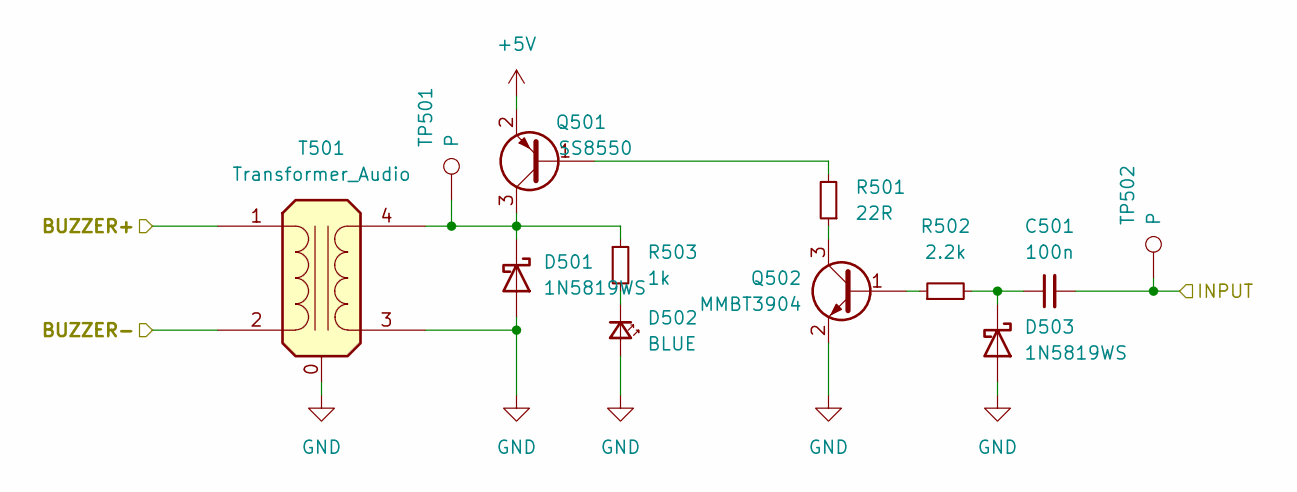
[picture p140: schematic transmiter.kicad_sch, UltraSoundSensor]

Parts:
C501: 100n; C_0603_1608Metric
D501, D503: 1N5819WS; D_SOD-323
D502: BLUE; LED_0603_1608Metric
Q501: SS8550; SOT-23
Q502: MMBT3904; SOT-23
R501: 22R; R_0603_1608Metric
R502: 2.2k; R_0603_1608Metric
R503: 1k; R_0603_1608Metric
T501: Transformer_Audio; Transformer_shielded_8x13.5
TP501, TP502: P; TestPoint_Pad_D1.0mm

Connections:
+5V: Q501.2 (E); also elsewhere on the board
/TRANSMITER/BUZZER+: T501.1 (AA); also elsewhere on the board
/TRANSMITER/BUZZER-: T501.2 (AB); also elsewhere on the board
GND: D501.2 (A), D502.2 (A), D503.2 (A), Q502.2 (E), T501.0, T501.3 (SA); also elsewhere on the board
unnamed: C501.1, D503.1 (K), R502.2
unnamed: D501.1 (K), Q501.3 (C), R503.1, T501.4 (SB), TP501.1
unnamed: D502.1 (K), R503.2
unnamed: Q501.1 (B), R501.2
unnamed: Q502.1 (B), R502.1
unnamed: Q502.3 (C), R501.1
PIEZO: C501.2, TP502.1; also elsewhere on the board

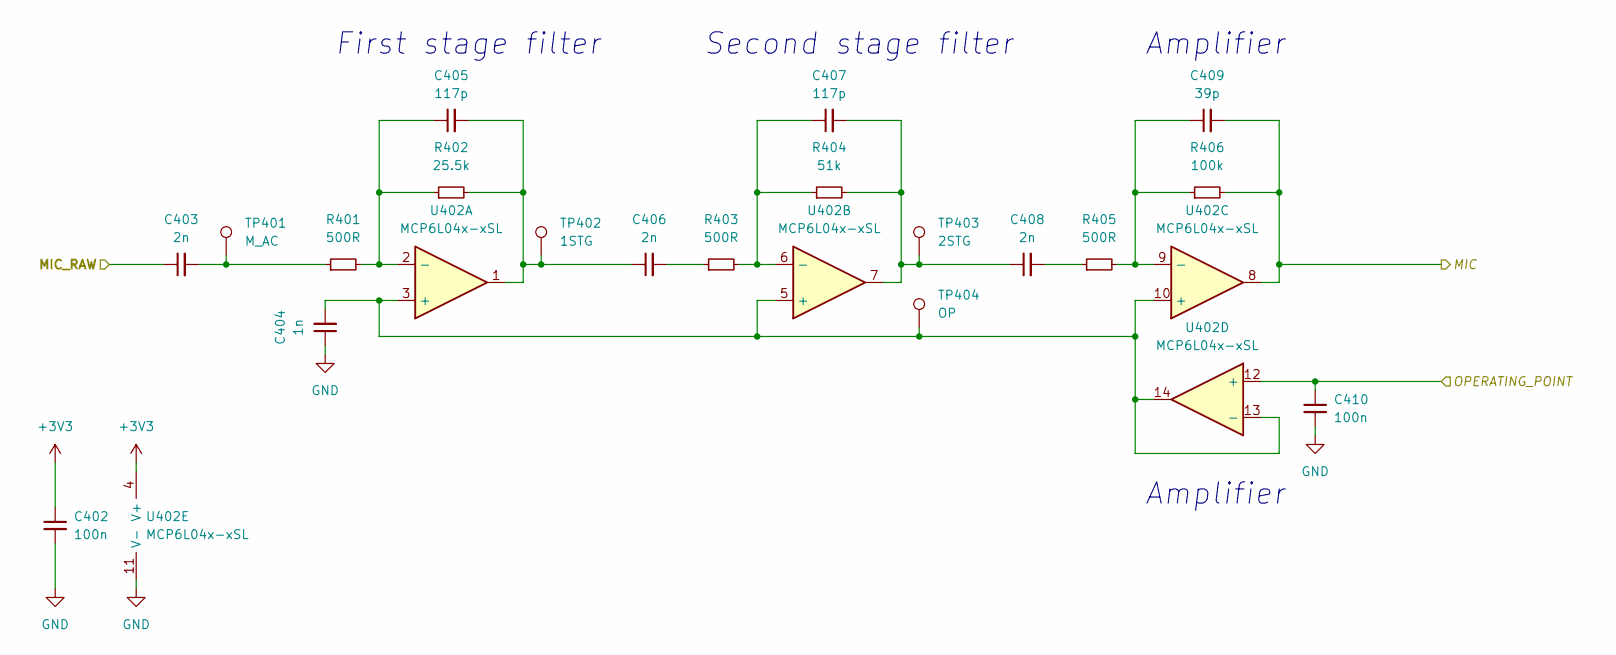
[picture p141: schematic MIC_2.kicad_sch, UltraSoundSensor]

Parts:
C402, C410: 100n; C_0603_1608Metric
C403, C406, C408: 2n; C_0603_1608Metric
C404: 1n; C_0603_1608Metric
C405, C407: 117p; C_0603_1608Metric
C409: 39p; C_0603_1608Metric
R401, R403, R405: 500R; R_0603_1608Metric
R402: 25.5k; R_0603_1608Metric
R404: 51k; R_0603_1608Metric
R406: 100k; R_0603_1608Metric
TP401: M_AC; TestPoint_Pad_D1.0mm
TP402: 1STG; TestPoint_Pad_D1.0mm
TP403: 2STG; TestPoint_Pad_D1.0mm
TP404: OP; TestPoint_Pad_D1.0mm
U402: MCP6L04x-xSL; SOIC-14_3.9x8.7mm_P1.27mm

Connections:
+3V3: C402.1, U402.4 (V+); also elsewhere on the board
/MIC_2/MIC_RAW: C403.1; also elsewhere on the board
GND: C402.2, C404.1, C410.2, U402.11 (V-); also elsewhere on the board
MIC_2: C409.2, R406.2, U402.8; also elsewhere on the board
unnamed: C403.2, R401.1, TP401.1
unnamed: C404.2, TP404.1, U402.3 (+), U402.5 (+), U402.10 (+), U402.13 (-), U402.14
unnamed: C405.1, R401.2, R402.1, U402.2 (-)
unnamed: C405.2, C406.1, R402.2, TP402.1, U402.1
unnamed: C406.2, R403.1
unnamed: C407.1, R403.2, R404.1, U402.6 (-)
unnamed: C407.2, C408.1, R404.2, TP403.1, U402.7
unnamed: C408.2, R405.1
unnamed: C409.1, R405.2, R406.1, U402.9 (-)
OPERATING_POINT: C410.1, U402.12 (+); also elsewhere on the board

Notes on the sheet:
Amplifier
First stage filter
Second stage filter

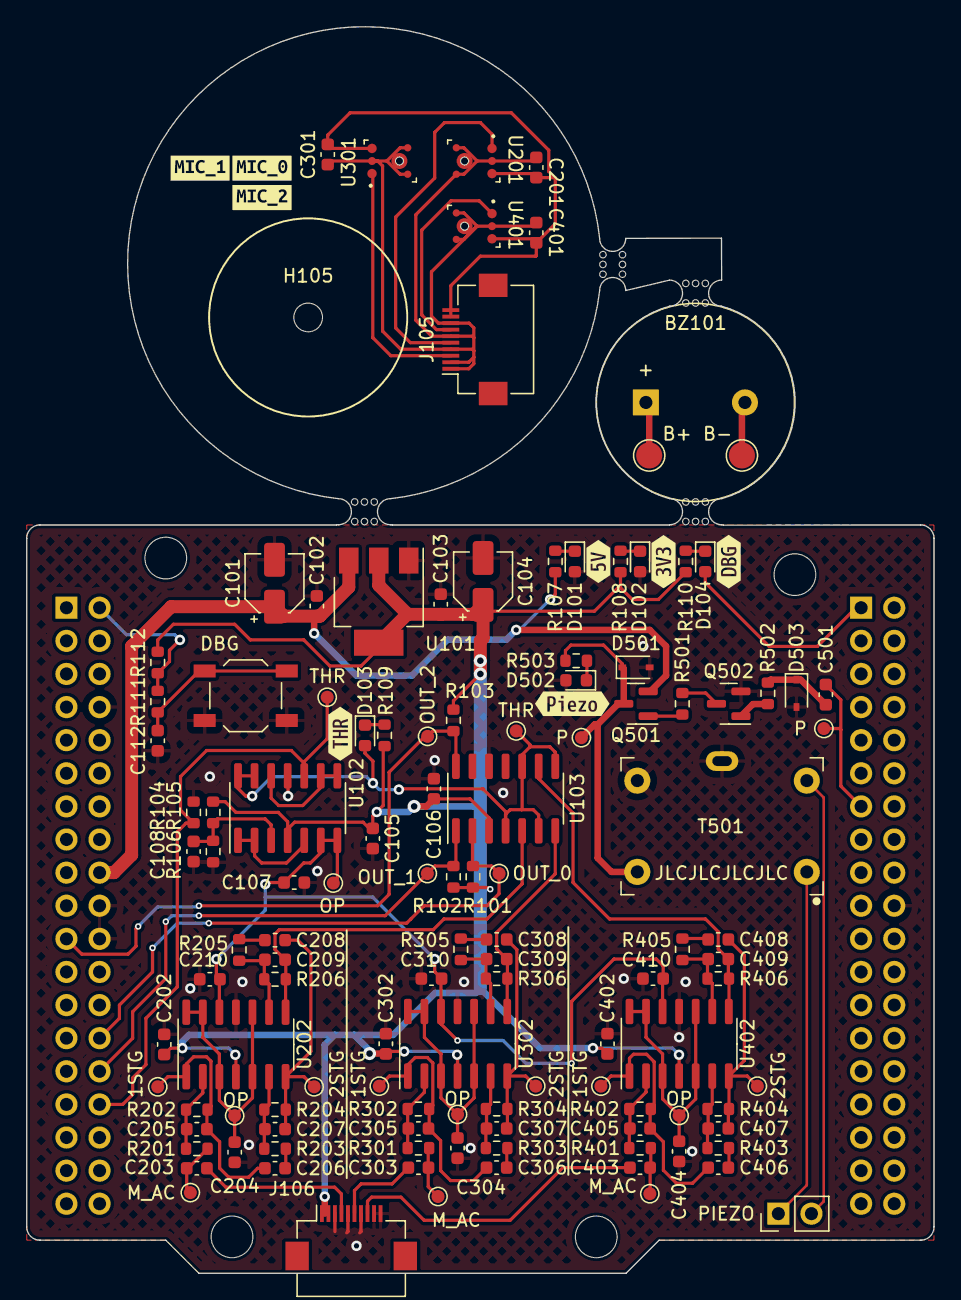
[picture p142: board inzynierka.kicad_pcb from above]

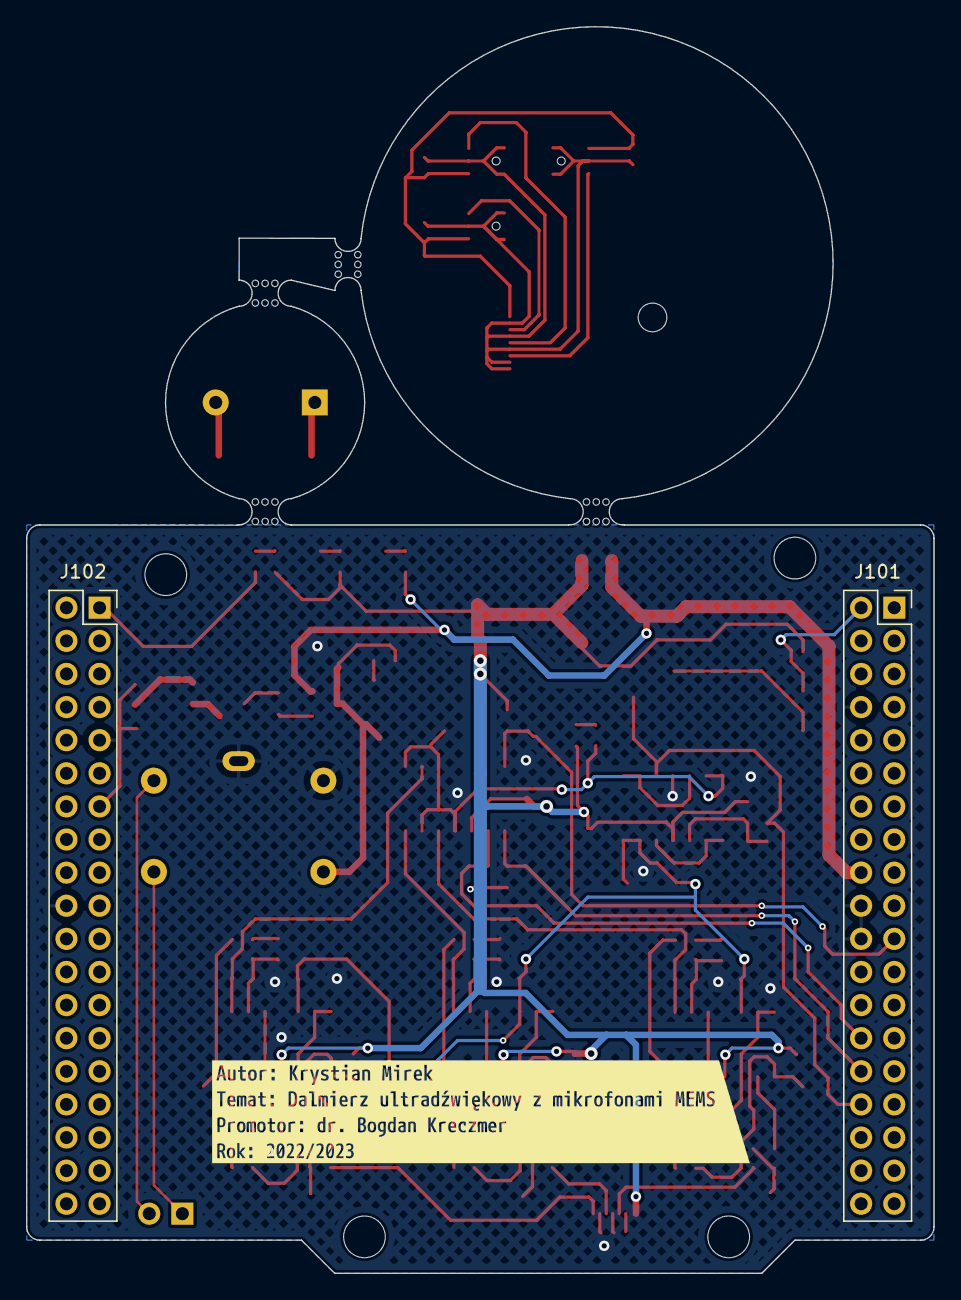
[picture p143: board inzynierka.kicad_pcb from below]

Board: 2 copper layers, 69.6 x 95.6 mm, 139 parts (3 on the bottom side), 66 nets.

Other parts of the board:
kibuzzard-6361BCC4: G***; kibuzzard-6361BCC4
kibuzzard-6361BD6E: G***; kibuzzard-6361BD6E
kibuzzard-6361BD58: G***; kibuzzard-6361BD58
kibuzzard-6361BD82: G***; kibuzzard-6361BD82
kibuzzard-6361C7A3: G***; kibuzzard-6361C7A3
kibuzzard-6361C7DF: G***; kibuzzard-6361C7DF
kibuzzard-636196D3: G***; kibuzzard-636196D3
kibuzzard-636196F7: G***; kibuzzard-636196F7
kibuzzard-636196FE: G***; kibuzzard-636196FE
mouse-bite-2mm-slot, mouse-bite-2mm-slot#2, mouse-bite-2mm-slot#3, mouse-bite-2mm-slot#4: VAL**; mouse-bite-2mm-slot
