kaszmirek/Inzynierka/mcu_config/sonar/Src/main.c

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
/* Includes ------------------------------------------------------------------*/
#include "main.h"
#include "dac.h"
#include "tim.h"
#include "usart.h"
#include "gpio.h"

/* USER CODE BEGIN Includes */
#include <stdio.h>
#include "stdbool.h"
#include "serial.h"
#include "retarget.h"
#include "global_variables.h"
#include "comunication.h"
// #include "comunication.h"
/* USER CODE END Includes */


/* USER CODE BEGIN PV */
uint8_t UART2_rxBuffer[20] = {0};
bool msg_flag = 0;
uint32_t thereshold = 0;
/* USER CODE END PV */

void SystemClock_Config(void);
/**
  * @brief  The application entry point.
  * @retval int
  */
int main(void)
{
  /* MCU Configuration--------------------------------------------------------*/

  /* Reset of all peripherals, Initializes the Flash interface and the Systick. */
  HAL_Init();

  /* Configure the system clock */
  SystemClock_Config();

  /* Initialize all configured peripherals */
  MX_GPIO_Init();
  MX_DAC1_Init();
  MX_TIM2_Init();
  MX_USART2_UART_Init();
  MX_TIM16_Init();
  MX_TIM5_Init();
  MX_TIM8_Init();
  /* USER CODE BEGIN 2 */
  set_thereshold(2700);
  RetargetInit(&huart2);
  serial_init(&huart2);
  HAL_DAC_Start(&hdac1, DAC_CHANNEL_1);
  HAL_DAC_SetValue(&hdac1, DAC_CHANNEL_1, DAC_ALIGN_12B_R, get_thereshold()); // default value
  HAL_TIM_IC_Init(&htim2);
  HAL_TIM_OnePulse_Start_IT(&htim5, TIM_CHANNEL_1);
  HAL_TIM_OnePulse_Start_IT(&htim8, TIM_CHANNEL_1);
  HAL_TIM_OnePulse_Start_IT(&htim16, TIM_CHANNEL_1);
  TIM16->RCR = 0; // one pulse
  /* USER CODE END 2 */

  /* Infinite loop */
  /* USER CODE BEGIN WHILE */
  while (1)
  {
    MsgHandler();

    /* USER CODE END WHILE */

    /* USER CODE BEGIN 3 */
  }
  /* USER CODE END 3 */
}

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
