kaszmirek/Inzynierka/mcu_config/sonar/Inc/main.h

#define DEFAULT_PULSE_COUNT 4
#define B1_Pin GPIO_PIN_13
#define B1_GPIO_Port GPIOC
#define MIC_0_Pin GPIO_PIN_0
#define MIC_0_GPIO_Port GPIOA
#define MIC_1_Pin GPIO_PIN_1
#define MIC_1_GPIO_Port GPIOA
#define USART_TX_Pin GPIO_PIN_2
#define USART_TX_GPIO_Port GPIOA
#define USART_RX_Pin GPIO_PIN_3
#define USART_RX_GPIO_Port GPIOA
#define THR_Pin GPIO_PIN_4
#define THR_GPIO_Port GPIOA
#define LD2_Pin GPIO_PIN_5
#define LD2_GPIO_Port GPIOA
#define PIEZO_Pin GPIO_PIN_6
#define PIEZO_GPIO_Port GPIOA
#define MIC_2_Pin GPIO_PIN_10
#define MIC_2_GPIO_Port GPIOB
#define DBG_LED_Pin GPIO_PIN_9
#define DBG_LED_GPIO_Port GPIOC
#define TMS_Pin GPIO_PIN_13
#define TMS_GPIO_Port GPIOA
#define TCK_Pin GPIO_PIN_14
#define TCK_GPIO_Port GPIOA
#define DBG_BUT_Pin GPIO_PIN_11
#define DBG_BUT_GPIO_Port GPIOC
#define SWO_Pin GPIO_PIN_3
#define SWO_GPIO_Port GPIOB
#define OLD_MIC_2_Pin GPIO_PIN_7
#define OLD_MIC_2_GPIO_Port GPIOB
