kaszmirek/Inzynierka/(commit log)

2022-10-29 shield shape
    [inzynierka.kicad_pcb, inzynierka.kicad_sch, transmiter.kicad_sch]
2022-11-02 skonczone pcb
    [MIC_0.kicad_sch, MIC_1.kicad_sch, MIC_2.kicad_sch, inzynierka.kicad_pcb, inzynierka.kicad_sch, transmiter.kicad_sch]
2022-11-02 production files
    [BOM-inzynierka.csv, MIC_0.kicad_sch, MIC_1.kicad_sch, MIC_2.kicad_sch, bom.csv, designators.csv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]
2022-11-07 poprawione gerbery
    [BOM-inzynierka.csv, bom.csv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]
2022-11-07 poprawione gerbery na pewno
    [BOM-inzynierka.csv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]
2022-11-27 progress in thesis
    [inzynierka.kicad_sch]
2022-12-20 progress before last consultation
    [transmiter.kicad_sch]
2022-12-22 gotowa praca dyplomowa
    [MIC_0.kicad_sch, inzynierka.kicad_sch]
